SVN11X/doc_tesis/main.tex

\documentclass[letterpaper,12pt]{report}

\usepackage[english]{tracklang}

\usepackage[spanish,es-nodecimaldot,activeacute,es-lcroman]{babel}

\usepackage[no-math]{fontspec}
\setmainfont{Arial}

\usepackage{textcomp}
\usepackage{microtype}

\usepackage{amsmath}
\usepackage{amssymb}

\usepackage[defaultmathsizes]{mathastext}

% Letras griegas en la misma tipografía del texto (Arial).
% mathastext ya convierte las letras latinas; las griegas se redefinen aquí
% para que no queden con la tipografía por defecto de LaTeX.
\newfontfamily\utemgriega{Arial}

\newcommand{\utemgrk}[1]{\ensuremath{\mathord{\text{\utemgriega #1}}}}
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
\vspace{1ex}
\UTEMPaginaHeader\par\vspace{1ex}
\begingroup
\singlespacing
\setlength{\parskip}{0pt}
\setlength{\parindent}{0pt}
\@afterheading
\@starttoc{toc}
\endgroup
\clearpage
}

\renewcommand{\listoffigures}{
\clearpage
{\centering\normalfont\normalsize\bfseries \listfigurename\par}
\vspace{1ex}
\UTEMPaginaHeader\par\vspace{1ex}
\begingroup
\singlespacing
\setlength{\parskip}{0pt}
\setlength{\parindent}{0pt}
\@afterheading
\@starttoc{lof}
\endgroup
\clearpage
}

\renewcommand{\listoftables}{
\clearpage
{\centering\normalfont\normalsize\bfseries \listtablename\par}
\vspace{1ex}
\UTEMPaginaHeader\par\vspace{1ex}
\begingroup
\singlespacing
\setlength{\parskip}{0pt}
\setlength{\parindent}{0pt}
\@afterheading
\@starttoc{lot}
\endgroup
\clearpage
}

\providecommand{\l@algorithm}{}
\renewcommand{\l@algorithm}{\@dottedtocline{1}{1.5em}{2.3em}}
\renewcommand{\listofalgorithms}{
\clearpage
{\centering\normalfont\normalsize\bfseries ÍNDICE DE ALGORITMOS\par}
\vspace{1ex}
\UTEMPaginaHeader\par\vspace{1ex}
\begingroup
\singlespacing
\setlength{\parskip}{0pt}
\setlength{\parindent}{0pt}
\@afterheading
\@starttoc{loa}
\endgroup
\clearpage
}

\makeatother

\DeclareCaptionLabelFormat{utemfig}{Figura~#2}
\captionsetup[figure]{
labelformat=utemfig,
labelsep=colon,
labelfont=bf,
textfont=normalfont,
justification=centering,
singlelinecheck=false,
position=below
}

\DeclareCaptionLabelFormat{utemtab}{Tabla~#2}
\captionsetup[table]{
labelformat=utemtab,
labelsep=colon,
labelfont=bf,
textfont=normalfont
}

\usepackage{fancyhdr}

\pagestyle{fancy}
\fancyhf{}
\fancyfoot[R]{\thepage}
\renewcommand{\headrulewidth}{0pt}
\renewcommand{\footrulewidth}{0pt}

\fancypagestyle{plain}{
\fancyhf{}
\fancyfoot[R]{\thepage}
\renewcommand{\headrulewidth}{0pt}
\renewcommand{\footrulewidth}{0pt}
}

\usepackage{appendix}

\usepackage{xurl}
\urlstyle{same}

\usepackage[hidelinks]{hyperref}

\usepackage[toc]{glossaries}
\makeglossaries
\loadglsentries{3.Pag_final/3.glosario.tex}
\renewcommand{\glossaryname}{GLOSARIO}

\usepackage{csquotes}

\usepackage[
backend=biber,
style=apa,
natbib=true,
sortcites=true,
maxcitenames=2,
giveninits=true,
doi=true,
isbn=false,
eprint=false,
url=true
]{biblatex}

\addbibresource{referencias.bib}
\DeclareLanguageMapping{spanish}{spanish-apa}

\defbibenvironment{bibnum}
{\RaggedRight\begin{enumerate}[
label=\arabic*.,
leftmargin=*,
itemsep=0pt,
topsep=0pt,
align=left
]}
{\end{enumerate}}
{\item}

\newcommand{\utemFigure}[5]{
\begin{figure}[htbp]
\centering

\setlength{\fboxsep}{6pt}
\fbox{

}

\vspace{4pt}

\caption{#3}
\label{#5}

\vspace{2pt}

{\footnotesize\textit{Fuente: \citep{#4}.}}
\end{figure}
}

\newcommand{\utemFigurePropia}[4]{
\begin{figure}[htbp]
\centering

\setlength{\fboxsep}{6pt}
\fbox{

}

\vspace{4pt}

\caption{#3}
\label{#4}

\vspace{2pt}

{\footnotesize\textit{Fuente: Elaboración propia.}}
\end{figure}
}

\newenvironment{utemMultiFigure}[2]{
\def\utemMFcapt{#1}
\def\utemMFlab{#2}
\begin{figure}[H]
\centering
\setlength{\fboxsep}{6pt}
\providecommand{\addutem}{}
\renewcommand{\addutem}[4]{
\begin{subfigure}[b]{##1\textwidth}
\centering
\fbox{

}
\caption{##3}
\vspace{2pt}

{\footnotesize\textit{Fuente: \citep{##4}.}}
\end{subfigure}
}
}{
\vspace{4pt}
\caption{\utemMFcapt}
\label{\utemMFlab}
\end{figure}
}

\newenvironment{utemMultiFigurePropia}[2]{
\def\utemMFcapt{#1}
\def\utemMFlab{#2}
\begin{figure}[htbp]
\centering
\setlength{\fboxsep}{6pt}
\providecommand{\addutem}{}
\renewcommand{\addutem}[3]{
\begin{subfigure}[b]{##1\textwidth}
\centering
\fbox{

}
\caption{##3}
\end{subfigure}
}
}{
\vspace{4pt}
\caption{\utemMFcapt}
\label{\utemMFlab}

\vspace{2pt}

{\footnotesize\textit{Fuente: Elaboración propia.}}
\end{figure}
}

\newcounter{objEsp}
\newcommand{\ObEsp}{
\refstepcounter{objEsp}
OE\theobjEsp
}

\providecommand*{\objEspautorefname}{OE}

\sloppy

\begin{document}

\pagenumbering{roman}
\include{1-PagPreliminar/portada.tex}

\setcounter{page}{2}

\include{1-PagPreliminar/derecho_autor.tex}
\include{1-PagPreliminar/Nota.tex}
\include{1-PagPreliminar/dedicatoria.tex}
\include{1-PagPreliminar/agradecimiento.tex}

\clearpage
\tableofcontents
\clearpage
\listoftables
\clearpage
\listoffigures
\clearpage
\listofalgorithms
\clearpage

\include{1-PagPreliminar/resumen.tex}

\cleardoublepage
\pagenumbering{arabic}

\include{2.Texto/1.Intro.tex}
\include{2.Texto/2.estado_arte.tex}
\include{2.Texto/3.solucion_implementada.tex}
\include{2.Texto/4.marco_teorico.tex}
\include{2.Texto/5.implementacion.tex}
\include{2.Texto/6.resultados.tex}
\include{2.Texto/99.conclusion.tex}

\begingroup
\doublespacing
\printbibliography[
heading=bibintoc,
title={BIBLIOGRAFÍA},
env=bibnum
]
\endgroup

\printglossary[
title={GLOSARIO},
toctitle={GLOSARIO}
]

\begingroup
\singlespacing
\setlength{\parskip}{0pt}
\include{3.Pag_final/anexo.tex}
\endgroup

\end{document}
