SVN11X/doc_tesis/1-PagPreliminar/derecho_autor.tex

\begingroup
\newgeometry{top=2.0cm,bottom=2.2cm,left=2.0cm,right=2.0cm}

% Marcador del PDF (panel lateral). No se agrega a la tabla de contenido.
\pdfbookmark[0]{AUTORIZACIÓN DE REPRODUCCIÓN}{autorizacion}

\small
\setlength{\parindent}{0pt}
\setlength{\parskip}{0pt}
\setlength{\tabcolsep}{5pt}
\renewcommand{\arraystretch}{1.12}

\begin{center}
\textbf{Autorización para la Reproducción del Trabajo de Titulación}
\end{center}

\vspace{0.8cm}

1. Identificación del trabajo de titulación

\vspace{0.35cm}

Nombre del alumno\\[-0.05cm]
\mbox{}\dotfill\\[-0.05cm]
RUT \dotfill\\[-0.05cm]
Dirección \dotfill\\[-0.05cm]
E-mail \dotfill\\[-0.05cm]
Teléfono \dotfill

\vspace{0.45cm}

Título de la tesis\\[-0.05cm]
\mbox{}\dotfill\\[-0.05cm]
Escuela \dotfill\\[-0.05cm]
Carrera o programa \dotfill\\[-0.05cm]
Título al que opta \dotfill

\vspace{0.45cm}

2. Autorización de Reproducción (seleccione una opción)

\vspace{0.25cm}

\noindent a)
\hspace{1.0cm}
\begin{minipage}[t]{0.84\textwidth}
Este trabajo de titulación no puede reproducirse o transmitirse bajo ninguna forma o por ningún medio o procedimiento, sin permiso escrito del autor, exceptuando la cita bibliográfica, resumen y metadatos que acreditan al trabajo y a su autor.

\vspace{0.75cm}

Fecha: \rule{36mm}{0.1mm}
\hspace{2.2cm}
Firma: \rule{55mm}{0.1mm}
\end{minipage}

\vspace{0.9cm}

\noindent b)
\hspace{1.0cm}
\begin{minipage}[t]{0.84\textwidth}
Se autoriza la reproducción total o parcial de este trabajo de titulación, con fines académicos, por cualquier medio o procedimiento, incluyendo la cita bibliográfica que acredita al trabajo y a su autor.

\vspace{0.35cm}

En consideración a lo anterior, se autoriza su reproducción de forma (marque con una X):
\end{minipage}

\vspace{0.25cm}

\noindent
\begin{tabular}{|p{2.2cm}|p{\dimexpr\textwidth-2.2cm-4\tabcolsep-3\arrayrulewidth}|}
\hline
& Inmediata \\ \hline
& A partir de la siguiente fecha: \rule{28mm}{0.1mm} (mes/año) \\ \hline
\end{tabular}

\vspace{0.85cm}

\hspace{1.55cm}
Fecha: \rule{36mm}{0.1mm}
\hspace{2.2cm}
Firma: \rule{55mm}{0.1mm}

\vfill

Esta autorización se otorga en el marco de la ley N°17.336 sobre Propiedad Intelectual, con carácter gratuito y no exclusivo para la Institución.

\restoregeometry
\endgroup
