SVN11X/doc_tesis/1-PagPreliminar/Nota.tex

\thispagestyle{fancy}

% Marcador del PDF (panel lateral). No se agrega a la tabla de contenido.
\pdfbookmark[0]{NOTA OBTENIDA}{nota}

\vspace*{0.6 cm}

\begin{flushright}
\begin{minipage}{7.5cm}
    \centering

    {\Large\textbf{NOTA OBTENIDA:}}

    \vspace{3cm}

    \rule{7cm}{0.4pt}

    \vspace{0.4cm}

    {\large Firma y timbre de la}\\
    {\large autoridad responsable}
\end{minipage}
\end{flushright}
