SVN11X/doc_tesis/1-PagPreliminar/portada.tex

\begin{titlepage}
    \thispagestyle{empty}  % sin número de página
    % Marcador del PDF (panel lateral). No se agrega a la tabla de contenido.
    \pdfbookmark[0]{PORTADA}{portada}

    % Logo a la izquierda (sin entorno picture)
    \noindent
    \begin{minipage}{0.15\textwidth}
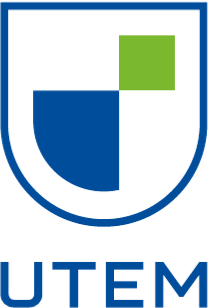
[picture p1: 1-PagPreliminar/logo_utem_oficial_2025_transparente_v2.png]
        
    \end{minipage}
    \begin{minipage}{0.8\textwidth}
        \small
        UNIVERSIDAD TECNOLÓGICA METROPOLITANA \\
        FACULTAD DE INGENIERÍA \\
        DEPARTAMENTO DE ELECTRICIDAD \\
        ESCUELA DE ELECTRÓNICA
    \end{minipage}

    \vfill  % empuja el contenido hacia abajo

    \begin{center}
        {\Large \textbf{NAVEGACIÓN Y EXPLORACIÓN AUTÓNOMA DE INTERIORES UTILIZANDO UN ROBOT MÓVIL DE TRACCIÓN DIFERENCIAL} \par}
        \vspace{1cm}
        {\Large TRABAJO DE TITULACIÓN PARA OPTAR AL TÍTULO DE INGENIERO CIVIL ELECTRÓNICO \par}
    \end{center}

    \vfill

    \begin{flushright}
        {\Large \textbf{AUTOR:} \par}
        {\Large VALDERAS NECULQUEO, SEBASTIÁN \par}
        \vspace{1cm}
        {\Large \textbf{PROFESOR GUÍA:} \par}
        {\Large GALARCE ACEVEDO, PATRICIO \par}
    \end{flushright}

    \vfill
    \vfill  % doble vfill para separar más antes de la ciudad/fecha

    \begin{center}
        {\Large SANTIAGO - CHILE \par}
        {\Large 2026 \par}
    \end{center}

\end{titlepage}
