SVN11X/doc_tesis/2.Texto/5.implementacion.tex

\chapter{IMPLEMENTACIÓN}
\label{ch:implementacion}

Este capítulo describe la materialización de la solución implementada y la
integración de sus principales componentes. Se presentan las decisiones de
diseño, los elementos físicos y de \textit{software} utilizados, y la configuración
necesaria para la operación del prototipo tanto en simulación como en \textit{hardware} real. Los detalles complementarios de implementación, configuración y verificación se incluyen en los anexos correspondientes.

\section{Componentes y parámetros del prototipo}
\label{ch:componentes}

El prototipo corresponde a una plataforma diferencial de bajo costo para interiores: controla el desplazamiento mediante la diferencia de velocidad entre las ruedas motrices izquierda y derecha. El costo de los materiales montados en el robot es de 444\,643~CLP y el del proyecto completo, de 582\,447~CLP, sin incluir la estación de trabajo necesaria para el mapeo, la navegación y la exploración (Tabla~\ref{tab:anx_costos}). Ese costo es menor que el de la plataforma comercial comparable más cercana (Tabla~\ref{tab:comparacion_costos}).

\subsection{Configuración general del prototipo}

La locomoción se implementa mediante dos motorreductores JGA25-370 de 12~V,
equipados con \textit{encoders} incrementales de cuadratura. El \gls{Arduino} Nano
realiza la lectura de estos sensores y ejecuta el control de velocidad PI incremental,
mientras que el \textit{driver} L298N aplica las señales \gls{PWM} a los motores. La
Raspberry Pi~4 ejecuta la interfaz de \textit{hardware}, adquiere los barridos del
RPLidar A1 y se comunica con la estación de trabajo, donde se ejecutan las
funciones de mapeo, navegación y exploración.
La arquitectura de alimentación y la distribución eléctrica se detallan en
la Sec.~\ref{chap:robot_real}. El chasis y las cubiertas se fabrican
mediante impresión 3D FDM en PLA+, tomando como referencia una plataforma
diferencial de código abierto
\citep{marcuslanzoni2020vacuum}.
En la Fig.~\ref{fig:prototipo} se muestra una vista lateral del prototipo
construido, donde se distinguen el chasis impreso y el LIDAR.

\utemFigurePropia{2.Texto/Imag/fig_prototipo_lateral_izquierda.jpg}{0.5\linewidth}
{Vista lateral del prototipo construido.}
{fig:prototipo}

\subsection{Parámetros físicos y temporales de implementación}
\label{sec:parametros_modelo}

La Tabla~\ref{tab:parametros_modelo} reúne los parámetros físicos y temporales
utilizados por el modelo y la interfaz de \textit{hardware}. Las frecuencias
$f_{\mathrm{ctrl}}$ y $f_{\mathrm{loop}}$ coinciden numéricamente, pero
corresponden a mecanismos independientes; la temporalidad interna del \textit{firmware}
y la correspondencia entre cada parámetro y su identificador en el código se
consolidan en el \ref{anx:implementacion_diffdrive} y en el
\ref{anx:identificadores}.

\begin{table}[htbp]
\centering
\caption{Parámetros físicos y temporales empleados en la implementación.}
\label{tab:parametros_modelo}
\small
\begin{tabular}{P{1.4cm} P{3.5cm} P{2.8cm} P{5.8cm}}
\toprule
\textbf{Símbolo} &
\textbf{Parámetro} &
\textbf{Valor} &
\textbf{Uso principal} \\
\midrule

$r$ &
Radio de rueda &
0.0335~m &
Modelo cinemático, odometría y conversión de velocidad. \\

$b$ &
Separación entre ruedas &
0.188~m &
Modelo cinemático diferencial. \\

$N_e$ &
Resolución unificada utilizada &
1980~\textit{ticks}/vuelta &
\textit{Firmware}, interfaz de \textit{hardware} y odometría. \\

$f_{\mathrm{ctrl}}$ &
Frecuencia del ciclo de \texttt{ros2\_control} &
30~Hz &
Ciclo de lectura, actualización y escritura de la interfaz de \textit{hardware}. \\

$f_{\mathrm{loop}}$ &
Frecuencia usada en la conversión de consignas &
30~Hz &
Conversión de consignas de rueda a \textit{ticks/frame}. \\

\bottomrule
\end{tabular}
\end{table}

El valor unificado $N_e=1980$~\textit{ticks}/vuelta corresponde al valor
efectivamente utilizado por el \textit{firmware} y la interfaz de \textit{hardware} durante
los ensayos. La calibración experimental por rueda produce promedios
ligeramente distintos; las muestras, los promedios y el error sistemático
asociado al uso de este valor unificado se conservan en el
\ref{anx:pid_data}.

\section{Gemelo digital del robot}
\label{ch:robot_digital}

Sobre la base del propósito de validación expuesto en la
Sec.~\ref{sec:gemelo_digital}, el gemelo digital se implementa en
\gls{ROS2} Foxy mediante URDF/\texttt{xacro} y Gazebo Classic 11.11.0. El radio de rueda y
la separación entre ruedas de la Tabla~\ref{tab:parametros_modelo} se
emplean como referencia geométrica común en el robot físico, el modelo
digital y \texttt{diff\_drive\_controller}. El \textit{backend}
\texttt{GazeboSystem} entrega directamente los estados de las
articulaciones, por lo que no utiliza la conversión por \textit{ticks} ni el
planificador del controlador de velocidad del \textit{firmware}. La Fig.~\ref{fig:robot_sim} muestra el modelo
cargado en Gazebo Classic.

\utemFigurePropia{2.Texto/Imag/fig_robot_sim.PNG}{0.55\textwidth}
{Modelo del robot (gemelo digital) cargado en Gazebo Classic.}
{fig:robot_sim}

\subsection{Arquitectura del modelo digital}
\label{sec:atribucion}

El modelo digital se organiza mediante una descripción \texttt{xacro} modular: la estructura mecánica se define una sola vez y el sensor láser se selecciona según el entorno de ejecución, de modo que \textit{hardware} real y simulación comparten la misma geometría. El inventario de archivos, su función y su localización se consolidan en el \ref{anx:rutas_software}. La geometría del modelo se presenta acotada en la Fig.~\ref{fig:anx_cotas} del \ref{anx:validacion_urdf}.
La contribución principal en esta etapa corresponde al diseño del modelo URDF/\texttt{xacro}, la parametrización geométrica del robot, la definición de marcos de referencia y la integración con los sistemas de control, SLAM y navegación. La atribución completa de paquetes propios, adaptados y externos se documenta en el \ref{anx:workspace}.

\subsection{Estructura URDF/xacro y marcos de referencia}
\label{sec:tf-convenciones}

El modelo se organiza como un árbol de eslabones y articulaciones cuyo marco
principal es \texttt{base\_link}, solidario al cuerpo del robot. De él se deriva
\texttt{base\_footprint}, el marco de contacto del robot con el suelo, que en
este modelo se declara como un eslabón hijo fijo y coincidente con
\texttt{base\_link}. La organización de estos marcos sigue las convenciones
REP-103 y REP-105 descritas en la Sec.~\ref{sec:robot_definicion}
\citep{rep103,rep105}, que fijan la orientación de los ejes y la jerarquía entre
el marco del mapa, el odométrico y el de la base.
La cadena de transformaciones principal es:

\begin{center}
\texttt{map} $\rightarrow$ \texttt{odom} $\rightarrow$ \texttt{base\_link} $\rightarrow$ \texttt{laser\_frame},
\end{center}

\noindent donde \texttt{map} es el marco global del mapa, \texttt{odom} el marco
odométrico (continuo, con deriva) y \texttt{laser\_frame} el marco del sensor
láser; de esta cadena cuelga, además, la rama fija
\texttt{base\_link}$\rightarrow$\texttt{base\_footprint}.
Sobre esta estructura, el marco que \texttt{slam\_toolbox} y AMCL declaran como
base para localizar al robot (\texttt{base\_link} o \texttt{base\_footprint})
no es el mismo en simulación que en \textit{hardware} real. Esa asignación por entorno,
la correspondencia entre componentes, marcos y tópicos, y la verificación
estructural del árbol se documentan en el \ref{anx:gemelo_digital}.

Dado que \texttt{base\_footprint} está unido a \texttt{base\_link}
mediante una transformación fija identidad, con traslación y rotación nulas,
esta diferencia de identificador no introduce un desfase geométrico entre
ambos marcos. Se conserva, no obstante, la asignación específica de cada
entorno porque corresponde a la configuración efectivamente utilizada.

\subsection{Selección del \texorpdfstring{\textit{backend}}{backend} de control}
\label{sec:backend}

El modelo utiliza en ambos entornos \texttt{ros2\_control}, el \textit{framework} de
\gls{ROS2} que estandariza el acceso al \textit{hardware} mediante interfaces de
comando y de estado, pero carga un \textit{plugin} de \textit{hardware} distinto en cada caso,
como resume la Tabla~\ref{tab:xacro_args_backend}. La interfaz empleada en el robot real se
describe en la Sec.~\ref{sec:diff_drive_params}; la trazabilidad completa de
la selección se conserva en el \ref{anx:gemelo_digital}.

\begin{table}[htbp]
\centering
\caption{\textit{Plugin} de \texttt{ros2\_control} según entorno de ejecución.}
\label{tab:xacro_args_backend}
\small
\begin{tabular}{p{2.5cm} p{4.0cm} p{7.0cm}}
\toprule
\textbf{Entorno} & \textbf{\textit{Plugin} de \textit{hardware}} & \textbf{Fuente de los estados} \\
\midrule
\textit{Hardware} real & \texttt{DiffDriveArduino} & Conteos de \textit{encoder} recibidos desde el \gls{Arduino} mediante el enlace serial. \\
Simulación & \texttt{GazeboSystem} & Estados de las articulaciones entregados directamente por Gazebo Classic. \\
\bottomrule
\end{tabular}
\end{table}

\subsection{Sensor láser simulado y criterios de aceptación}
\label{sec:laser_sim}

En simulación, el sensor se modela mediante el complemento de simulación correspondiente, publicando datos en \texttt{/scan} con el marco \texttt{laser\_frame}. El modelo reproduce el comportamiento general del RPLidar A1 físico, aunque con diferencias propias de la simulación; estas diferencias se consideran parte de la brecha simulación--realidad y se detallan en el \ref{anx:gemelo_digital}. La Fig.~\ref{fig:gazebo_laser} muestra el barrido del LIDAR simulado dentro del mundo de prueba con obstáculos.

\utemFigurePropia{2.Texto/Imag/gazebo_laser_robot.png}{0.72\textwidth}
{Barrido del LIDAR 2D simulado en el mundo de prueba con obstáculos.}
{fig:gazebo_laser}

El barrido cubre el plano horizontal del escenario y se interrumpe en las
superficies visibles de los obstáculos, generando zonas de oclusión detrás de
ellos. Esta respuesta permite verificar la coherencia entre la posición del
sensor, su marco de referencia y la geometría del mundo simulado antes de
utilizar los datos en los procesos de SLAM y navegación.
Antes de usar el gemelo digital para pruebas de SLAM y navegación, se aplican los criterios de aceptación resumidos en la Tabla~\ref{tab:criterios_aceptacion_resumen} del \ref{anx:gemelo_digital}, donde también se conserva la evidencia estructural.

\section{Construcción de \texorpdfstring{\textit{hardware}}{hardware} y comunicación con ROS 2}
\label{chap:robot_real}

Esta sección describe la arquitectura físico-electrónica del robot y su integración con \gls{ROS2} Foxy sobre la Raspberry Pi 4. Los detalles operativos y de configuración extendida se trasladan al \ref{anx:hardware_ros2}.

\subsection{Arquitectura física y de datos}

La Fig.~\ref{fig:prototipo_planta} presenta la vista en planta del prototipo,
donde se aprecian el montaje del RPLidar A1 y el panel de control con el
interruptor de encendido y el visualizador de tensión y corriente.

\utemFigurePropia{2.Texto/Imag/fig_prototipo_planta.jpg}{0.4\linewidth}
{Vista en planta del prototipo construido.}
{fig:prototipo_planta}

La plataforma se organiza en dos dominios principales. El dominio de potencia
utiliza un bus de 12~V proveniente de la batería para alimentar los motores DC
mediante el \textit{driver} L298N. A partir del mismo bus, un módulo reductor
\textit{DC-DC Power Module} de 25 W genera un riel regulado de 5~V para
alimentar la Raspberry Pi, el \gls{Arduino}, el \gls{LIDAR} y los
periféricos. Esta separación reduce la interferencia eléctrica producida por los motores sobre la electrónica de control.
El dominio de comunicaciones conecta la Raspberry Pi con el
\gls{Arduino} mediante un enlace serial USB para intercambiar referencias de
velocidad y datos de \textit{encoders}. El RPLidar A1 se conecta a un puerto serie UART
de la Raspberry Pi, y un nodo de adquisición desarrollado para este trabajo
convierte su trama en los barridos utilizados por el sistema de percepción
(\ref{anx:nodo_lidar}). La asignación de dispositivos y su
identificación persistente se documentan en el \ref{anx:hardware_ros2}. La
Fig.~\ref{fig:esquema_conexiones} resume las conexiones eléctricas y de
datos del prototipo.

\utemFigurePropia{2.Texto/Imag/circuit_diagram.png}{0.99\textwidth}
{Esquema de conexiones eléctricas y de datos del robot diferencial.}
{fig:esquema_conexiones}

\subsection{Integración con ROS 2}

En \textit{hardware} real, un único archivo de lanzamiento inicia los nodos necesarios
para publicar la descripción del robot, activar \texttt{ros2\_control} y
cargar el controlador diferencial junto con el difusor de estados de
articulación. El inventario de nodos y la responsabilidad de cada uno se
documentan en el \ref{anx:nodos_lanzamiento}.
La cadena de transformaciones mantiene la misma convención usada en simulación (Sec.~\ref{sec:tf-convenciones}): \texttt{slam\_toolbox} publica \texttt{map}$\rightarrow$\texttt{odom}, mientras que \texttt{diff\_drive\_controller} publica \texttt{odom}$\rightarrow$\texttt{base\_link} a partir de la odometría de \textit{encoders}.

\subsection{Control diferencial e interfaz de \texorpdfstring{\textit{hardware}}{hardware}}
\label{sec:diff_drive_params}

El controlador diferencial recibe comandos de velocidad lineal y angular, y los convierte en velocidades de rueda mediante el modelo cinemático descrito en el Capítulo~\ref{marco_teorico}. Su geometría corresponde al radio de rueda $r$ y a la separación entre ruedas $b$ (Tabla~\ref{tab:parametros_modelo}). Los parámetros principales configurados en el controlador diferencial se
resumen en la Tabla~\ref{tab:diff_drive_params}.

\begin{table}[htbp]
\centering
\caption{Parámetros principales del controlador diferencial.}
\label{tab:diff_drive_params}
\small
\begin{tabular}{llp{6.7cm}}
\toprule
\textbf{Parámetro} & \textbf{Valor} & \textbf{Descripción} \\
\midrule
Velocidad lineal & $-0.13/0.13$~m/s & Límites aplicados a la consigna lineal. \\
Velocidad angular & $-0.35/0.35$~rad/s & Límites aplicados a la consigna angular. \\
Publicación de odometría & Habilitada & Publica \texttt{odom}$\rightarrow$\texttt{base\_link}. \\
\bottomrule
\end{tabular}
\end{table}

La comunicación entre \texttt{diff\_drive\_controller} y el \textit{firmware} se
realiza mediante \texttt{DiffDriveArduino}, una interfaz de \textit{hardware} adaptada
del proyecto \texttt{diffdrive\_arduino}~\citep{newans_diffdrive} e integrada
al \textit{framework} \texttt{ros2\_control}~\citep{openrobotics2024ros2control}. La
interfaz intercambia con el \gls{Arduino}, mediante el enlace serial, las
referencias de velocidad de rueda y las lecturas de \textit{encoder}. Su ciclo de lectura--actualización--escritura se ejecuta con la
frecuencia $f_{\mathrm{ctrl}}$ indicada en la
Tabla~\ref{tab:parametros_modelo}.
En la fase de escritura, las consignas de rueda se convierten a
\textit{ticks/frame}; en la fase de
lectura, los conteos acumulados $c_j[k]$ se convierten en posición y
velocidad angular mediante las Ecs.~\eqref{eq:posicion_rueda_encoder}
y~\eqref{eq:w_ruedas}, para $j\in\{R,L\}$, con el intervalo $\Delta t_k$. Las interfaces expuestas y el
desarrollo de ambas conversiones se conservan en el
\ref{anx:implementacion_diffdrive}.
Las ganancias del controlador no se transmiten en tiempo de ejecución: residen en el
\textit{firmware} con los valores obtenidos mediante el procedimiento descrito en la
Sec.~\ref{sec:sintonizacion_pso}.

\subsection{Flujo de datos del sistema}
\label{sec:flujo_datos}

El Alg.~\ref{alg:ros2control_cycle} formaliza el flujo completo entre
\gls{ROS2}, la interfaz de \textit{hardware} y el \textit{firmware}. Corresponde al ciclo de
lectura--actualización--escritura que \texttt{ros2\_control} repite con la
frecuencia $f_{\mathrm{ctrl}}$ (Sec.~\ref{sec:diff_drive_params}): en cada
iteración, la interfaz lee los \textit{encoders} desde el \gls{Arduino}, reconstruye el
estado de cada rueda, actualiza el controlador diferencial y devuelve al
\textit{firmware} las nuevas referencias de velocidad. Las conversiones y el intervalo
$\Delta t_k$ empleados se describen en la Sec.~\ref{sec:diff_drive_params} y en
el \ref{anx:implementacion_diffdrive}.

\begin{algorithm}[htbp]
\caption{Ciclo ejecutado por la interfaz \texttt{DiffDriveArduino}.}
\label{alg:ros2control_cycle}
\begin{algorithmic}[1]
\Require Comandos $\omega_L^{\mathrm{cmd}},\omega_R^{\mathrm{cmd}}$; enlace serial; resolución $N_e$; frecuencia $f_{\mathrm{loop}}$.
\Ensure Estados de rueda exportados y referencias enviadas al {\itshape firmware\/}.
\State $t_{\mathrm{prev}}\gets\Call{TiempoActual}{}$
\State Leer parámetros de ruedas y comunicación.
\State $\delta\phi\gets 2\pi/N_e$
\State Abrir el puerto serial.
\State Esperar $3000$~ms y vaciar el búfer de entrada.
\State Enviar un retorno de carro vacío.
\While{la interfaz esté iniciada}
\If{el puerto serial está cerrado}
\State \Return \texttt{ERROR}
\EndIf
\Statex
\State $t_k\gets\Call{TiempoActual}{}$
\State $\Delta t_k\gets t_k-t_{\mathrm{prev}}$
\State $t_{\mathrm{prev}}\gets t_k$
\State $\texttt{resp}\gets\Call{SolicitarSerial}{\texttt{e}}$
\State $(c_L[k],c_R[k])\gets\Call{ConvertirEnteros}{\texttt{resp}}$
\For{$j\in\{L,R\}$}
\State $(\phi_j[k],\widehat{\omega}_j[k])
\gets\Call{ActualizarEstadoRueda}{c_j[k],\Delta t_k}$
\EndFor
\State Exportar $(\widehat{\omega}_L,\phi_L,\widehat{\omega}_R,\phi_R)$.
\State \Call{ActualizarControladorDiferencial}{}.
\Statex
\If{el puerto serial está cerrado}
\State \Return \texttt{ERROR}
\EndIf
\For{$j\in\{L,R\}$}
\State $m_j^{\mathrm{cmd}}
\gets\Call{ConvertirATicksFrame}
{\omega_j^{\mathrm{cmd}},N_e,f_{\mathrm{loop}}}$
\EndFor
\State \Call{EnviarComando}{\texttt{m},$m_L^{\mathrm{cmd}},m_R^{\mathrm{cmd}}$}
\EndWhile
\end{algorithmic}
\end{algorithm}

El Alg.~\ref{alg:ros2control_cycle} distingue una inicialización que se ejecuta una sola vez, donde se
abre el puerto serial y se calcula el paso angular por \textit{tick}
$\delta\phi=2\pi/N_e$, de un ciclo permanente. Las dos comprobaciones del puerto
señalan un error y terminan el ciclo ante pérdida del enlace, y se complementan
con la autodetención de seguridad de la Sec.~\ref{sec:bucle_principal}. El
intervalo $\Delta t_k$ y las conversiones se detallan en el
\ref{anx:implementacion_diffdrive}.

\subsection{Teleoperación y multiplexación de comandos}

La teleoperación permite conducir el robot de forma manual, tanto para pruebas
de desplazamiento como para posicionarlo antes de iniciar cada ensayo. Se
realiza con un mando inalámbrico cuyas palancas se convierten en comandos de velocidad lineal y angular. Como
mecanismo de seguridad, el mando solo publica comandos mientras se mantiene
presionado un botón de habilitación, de modo que al soltarlo el robot se
detiene.

Los comandos manuales y los de Nav2 se integran mediante el multiplexor
\texttt{twist\_mux}, que selecciona una única fuente según prioridades y
descarta las que dejan de emitir. La teleoperación tiene prioridad, así el
operador puede retomar el control en cualquier momento. La salida del
multiplexor se remapea a la entrada del controlador diferencial
(Sec.~\ref{sec:diff_drive_params}) y aparece en la arquitectura de navegación
de la Fig.~\ref{fig:interaccion_nav}. Los nodos, las prioridades y el remapeo
se documentan en el \ref{anx:hardware_ros2}.

\section{\texorpdfstring{\textit{Firmware}}{Firmware} de bajo nivel en Arduino Nano}
\label{ch:setup_arduino}

El \textit{firmware} \texttt{ROSArduinoBridge} parte de un proyecto de código abierto homónimo~\citep{newans_rosarduinobridge} y se adapta para este trabajo, incorporando ganancias independientes por rueda, una banda muerta sobre el error y la resolución efectiva de \textit{encoders} del prototipo, sin modificar la estructura de su ley de control. Cumple cuatro funciones principales: comunicación serial con \gls{ROS2} mediante \texttt{ros2\_control}, lectura de \textit{encoders}, control de velocidad PI incremental por rueda y autodetención de seguridad ante pérdida de comandos.

\subsection{Arquitectura modular y constantes físicas}

El \textit{firmware} se organiza en módulos independientes, cuya descomposición, junto
con el inventario de archivos y rutas, se conserva en el \ref{anx:firmware}.
Utiliza la geometría y la resolución efectiva de \textit{encoders} de la
Tabla~\ref{tab:parametros_modelo} para expresar las referencias y mediciones en
\textit{ticks/frame}. La temporalidad interna del controlador es independiente
del ciclo de \texttt{ros2\_control}, y su programación se documenta en el
\ref{anx:implementacion_diffdrive}.

\subsection{Comunicación serial y lectura de \texorpdfstring{\textit{encoders}}{encoders}}
\label{sec:serial_firmware}

La comunicación entre la Raspberry Pi y el \gls{Arduino} se realiza mediante el protocolo serial textual del enlace descrito en la Sec.~\ref{chap:robot_real}. El conjunto de comandos implementado incluye lectura de \textit{encoders}, referencias de velocidad, carga de ganancias y accionamiento directo en lazo abierto, y se presenta en la Tabla~\ref{tab:protocolo_serial} del \ref{anx:protocolo_serial}.

La lectura de los \textit{encoders} no ocurre dentro del bucle principal. Cada cambio
de nivel en los canales de un \textit{encoder} dispara una interrupción de cambio de
pin, cuya rutina actualiza el contador de esa rueda. De este modo el conteo
avanza mediante interrupciones, en paralelo a la ejecución del programa principal
y sin depender directamente de su tiempo de ciclo. Este mecanismo permite
registrar transiciones mientras el bucle atiende el protocolo serial o el control
de velocidad, sin asumir que todas las transiciones puedan registrarse bajo cualquier
condición temporal. El programa principal solo
lee el valor acumulado cuando lo necesita: en cada ciclo del controlador para calcular
la velocidad de cada rueda, y al responder el comando de lectura de \textit{encoders},
a partir del cual la Raspberry Pi estima la odometría.
Los conteos recibidos por el enlace serial se interpretan mediante la
resolución efectiva $N_e$ (Tabla~\ref{tab:parametros_modelo}). El
tratamiento de la lectura no atómica de los contadores se conserva en el
\ref{anx:pid_data}.

\subsection{Control de velocidad en el \texorpdfstring{\textit{firmware}}{firmware}}
\label{sec:motorcontrol_pid}

El controlador de velocidad se ejecuta de forma independiente para cada rueda en el Arduino Nano, con la referencia y la medición expresadas en \textit{ticks/frame} y un período de ejecución $T_{\mathrm{PID,sched}}=33$~ms. La ley se implementa en tiempo discreto con una forma incremental acumulativa, en la que el término asociado a $K_{d,j}$ se calcula sobre la diferencia de la medición. Las Ecs.~\eqref{eq:pid_fw_incremento}, \eqref{eq:pid_fw_integrador} y~\eqref{eq:pid_fw_salida} resumen el incremento de control, la actualización del integrador y la salida saturada:

\begin{align}
\Delta u_j^{\mathrm{long}}[k]
&=
\operatorname{trunc}_0\!\left(
\frac{
K_{p,j}e_j^{\mathrm{db}}[k]
-
K_{d,j}\bigl(m_j^{\mathrm{int}}[k]-m_j^{\mathrm{int}}[k-1]\bigr)
+
I_j^{\mathrm{int}}[k]
}{
K_o
}\right),
\label{eq:pid_fw_incremento}\\
I_j^{\mathrm{int}}[k+1]
&=
\begin{cases}
\operatorname{trunc}_0\!\bigl(I_j^{\mathrm{int}}[k]+K_{i,j}e_j^{\mathrm{db}}[k]\bigr),
& |u_j^{\mathrm{raw}}[k]|<255,\\
I_j^{\mathrm{int}}[k], & \text{en otro caso},
\end{cases}
\label{eq:pid_fw_integrador}\\
u_j[k]
&=
\operatorname{sat}_{[-255,255]}
\bigl(u_j[k-1]+\Delta u_j^{\mathrm{long}}[k]\bigr).
\label{eq:pid_fw_salida}
\end{align}

\noindent donde $K_{p,j}$, $K_{i,j}$ y $K_{d,j}$ son las ganancias de la rueda $j$
que el \textit{firmware} original denomina proporcional, integral y derivativa, cuya
acción efectiva se aclara más adelante; $e_j^{\mathrm{db}}[k]$ es el
error discreto de velocidad tras la banda muerta; $m_j^{\mathrm{int}}[k]$ la
medición de velocidad en la escala interna del \textit{firmware}; $I_j^{\mathrm{int}}[k]$
el estado integral, actualizado según la condición de saturación;
$\Delta u_j^{\mathrm{long}}[k]$ el incremento de control; $u_j[k]$ la salida
acumulada saturada; $K_o$ el divisor de escalamiento de la salida, común a ambas
ruedas; y $\operatorname{sat}_{[-255,255]}(\cdot)$ la saturación al intervalo PWM
permitido. Se define $u_j^{\mathrm{raw}}[k]=u_j[k-1]+\Delta
u_j^{\mathrm{long}}[k]$, y $\operatorname{trunc}_0$ representa la conversión
entera con truncamiento hacia cero, dentro del rango representable del tipo
de destino.

La estructura anterior resume el controlador ejecutado en el
\textit{firmware} y no coincide exactamente con la forma incremental estándar de un PID. En
particular, el término $K_{p,j}e_j^{\mathrm{db}}[k]$ forma parte del incremento
que posteriormente se suma a la salida anterior $u_j[k-1]$, por lo que su
efecto también se acumula entre ciclos. Además, el estado
$I_j^{\mathrm{int}}[k]$ acumula separadamente el término
$K_{i,j}e_j^{\mathrm{db}}[k]$ cuando su actualización está habilitada. En consecuencia, las ganancias reportadas en
este trabajo caracterizan esta realización discreta específica y no deben
interpretarse según el nombre que reciben en el \textit{firmware}. Esta estructura
es la misma del \textit{firmware} original~\citep{newans_rosarduinobridge,hbrobotics_rosarduinobridge}
y no se modifica en este trabajo ni durante los ensayos, por lo que los
resultados experimentales del Capítulo~\ref{ch:resultados} corresponden al
controlador efectivamente implementado. Su origen y los cambios introducidos
respecto del original se detallan en el \ref{anx:pid_origen}.

Si se desprecian la saturación y los truncamientos enteros, y se parte de un
reinicio con la salida acumulada, la medición previa y el estado integral en
cero, la salida acumulada puede escribirse sin incrementos, como indica la
Ec.~\eqref{eq:pid_equivalente}:
\begin{equation}
u_j[k]=\frac{K_{p,j}\,S_j^{e}[k]-K_{d,j}\,m_j^{\mathrm{int}}[k]+S_j^{I}[k]}{K_o},
\label{eq:pid_equivalente}
\end{equation}
\noindent donde $S_j^{e}[k]=S_j^{e}[k-1]+e_j^{\mathrm{db}}[k]$ es el error
acumulado desde el reinicio y $S_j^{I}[k]=S_j^{I}[k-1]+I_j^{\mathrm{int}}[k]$
la acumulación del estado integral, ambos con valor inicial cero. Esta forma
muestra el efecto real de cada ganancia. $K_{p,j}$ multiplica el error
acumulado, por lo que actúa como ganancia integral. $K_{d,j}$ multiplica la
medición actual, por lo que actúa como ganancia proporcional sobre la medición
y no como acción derivativa. $K_{i,j}$ actúa sobre una acumulación del estado
integral, es decir, como una segunda integración. La ley ejecutada no contiene
una acción derivativa efectiva.

Al omitir el estado adicional y prescindir de la banda muerta, la saturación
y el truncado, la ley idealizada coincide con la forma
incremental del PID descrita por \citet[Sec.~13.4]{astrom2009controlpid} y
presentada en la Ec.~\eqref{eq:pi_incremental} del \ref{anx:estabilidad_pid},
con la integral aproximada por
diferencia hacia atrás, sin acción derivativa y con ponderación nula del punto
de consigna en la acción proporcional. En esa correspondencia, $K_{d,j}/K_o$
cumple el papel de la ganancia proporcional y $K_{p,j}/K_o$ el del coeficiente
integral por muestra, de modo que la ley idealizada es un controlador PI
incremental, es decir, un PID sin acción derivativa, y así se denomina en este
trabajo. El nombre PID se conserva para la familia de controladores, para el
\hyperref[oe2]{OE2} y para los nombres del \textit{firmware} y de sus
\textit{scripts}, como $K_p$, $K_i$, $K_d$ o \texttt{doPID()}. Con ponderación nula, la referencia solo
entra en el término integral, lo que evita saltos de la señal de control y
reduce la sobreelongación ante cambios del punto de consigna
\citep[Sec.~3.4]{astrom2009controlpid}. La rueda derecha opera en esa
condición, porque su estado integral permanece en cero, y en la izquierda ese
estado solo crece con errores grandes (Sec.~\ref{sec:resultados_pid}).

Esta ley se conserva en lugar de reemplazarla por otra formulación del PID o
por una ley escrita desde cero, por tres razones. La primera es que el PI
incremental utilizado es uno de los controladores más usados en robótica móvil.
El PI es el controlador más común
\citep[Sec.~3.6]{astrom2009controlpid} y el PID, el algoritmo de control más
usado en sistemas robóticos \citep{raj2024discussion}, también en robots móviles
\citep{bitria2022optimal}. Su forma incremental, de la que este PI es el caso
sin acción derivativa, se usa en el lazo de velocidad de robots diferenciales de
laboratorio \citep{casini2010remote}, de vehículos autoequilibrados de dos
ruedas \citep{ma2024selfbalancing}, de andadores robóticos controlados con
Arduino \citep{mori2024walker} y de plataformas con ROS~2 que, como la de este
trabajo, envían las consignas de velocidad a la placa de control por puerto serie
\citep{wu2026ros2}. También regula el deslizamiento de las ruedas motrices de
vehículos agrícolas \citep{sun2022travel} y está presente desde los primeros
controladores de motores \citep[Sec.~13.4]{astrom2009controlpid}. La segunda es
que conservarla permite reutilizar una implementación ya integrada con la
interfaz \texttt{diffdrive\_arduino}~\citep{newans_diffdrive}, que usa el
protocolo serial de este \textit{firmware}, y concentrar el desarrollo en la
navegación y la exploración. Mantener un algoritmo por compatibilidad con el
equipo existente es, además, una de las razones por las que los fabricantes
conservan la forma incremental \citep[Sec.~13.4]{astrom2009controlpid}. La
tercera es que la forma incremental es útil aun cuando la integración se realiza
dentro del controlador, porque simplifica la protección contra el
\textit{windup} del integrador y permite realizar la mayoría de los cálculos
solo con incrementos \citep[Secs.~13.1 y 13.4]{astrom2009controlpid}, propiedad
por la que también se adopta en implementaciones de referencia del PID
\citep{sundstrom2024reference}. La elección no responde a una
comparación de desempeño con otras leyes, que no forma parte de los objetivos
del trabajo y queda como trabajo futuro.

La ejecución concreta incorpora variables enteras, truncamiento hacia cero,
bandas muertas distintas por rueda y actualización condicional del integrador.
Las ecuaciones exactas y sus tipos de datos se conservan en el
\ref{anx:pid_ecuaciones}. Las
ganancias definitivas se presentan en la Tabla~\ref{tab:ganancias_pid}; el orden
de ejecución, los reinicios y la saturación se detallan en el
Alg.~\ref{alg:pid_firmware}.

\begin{table}[htbp]
\centering
\caption{Ganancias definitivas del controlador codificadas en el \textit{firmware}.}
\label{tab:ganancias_pid}
\small
\begin{tabular}{lcc}
\toprule
\textbf{Parámetro} & \textbf{Rueda izquierda} & \textbf{Rueda derecha} \\
\midrule
$K_p$ & 16.00 & 16.42 \\
$K_d$ & 20.30 & 20.05 \\
$K_i$ & 0.075 & 0.001 \\
$K_o$ & 50 & 50 \\
\bottomrule
\end{tabular}
\vspace{3pt}
\parbox{0.85\linewidth}{\footnotesize Las ganancias se aplican en la escala interna del \textit{firmware}. Sin el término asociado a $K_i$, equivalen a un PI incremental con ganancia proporcional $K_d/K_o$ de 0.41 y 0.40~PWM por \textit{tick/frame} y tiempo integral de 42 y 40~ms (\ref{anx:estabilidad_pid}).}
\end{table}

\begin{algorithm}[htbp]
\caption{Rutinas de reinicio y actualización del controlador discreto ejecutadas por el \textit{firmware}.}
\label{alg:pid_firmware}
\begin{algorithmic}[1]
\Require Conteos $c_L,c_R$; referencias \texttt{TargetTicksPerFrame}; ganancias y límites de saturación definidos previamente.
\Ensure Salidas PWM y estados internos actualizados.
\Procedure{resetPID}{}
\State Cargar las ganancias predeterminadas de ambas ruedas.
\State Leer los conteos actuales de los {\itshape encoders\/}.
\State Inicializar \texttt{output}, \texttt{PrevInput} e \texttt{ITerm} en cero.
\EndProcedure
\Statex
\Procedure{updatePID}{}
\State Leer $c_L[k]$ y luego $c_R[k]$.
\If{\texttt{moving}$=0$}
\If{algún \texttt{PrevInput} es distinto de cero}
\State \Call{resetPID}{}
\EndIf
\State \Return
\EndIf
\State \Call{doPID}{controlador derecho,$1$}
\State \Call{doPID}{controlador izquierdo,$2$}
\State \Call{setMotorSpeeds}{\texttt{leftPID.output},\texttt{rightPID.output}}
\EndProcedure
\end{algorithmic}
\end{algorithm}

El Alg.~\ref{alg:pid_firmware} presenta la secuencia de llamadas de la rutina de actualización. Las operaciones internas del cálculo por rueda, es decir, la banda muerta asimétrica, la saturación de la salida acumulada y la actualización condicional del integrador, se detallan en el \ref{anx:pid_ecuaciones}.

El PI incremental no es una ley nueva, sino una realización clásica del PI, que
entrega el cambio de la señal de control en lugar de su valor y que, sin
saturación, equivale a la forma absoluta del mismo PI
\parencites[Sec.~13.4]{astrom2009controlpid}[Sec.~8]{wittenmark_ifac_computer}.
Por eso, su estabilidad es la de un PI clásico con iguales ganancias. El PI es adecuado
para procesos de dinámica esencialmente de primer orden
\citep[Sec.~3.6]{astrom2009controlpid}, como el modelo identificado
(Sec.~\ref{sec:identificacion_pso}). El producto del período de 33~ms por la
frecuencia de cruce, cercano a 0.07, queda dentro del intervalo recomendado de
0.05 a 0.14 para la aproximación al diseño continuo
\citep[Secs.~6 y 8]{wittenmark_ifac_computer}. Aun así, la verificación se
realiza sobre el lazo discreto, con las ganancias y el modelo de cada rueda.

Se analiza la idealización lineal de las
Ecs.~\eqref{eq:pid_fw_incremento} a~\eqref{eq:pid_fw_salida} con el modelo FOPDT
de cada rueda, sin saturación, banda muerta ni truncamientos enteros
(\ref{anx:estabilidad_pid}). Se consideran dos escenarios de retardo,
$L_{d,j}=0$ y $L_{d,j}=0.1$~s. El segundo es un escenario de sensibilidad,
porque el período de captura no establece una cota física del retardo. Los
modelos analizados son estables en ambos escenarios, con márgenes de fase de
53$^\circ$ a 57$^\circ$ y de 41$^\circ$ a 44$^\circ$, respectivamente, y
sensibilidad máxima de 1.35 a 1.85, dentro del intervalo típico de 1.2 a 2.0
\citep[Sec.~5]{wittenmark_ifac_computer}. El menor margen de retardo del modelo
sin retardo es de unos 0.42~s (Tabla~\ref{tab:estabilidad_pid}). Estos márgenes
caracterizan los modelos lineales y no constituyen una garantía global para
el programa no lineal ni una medición del retardo del robot.

\subsection{Bucle principal y autodetención}
\label{sec:bucle_principal}

El bucle principal atiende el \textit{parser} serial, programa la ejecución del controlador de velocidad y evalúa la autodetención. Si transcurre el intervalo de autodetención sin recibir comandos de movimiento, el \textit{firmware} detiene los motores, evitando que el robot continúe desplazándose ante pérdida de conexión o falla de algún nodo de navegación. Ambos intervalos programados se documentan en el \ref{anx:implementacion_diffdrive} y en el \ref{anx:protocolo_serial}.

\subsection{Sintonización del controlador asistida por PSO}
\label{sec:sintonizacion_pso}

Las ganancias del controlador se determinan mediante el procedimiento híbrido descrito en
la Sec.~\ref{sec:sintonizacion}, que encadena identificación FOPDT,
optimización por PSO y refinamiento experimental, formalizado en el
Alg.~\ref{alg:sintonizacion}. La configuración del enjambre, las escalas, las
cotas y las funciones de costo se conservan en el
\ref{anx:protocolos_sintonizacion}.

\begin{algorithm}[htbp]
\caption{Sintonización híbrida del controlador mediante identificación FOPDT y PSO.}
\label{alg:sintonizacion}
\begin{algorithmic}[1]
\Require Datos de lazo abierto por rueda; período $T_{\mathrm{cap}}$; configuración del PSO.
\Ensure Ganancias definitivas por rueda.
\State Cargar las señales de entrada, velocidad y tiempo.
\For{$j\in\{L,R\}$}
\State $v_j^{\mathrm{filt}}\gets\Call{FiltrarVelocidad}{v_j^{\mathrm{med}}}$
\State Definir $J_{\mathrm{ID}}$ como el MSE de identificación (\ref{anx:fodt_scripts}).
\State $(K_{m,j},\tau_j,L_{d,j})\gets\Call{PSO}{J_{\mathrm{ID}}}$
\State Definir $J_{\mathrm{PID}}$ como el costo MSE + sobreimpulso (\ref{anx:pso_detalle}).
\State $(K_{p,j},K_{d,j},K_{i,j})\gets\Call{PSO}{J_{\mathrm{PID}}}$
\EndFor
\State Refinar las ganancias sobre el robot real.
\State Registrar las ganancias definitivas en el {\itshape firmware\/}.
\State \Return $(K_{p,j},K_{d,j},K_{i,j})$, para $j\in\{L,R\}$.
\end{algorithmic}
\end{algorithm}

\subsubsection{Captura de respuesta en lazo abierto}
\label{sec:captura_lazo_abierto}

La identificación parte de una prueba en lazo abierto. Se aplica un escalón de
PWM y se registran los conteos de \textit{encoder} cada $T_{\mathrm{cap}}=0.1$~s durante
10~s, calculando la velocidad de cada rueda a partir del incremento de conteo.
El procedimiento reproducible, el valor del escalón y el tratamiento del período
de muestreo se conservan en el \ref{anx:protocolos_sintonizacion}.

\subsubsection{Identificación FOPDT y optimización por PSO}
\label{sec:identificacion_pso}

La identificación FOPDT ajusta los parámetros $(K_m,\tau,L_d)$ de la
Ec.~\eqref{eq:fodt} por PSO sobre la respuesta en lazo abierto y utiliza el
modelo obtenido para simular el controlador. Sobre ese modelo, una segunda
búsqueda por PSO obtiene las ganancias iniciales. El optimizador aplica la
formulación de la Sec.~\ref{sec:pso_marco}, con la actualización de velocidad
e inercia de las Ecs.~\eqref{eq:pso_vel_marco_teorico}
y~\eqref{eq:pso_inercia}. Las cotas, el escalado, la transformación de salida y
las aproximaciones numéricas de la planta y del controlador se documentan en el
\ref{anx:fodt_scripts} y en el \ref{anx:pso_detalle}.

Los retardos identificados, $L_{d,L}=0.0001$~s y $L_{d,R}=0.0692$~s
(Tabla~\ref{tab:pso_resultados}), son menores que el período de captura de
0.1~s y se cuantizan a cero muestras, por lo que el modelo ajustado equivale a
uno de primer orden sin retardo (Sec.~\ref{sec:fodt}). La estructura FOPDT se
conserva porque contiene ese caso y permite estudiar escenarios de retardo en
el análisis de estabilidad, como se detalla en el \ref{anx:fodt_scripts}.

\subsubsection{Refinamiento experimental}
\label{subsec:refinamiento_iterativo}

Las ganancias sugeridas por PSO se usan como punto de partida y luego se
ajustan sobre el robot real (Etapa~3 del
Alg.~\ref{alg:sintonizacion}), hasta obtener los valores definitivos de la
Tabla~\ref{tab:ganancias_pid}. La ejecución de partida sugiere un $K_i$ casi
nulo y valores de $K_p$ y $K_d$ cercanos a 11 y 35 en ambas ruedas. Al cargar esas ganancias y aplicar un escalón de
0.13~m/s aparecen dos comportamientos que el modelo FOPDT no anticipa
(Fig.~\ref{fig:respuesta_escalon_pso}).

El primero es un error estacionario persistente. Con $K_i$ casi nulo, la rueda
izquierda se estabiliza un escalón de cuantización por debajo de la
referencia, por lo que su $K_i$ se aumenta a 0.075, mientras que la derecha
converge por sí sola y mantiene un valor mínimo de 0.001. El segundo es un arranque lento asociado a la
zona muerta del \textit{driver}, descrita en la Sec.~\ref{sec:motores_marco}, que el
modelo de primer orden no representa. Para atravesar ese tramo se aumenta
$K_p$ a 16.00 y 16.42, lo que en la ley ejecutada acelera el crecimiento de la
salida mientras persiste el error. Ese aumento, sobre una velocidad cuantizada por los \textit{encoders},
vuelve excesiva la acción asociada a $K_d$, que en esta ley actúa en
proporción a la medición, por lo que $K_d$ se reduce desde valores cercanos a
35 hasta 20.30 y 20.05. La salida completa de la
ejecución de partida se conserva en la Tabla~\ref{tab:pso_resultados} del
\ref{anx:resultados_pso_ejecucion}, y el aporte efectivo del PSO a las
ganancias finales se analiza en la Sec.~\ref{sec:resultados_pid}.

\section{Arquitectura de control y navegación: SLAM, Nav2 y exploración}
\label{chap:app_control_nav}

Las capas de \textit{hardware}, \textit{firmware}, gemelo digital y control de bajo nivel se desarrollan en las secciones anteriores; esta sección enfatiza la orquestación de los subsistemas mediante \texttt{ros2\_control}, \texttt{slam\_toolbox}, Nav2 y \texttt{explore\_lite}. La correspondencia entre archivos de configuración, entorno y función se reúne en el \ref{anx:rutas_software}, y los parámetros completos se trasladan al \ref{anx:nav2_slam_config}.

\subsection{Mapeo con \texttt{slam\_toolbox}}
\label{sec:slam_ch9}

La técnica de SLAM por grafos de poses descrita en la Sec.~\ref{sec:slam} se
materializa en este trabajo mediante SLAM Toolbox
\citep{macenski2021slamtoolbox}, un sistema de SLAM 2D por grafos de poses
diseñado para \gls{ROS2}. Procesa los barridos de forma asíncrona, lo que
evita bloquear el sistema cuando la carga computacional crece, e incorpora
detección de cierre de lazo.
El robot construye el mapa del entorno mediante \texttt{slam\_toolbox}, en su modo asíncrono en línea. En la arquitectura distribuida ejecutada, este nodo no se ejecuta en la Raspberry Pi 4 sino en la estación de trabajo, que tiene un procesador de clase portátil (Tabla~\ref{tab:anx_versiones_sw}). La Raspberry Pi 4 publica \texttt{/scan}, \texttt{/odom} y las transformaciones asociadas al robot. El uso de CPU del nodo no se mide (\ref{anx:resultados_metodologia}).
Las configuraciones de \textit{hardware} y simulación comparten la estructura del
algoritmo, pero emplean parámetros específicos para cada entorno; los valores
cargados se consolidan en la Tabla~\ref{tab:slam_params_ch9}.

\subsection{Localización sobre un mapa conocido con AMCL}
\label{sec:amcl_ch9}

La localización de Monte Carlo adaptativa presentada en la
Sec.~\ref{sec:localizacion_marco} se implementa mediante AMCL
(\textit{Adaptive Monte Carlo Localization}), el nodo que Nav2 incorpora para
este propósito. AMCL estima la transformación entre los marcos \texttt{map} y
\texttt{odom}, mientras que la odometría mantiene la transformación entre
\texttt{odom} y el marco base del robot.
En este trabajo la localización se resuelve mediante \texttt{slam\_toolbox}
durante el mapeo en línea, que estima la transformación
\texttt{map}$\rightarrow$\texttt{odom} a medida que construye el mapa. Ese es
el modo empleado en la totalidad de los ensayos descritos en el
Capítulo~\ref{ch:resultados}. La localización sobre un mapa previamente
almacenado mediante AMCL corresponde a un modo distinto, que la pila de
navegación ofrece con sus parámetros por defecto y que queda fuera del alcance
declarado en la \hyperref[sec:alcances]{sección de alcances y limitaciones}.
Ese nodo no se ajusta para este robot ni se ejecuta durante los ensayos.

\subsection{Navegación autónoma con Nav2}
\label{sec:nav2_ch9}

Nav2 recibe una meta de navegación, calcula una ruta global y genera comandos
de velocidad para ejecutarla evitando obstáculos. La
Fig.~\ref{fig:interaccion_nav} sintetiza esta interacción y la sitúa dentro
del flujo completo del sistema: la percepción del RPLidar~A1 alimenta a
\texttt{slam\_toolbox} y a los mapas de costos; \texttt{bt\_navigator}
coordina la planificación global y el control local; y los comandos
resultantes se arbitran en \texttt{twist\_mux} antes de llegar al control
diferencial de bajo nivel descrito en la Sec.~\ref{sec:diff_drive_params}.

\utemFigurePropia{2.Texto/Imag/diagrama_navegacion_autonoma.png}{1.0\textwidth}
{Interacción entre los componentes de la navegación autónoma.}
{fig:interaccion_nav}

La realimentación de los \textit{encoders} cierra el control de velocidad de las ruedas
y actualiza la odometría utilizada por los módulos superiores.
El diagrama organiza los nodos según su rol dentro de la arquitectura
\gls{ROS2} y no según el equipo que los ejecuta. En la configuración
distribuida empleada, \texttt{slam\_toolbox}, Nav2 y \texttt{explore\_lite}
se ejecutan en la estación de trabajo, mientras que la interfaz
\texttt{ros2\_control} y la publicación de \texttt{/scan}, \texttt{/odom} y
las transformaciones asociadas residen en la Raspberry Pi~4
(Sec.~\ref{chap:robot_real}).

La configuración de los planificadores global y local se resume en la
Tabla~\ref{tab:nav2_componentes_ch9}. El controlador local evalúa las
trayectorias candidatas mediante la Ec.~\eqref{eq:costo_ctrl_local}.

\begin{table}[htbp]
\centering
\caption{Configuración de los planificadores global y local utilizados.}
\label{tab:nav2_componentes_ch9}
\small
\begin{tabular}{p{3.2cm} p{1.8cm} p{8.6cm}}
\toprule
\textbf{Componente} & \textbf{\textit{Plugin}} & \textbf{Configuración principal} \\
\midrule
Planificador global & NavFn & A$^*$ habilitado, espacio desconocido permitido y tolerancia de 0.5~m. \\
Controlador local & DWB & Críticos de obstáculos, oscilación, alineación y distancia respecto de la ruta y de la meta. \\
\bottomrule
\end{tabular}
\end{table}

La relación entre los límites del controlador local y del controlador
diferencial, junto con los identificadores completos de ambos
\textit{plugins}, se documenta en el \ref{anx:nav2_slam_config}.

\subsection{Mapas de costos}
\label{sec:costmaps_ch9}

Nav2 utiliza dos mapas de costos. El \texttt{global\_costmap} entrega la representación usada por el planificador global, mientras que el \texttt{local\_costmap} se actualiza alrededor del robot y permite al controlador DWB reaccionar ante obstáculos cercanos. Ambos mapas incorporan una capa de inflación, necesaria para mantener una distancia de seguridad respecto de los obstáculos.
En \textit{hardware} real ambos mapas de costos emplean un radio de inflación de 0.15~m, valor inferior al configurado en simulación; sus implicancias sobre la navegación en un recinto reducido se discuten en la Sec.~\ref{sec:resultados_nav2}. La geometría completa de los \textit{costmaps} se presenta en el \ref{anx:nav2_slam_config}.
La Fig.~\ref{fig:mapa_costos_ejecucion} ilustra el uso del mapa de costos
global durante una ejecución de navegación y exploración autónomas, desde la
detección de fronteras hasta la cobertura alcanzada del recinto.

\begin{utemMultiFigurePropia}{Evolución del mapa de costos global durante una ejecución de navegación y exploración autónomas.}{fig:mapa_costos_ejecucion}
\addutem{0.42}{2.Texto/Imag/fig_mapa_en_formacion_part1.PNG}{Fronteras detectadas en la fase inicial.}
\hfill
\addutem{0.42}{2.Texto/Imag/fig_mapa_en_formacion_part2.PNG}{Ruta planificada por Nav2 hacia una meta.}
\hfill
\addutem{0.42}{2.Texto/Imag/fig_mapa_en_formacion_part3.PNG}{Cobertura avanzada del recinto.}
\end{utemMultiFigurePropia}

\subsection{Árbol de comportamiento y recuperación}
\label{sec:bt_ch9}

La navegación de alto nivel se organiza mediante el árbol de comportamiento descrito en la Sec.~\ref{sec:nav_marco}.
El árbol ejecutado replanifica la ruta de forma periódica y aplica
recuperaciones en dos niveles: ante fallos de planificación o seguimiento
actúa sobre el \textit{costmap} correspondiente; si falla la navegación completa,
ejecuta una secuencia de recuperación configurada, detallada en la
Tabla~\ref{tab:recovery_ch9}.

\subsection{Exploración autónoma de fronteras}
\label{sec:explore_ch9}

Para mapear entornos desconocidos sin intervención manual continua, se integra el módulo de exploración por fronteras seleccionado en la Sec.~\ref{sec:seleccion_tecnologias} (\texttt{explore\_lite}), que identifica, sobre el \textit{costmap} global, las fronteras entre espacio libre conocido y zonas no observadas, y envía metas de navegación a Nav2. De esta forma, se cierra el ciclo percepción--mapeo--navegación--exploración sobre la misma arquitectura.
Los parámetros completos se conservan en la
Tabla~\ref{tab:explore_params_ch9} del \ref{anx:nav2_slam_config}, y el flujo
de detección, selección, envío de metas y gestión de la lista negra se resume
en el Alg.~\ref{alg:exploracion_fronteras}.

\begin{algorithm}[htbp]
\caption{Integración operativa de \texttt{explore\_lite} con Nav2.}
\label{alg:exploracion_fronteras}
\begin{algorithmic}[1]
\Require {\itshape Costmap\/} global $C$; lista negra $B$; tamaño mínimo de frontera; tiempo máximo sin progreso.
\Ensure Metas \texttt{NavigateToPose} seleccionadas desde fronteras alcanzables.
\State Ejecutar una planificación inicial.
\State Programar las planificaciones periódicas.
\While{la exploración esté activa}
\State $q\gets\Call{ObtenerPoseRobot}{}$
\State $\mathcal{F}\gets\Call{DetectarFronteras}{C,q}$
\For{cada frontera $F\in\mathcal{F}$}
\State Calcular $p_F^{\mathrm{impl}}$ y $U(F)$ según el \ref{anx:explore_impl}.
\EndFor
\State Eliminar las fronteras menores que \texttt{min\_frontier\_size}.
\State Ordenar $\mathcal{F}$ por costo ascendente.
\If{$\mathcal{F}=\varnothing$}
\State Cancelar la meta activa.
\State Detener la exploración.
\State \Return
\EndIf
\State $F^*\gets$ primera frontera de $\mathcal{F}$ cuyo punto no pertenezca a $B$.
\If{no existe $F^*$}
\State $B\gets\varnothing$
\Else
\State $p^*\gets p_{F^*}^{\mathrm{impl}}$
\If{la meta no presenta progreso durante \texttt{progress\_timeout}}
\State $B\gets B\cup\{p^*\}$
\State Repetir la selección con la lista negra actualizada.
\ElsIf{$p^*$ está a 0.01~m o más de la meta anterior}
\State Enviar $p^*$ a \texttt{NavigateToPose} sin cancelar la meta en curso.
\EndIf
\EndIf
\State Esperar el siguiente período de $1/f_{\mathrm{exp}}$.
\EndWhile
\Statex \textbf{Al recibir el resultado de una meta enviada al punto $p$:}
\If{$\texttt{estado}=\texttt{SUCCEEDED}$}
\State Ejecutar una nueva planificación de inmediato.
\ElsIf{$\texttt{estado}=\texttt{ABORTED}$}
\State $B\gets B\cup\{p\}$
\ElsIf{$\texttt{estado}=\texttt{CANCELED}$}
\State Conservar $B$ sin cambios.
\EndIf
\end{algorithmic}
\end{algorithm}

Dentro del Alg.~\ref{alg:exploracion_fronteras}, el puntaje de cada frontera combina distancia y tamaño, de modo que se
prefieren las cercanas y las que prometen descubrir más entorno. La meta se
envía con orientación identidad, porque solo importa la posición de la
frontera, y la lista negra $B$ evita reintentar metas improductivas. Como Nav2 informa como abortada también la meta que el explorador reemplaza (Sec.~\ref{sec:resultados_nav2}), esa lista recibe además puntos de metas que
no fallan. Si no queda ninguna frontera, el entorno alcanzable se considera mapeado. El cálculo del punto representativo, el escalamiento de la distancia y la programación del
temporizador se documentan en el \ref{anx:explore_impl}.

\subsection{Transferencia simulación--\texorpdfstring{\textit{hardware}}{hardware}}
\label{sec:integracion_ciclo}

La transferencia al \textit{hardware} conserva la arquitectura de navegación
descrita en la Sec.~\ref{sec:nav2_ch9}, manteniendo la estructura de tópicos
y marcos, pero seleccionando archivos de configuración específicos para el
entorno real. La correspondencia entre los archivos equivalentes de
simulación y \textit{hardware} se detalla en el \ref{anx:nav2_slam_config}. Además, se ajustan límites cinemáticos,
frecuencias, tolerancias e inflación de los mapas de costos según las
capacidades del prototipo físico.

\section*{Conclusión del capítulo}
\label{sec:conclusion_ch9}

La implementación integra componentes accesibles: plataforma diferencial, \textit{encoders}, \gls{Arduino} Nano, Raspberry Pi 4 y RPLidar A1, con una arquitectura de \textit{software} basada en \gls{ROS2}. El gemelo digital, construido sobre los mismos parámetros geométricos del prototipo, permite validar de forma previa la cinemática, los marcos de referencia y la configuración de control, facilitando la transferencia hacia el \textit{hardware} real. La comunicación mediante \texttt{ros2\_control}, \texttt{diff\_drive\_controller} y el \textit{plugin} \texttt{DiffDriveArduino} cierra el ciclo entre comandos de navegación, control PI incremental de ruedas (con ganancias iniciales obtenidas por PSO y refinadas en el robot, y con estabilidad verificada sobre el modelo FOPDT identificado) y publicación de odometría, con autodetención de seguridad ante pérdida de comandos. Sobre esta base, la orquestación de \texttt{slam\_toolbox}, Nav2 y \texttt{explore\_lite} articula percepción, mapeo, navegación y exploración autónoma sobre una misma estructura de tópicos y marcos, tanto en simulación como en \textit{hardware} real. Su desempeño se evalúa en el Capítulo~\ref{ch:resultados}.
