SVN11X/doc_tesis/1-PagPreliminar/resumen.tex

\chapter*{RESUMEN}
\thispagestyle{fancy}
\phantomsection
\addcontentsline{toc}{chapter}{RESUMEN}

Este trabajo presenta el diseño e implementación de un prototipo de robot móvil diferencial de bajo costo para mapeo 2D, navegación autónoma y exploración de interiores mediante \gls{ROS2} Foxy. El sistema integra una Raspberry Pi 4, un \gls{Arduino} Nano, \textit{encoders} de cuadratura, un sensor RPLidar A1 y un gemelo digital desarrollado en Gazebo Classic. El control de velocidad de cada rueda es un controlador PI incremental, forma del PID heredada del \textit{firmware} original, con ganancias iniciales obtenidas por optimización por enjambre de partículas (PSO) y refinadas en el robot. Su estabilidad se verifica con un modelo FOPDT de cada rueda. El mapeo se implementa con SLAM Toolbox, la navegación con Nav2 y la exploración mediante una estrategia basada en fronteras.

La odometría presenta un error medio de 3.63\% en trayectorias rectas sobre \textit{hardware} real. El control de velocidad, evaluado a 0.13~m/s, alcanza un error estacionario cercano a cero y no muestra sobreimpulso apreciable dentro de la resolución de medida. La exploración autónoma produce mapas válidos en cinco de las seis ejecuciones experimentales, con un índice medio de cobertura libre de 62.2\% y un área libre mapeada media de 3.50~m$^2$. Las cinco ejecuciones válidas terminan automáticamente cuando el explorador ya no encuentra fronteras, sin intervención manual. De las 60 metas de navegación generadas durante ellas, 54 quedan abortadas, una se completa y cinco no alcanzan a registrar su estado final porque la exploración se detiene mientras están en curso. El análisis del registro asocia temporalmente 53 de esos abortos al reemplazo de la meta en curso, que el explorador renueva cada 3.3~s y que Nav2 informa como abortada. Frente a un plano medido del recinto, los mapas tienen una distancia media de 3.4~cm. Los resultados verifican funcionalmente el mapeo y la exploración autónoma con un número muy bajo de repeticiones. La tasa de éxito de la navegación hacia metas fijas no se evalúa y queda como trabajo futuro.

\noindent\textbf{Palabras clave:} robot móvil diferencial, SLAM, \gls{ROS2}, Nav2, navegación autónoma, exploración de fronteras, PSO, gemelo digital.

\chapter*{ABSTRACT}
\thispagestyle{fancy}
\phantomsection
\addcontentsline{toc}{chapter}{ABSTRACT}

This thesis presents the design and implementation of a low-cost differential mobile robot prototype for 2D mapping, autonomous navigation, and indoor exploration using \gls{ROS2} Foxy. The system integrates a Raspberry Pi 4, an \gls{Arduino} Nano, quadrature encoders, an RPLidar A1 sensor, and a digital twin developed in Gazebo Classic. Each wheel's speed is regulated by an incremental PI controller, the form of PID inherited from the original firmware, with initial gains obtained through Particle Swarm Optimization (PSO) and refined on the robot. Its stability is verified on an FOPDT model of each wheel. Mapping is implemented with SLAM Toolbox, navigation with Nav2, and exploration through a frontier-based strategy.

Odometry shows a mean error of 3.63\% in straight-line trajectories on real hardware. Speed control, evaluated at 0.13~m/s, reaches a near-zero steady-state error and shows no appreciable overshoot within the measurement resolution. Autonomous exploration produces valid maps in five of the six experimental runs, with a mean free-space coverage index of 62.2\% and a mean mapped free area of 3.50~m$^2$. The five valid runs end automatically when the explorer finds no remaining frontiers, without manual intervention. Of the 60 navigation goals generated during these runs, 54 are aborted, one is completed, and five have no recorded final state because exploration stops while they are in progress. Log analysis temporally associates 53 of these aborts with the replacement of the active goal by a new one, since the explorer renews its target every 3.3~s and Nav2 reports the replaced goal as aborted. Compared with a measured floor plan of the test area, the maps show a mean distance of 3.4~cm. The results functionally verify mapping and autonomous exploration with a very small number of repetitions. The success rate of navigation toward fixed goals is not evaluated and is left as future work.

\noindent\textbf{Keywords:} differential mobile robot, SLAM, \gls{ROS2}, Nav2, autonomous navigation, frontier exploration, PSO, digital twin.
