SVN11X/doc_tesis/3.Pag_final/3.glosario.tex

\newglossaryentry{ROS2}
{
name=ROS~2,
description={\textit{Robot Operating System 2} es un conjunto de bibliotecas y herramientas de código abierto para desarrollar \textit{software} de robótica de forma modular y distribuida}
}

\newglossaryentry{Arduino}
{
name=Arduino,
description={Arduino es una plataforma de \textit{hardware} y \textit{software} de código abierto para crear proyectos electrónicos interactivos, pensada para ser fácil de usar y muy extendida en robótica}
}

\newglossaryentry{LIDAR}
{
name=LIDAR,
description={\textit{Light Detection and Ranging}. Sensor que utiliza pulsos de luz láser para medir distancias y generar representaciones 2D/3D del entorno con alta precisión}
}

\newglossaryentry{PWM}
{
name=PWM,
description={\textit{Pulse Width Modulation}. Técnica de control que regula la potencia promedio entregada a una carga variando el ciclo útil de un pulso periódico}
}

\newglossaryentry{IMU}
{
name=IMU,
description={\textit{Inertial Measurement Unit}. Unidad inercial que integra acelerómetros, giroscopios (y a veces magnetómetros) para estimar orientación y movimiento}
}
