SVN11X/doc_tesis/2.Texto/Imag/diagrama_navegacion_autonoma.pptx

Joystick / Gamepad
Teleoperación manual

OPERADOR

RViz2
Supervisión y
visualización

TF, /map, estado

ROBOT FÍSICO - Percepción

RPLidar A1
LIDAR 2D

COMPUTACIÓN ROS 2 (ESTACIÓN/PC)

Interacción del operador

Componentes ROS 2

LEYENDA

Módulo lógico

Tópico / TF

Componentes físicos

/scan

/cmd_vel_joy

slam_toolbox
SLAM 2D basado en grafo de poses

TF( map→odom ) y /map

Costmaps
Global y local
(Inflación, obstáculos)

/global_costmap

Actualiza costmaps

controller_server
Control local (DWB)

local_costmap

/goal_pose

/map

local_costmap

planner_server
Planificación global (NavFn / A*)

bt_navigator
Árbol de comportamiento
(Behavior Tree)

Metas de exploración

Plan global

Meta

explore_server
Exploración autónoma

FollowPath

recoveries_server
Comportamientos de recuperación

/odom

TF (odom→base_link)

Recuperaciones

twist_mux
Arbitraje de comandos
(prioridades)

/cmd_vel

ros2_control
Control de la plataforma
(diff_drive_controller)

ROBOT FÍSICO - Actuación

serial USB

/diff_cont/cmd_vel_unstamped

Motores DC

Arduino Nano
PI incremental por rueda
(velocidad)

L298N (Driver)
PWM + DIR

Conteos de encoder

Encoders
Retroalimentación de velocidad
