SVN11X/doc_tesis/2.Texto/Imag/arquitectura_alto_nivel.pptx

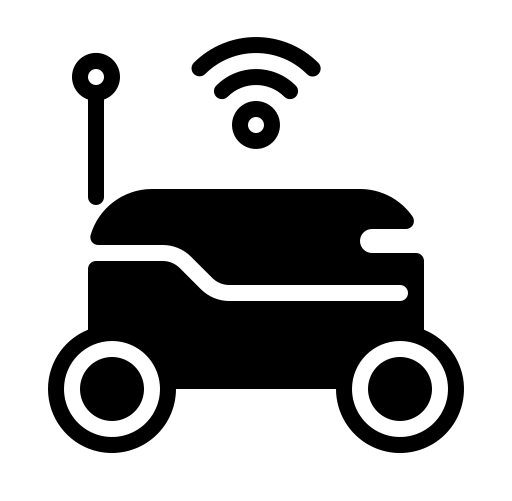
[picture p2: figure]

ROBOT MÓVIL

SENSADO

ESTACIÓN DE TRABAJO

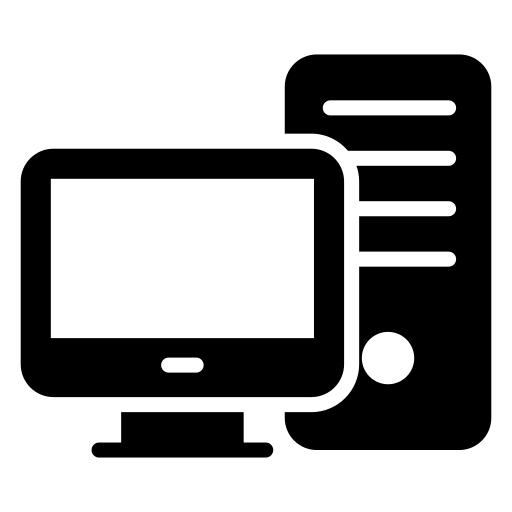
[picture p3: figure]

Encoders
Medición del giro
de las ruedas

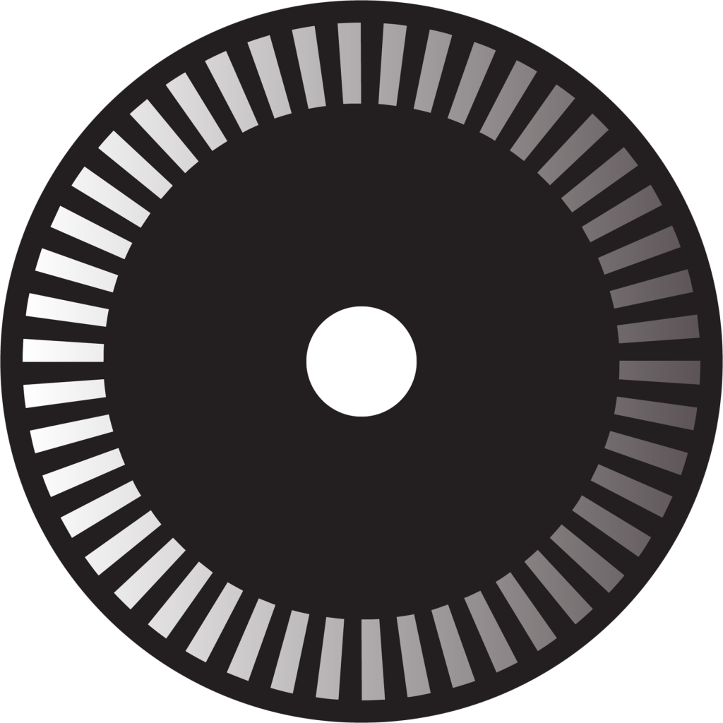
[picture p4: figure]
What is an Encoder?

LiDAR 2D
Percepción del entorno

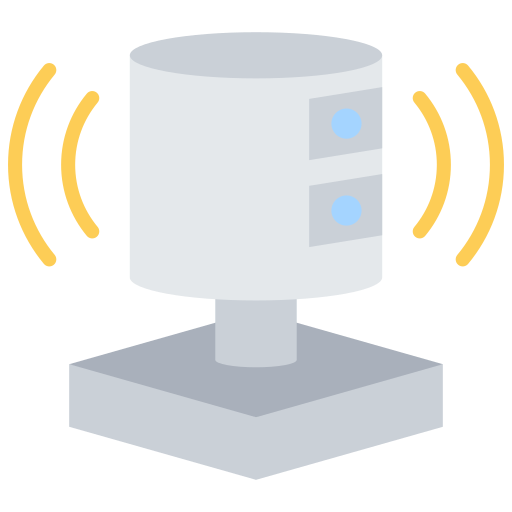
[picture p5: figure]

SLAM Toolbox
Mapeo y
estimación de pose

RViz2
Visualización y supervisión

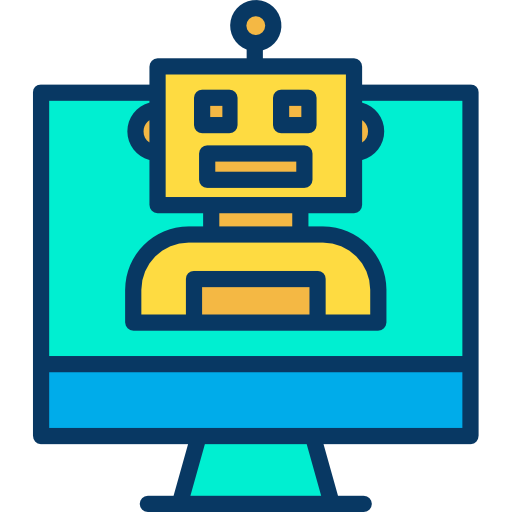
[picture p6: figure]
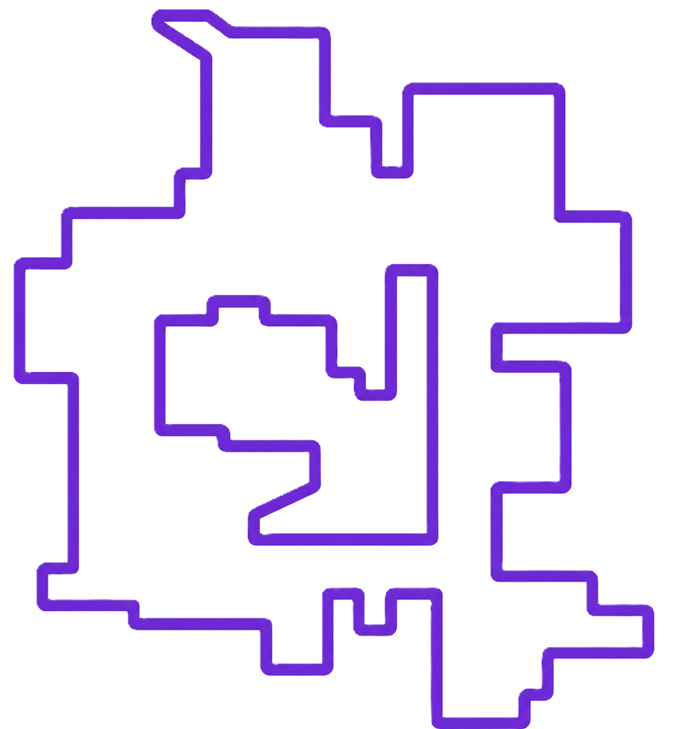
[picture p7: figure]

Arduino
Control PI incremental y lectura de encoders

Motores DC
Tracción diferencial

CONTROL DE BAJO NIVEL

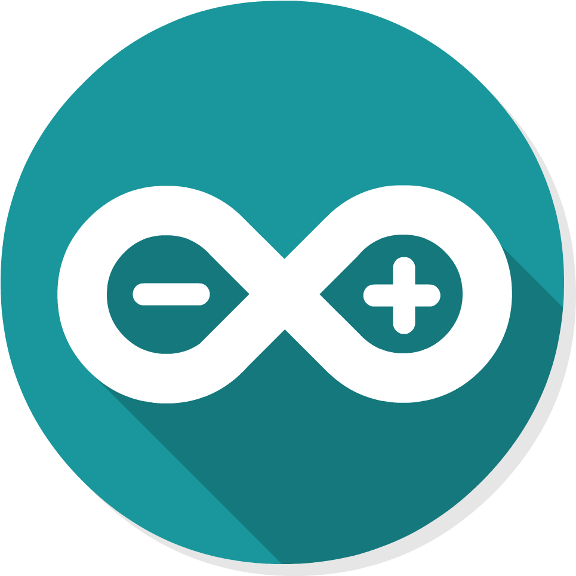
[picture p8: figure]

Raspberry Pi 4
Integración ROS 2 y estimación de odometría

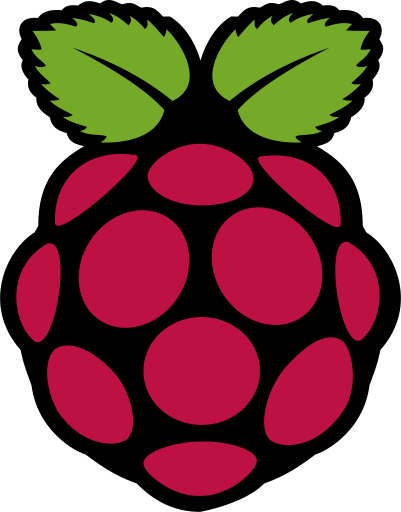
[picture p9: figure]

Nav2
Planificación y control
de navegación

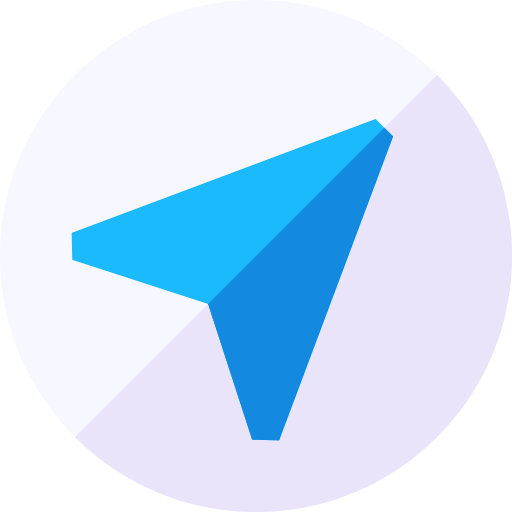
[picture p10: figure]

Exploración por fronteras
Generación autónoma
de metas

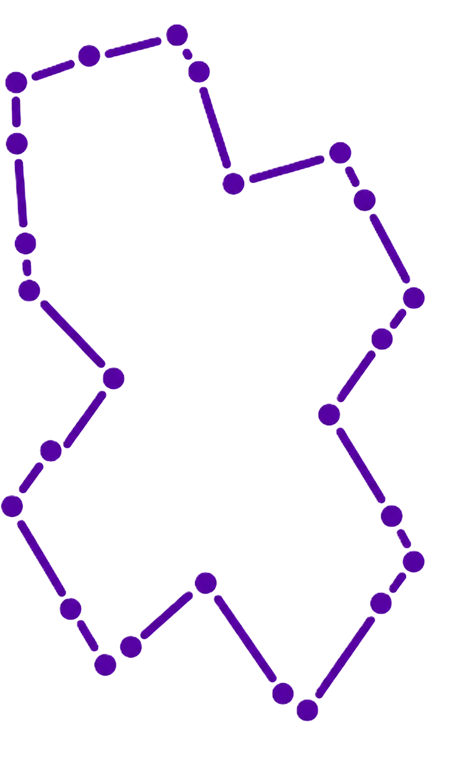
[picture p11: figure]

Intercambio de datos y comandos

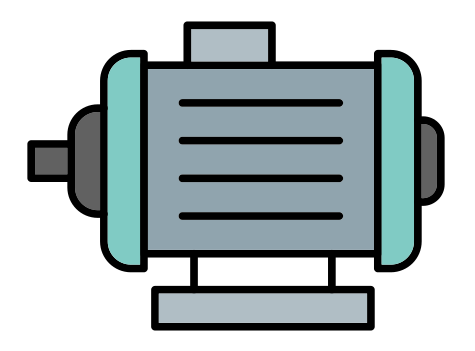
[picture p12: figure]
Motor - Iconos gratis de electrónica

Sensado

Control de bajo nivel

Sistema computacional del robot

Mapeo y navegación
