SVN11X/doc_tesis/2.Texto/Imag/fig_cotas_gemelo_digital.pptx

LIDAR pos. X
12 cm (0.120 m)

2.0 cm (0.02 m)

chassis_height
10.5 cm (0.105 m)

Altura total
17.4 cm (0.174 m)

wheel_diameter
6.7 cm (0.067 m)

wheel_offset_x
5.0 cm (0.05 m)

wheel_radius
3.35 cm (0.0335 m)

caster_wheel_offset_x
21.0 cm (0.21 m)

caster_radius
1.5 cm (0.015 m)

3.0 cm (0.03 m)

wheel_separation
18.8 cm (0.188 m)

Proyección de la rueda loca (caster)

chassis_width
23.0 cm (0.23 m)

Proyección de las ruedas

chassis_length
24.5 cm (0.245 m)
