SVN11X/doc_tesis/_sin_uso/2.Texto/Imag/fig_conversion_unidades.pptx

- ESCRITURA (write): ros2_control -> Arduino

write(): cmd / rads_per_count / loop_rate

diff_drive_controller
cmd = vel. angular de rueda (joint)

÷ rads_per_count
÷ 0.003173

ticks/s

÷ loop_rate
÷ 30

ticks/frame

Arduino PID
TargetTicksPerFrame

ticks/frame

rad/s

Constante compartida conceptualmente
Rads_per_count = 2π / 1980 = 0.003173 rad/ticks

- LECTURA (read): Arduino -> ros2_control

read(): pos = enc × rads_per_count
vel = Δpos / Δt (backward diff.)

Arduino encoders
readEncoder()

ticks

× rads_per_count
calcEncAngle()

rad (pos)

diff_drive_controller
State_interfaces

rad, rad/s

Δpos / Δt
Diferencia temporal

rad/s (vel)
