SVN11X/doc_tesis/_sin_uso/2.Texto/Imag/fig_secuencia_start.pptx

FASE PREVIA
Arduino al encender

DiffDriveArduino

ArduinoComms

Arduino Nano

A

setup()
Serial.begin(57600)

B

initMotorController()
Enable pins -> HIGH

C

resetPID()
carga ganancias PSO

Ganancias PSO (hardcoded)
Izq:
Kp1, Kd1, Ki1, Ko=50
Der:
Kp2, Kd2, Ki2, Ko=50

METODO start()
DiffDriveArduino

1

Log de inicio
RCLCPP_INFO(“Starting …”)

configure(): apertura del puerto + espera 3 s para reset del CH340

RCLCPP_INFO(“Starting …”)

2

sendEmptyMsg()
Verificar conexión serial

sendEmptyMsg()

Verificar conexión serial

3

Heartbeat serial
Envia retorno de robot

“\r”

Heartbeat (CR)

4

Arduino confirma
Enlace serial activo

Respuesta serial

Confirma enlace activo

5

Log PID info
“using firmware defaults”

6

Status = STARTED
Plugin operativo

RCLCPP_INFO(“PID values …”)

✓ status_ = STARTED
