SVN11X/doc_tesis/_sin_uso/2.Texto/Imag/fig_flowchart_validacion.pptx

1

2

Reloj y tiempo simulado
/clock ≥ 400 Hz, use_sim_time: true

Geometría y transformaciones
0 marcos desconectados, 5/5 TFs activas (1 dinámica odom→base_link + 4 estáticas)

¿OK?

Si

No

Revisar gazebo_params.yaml y argumento use_sim_time

3

Controladores
update_rate: 30 Hz, publish_rate (/odom): 50 Hz

¿OK?

Si

No

Revisar URDF/xacro: links, joints, origins

4

Teleoperación
Robot responde a /cmd_vel_joy → twist_mux → /diff_cont/cmd_vel_unstamped

¿OK?

Si

No

Verificar my_controllers.yaml y spawners

5

Respuesta cinemática (contacto/fricción)
Giro 360°: error < 0.05 rad; Avance 1 m: desv. < 0.02 m

¿OK?

Si

No

No

Revisar twist_mux.yaml y remapping de tópicos

6

Sensor láser
/scan a ~10 Hz, frame laser_frame, 360 muestras

¿OK?

¿OK?

Si

No

Ajustar fricción (μ₁, μ₂) y colisión (esfera vs cilindro)

Revisar lidar.xacro: update_rate, frame_name

7

Paridad final
wheel_sep, wheel_radius idénticos robot_core.xacro, gazebo_control.xacro, my_controllers.yaml, ROSArduinoBridge.ino

¿OK?

Si

Si

No

Corregir valor discrepante en archivo fuente

Leyenda:

Condicional

Paso de verificación

Acción correctiva

Listo para SLAM / Nav2
