SVN11X/doc_tesis/_sin_uso/2.Texto/Imag/gazebo_plugin.pptx

libgazebo_ros_diff_drive.so
Plugin diferencial de Gazebo

Motor de física Gazebo
left_wheel_joint, right _wheel_joint

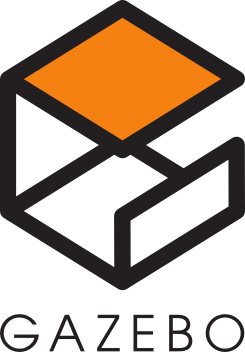
[picture p13: figure]

/odom
nav_msgs/Odometry

/cmd_vel
geometry_msgs/Twist

Difusion TF en /tf

odom

base_link

Estado simulado de joints

Comandos de Velocidades de rueda
