SVN11X/doc_tesis/_sin_uso/2.Texto/Imag/arbol_archivos_firmware.pptx

ROSArduinoBridge

- ROSArduinoBridge.ino

Programa principal

- commands.h

Define 15 comandos serial de acción

- diff_controller.h

Estructura del PID y funciones de control

- encoder_driver.h

Definición de pines para los encoders

- encoder_driver.ino

Decodificación de cuadratura mediante ISR y tabla de estados

- motor_driver.h

Definición de pines para L298N

- motor_driver.ino

Extensiones:
- .ino: Programa Arduino
- .h: Cabecera C/C++

Control de dirección y PWM

- Principal

- Comandos

- Control PID

Roles:

- Encoders

- Motores
