SVN11X/doc_tesis/_sin_uso/2.Texto/Imag/diagrama_arquitectura_firmware.pptx

Raspberry PI 4

diff_drive_controller

diffdrive_arduino

Flujo de datos en ejecución
Dependencia de compilación
Señales eléctricas

Arduino Nano – ATmega328P

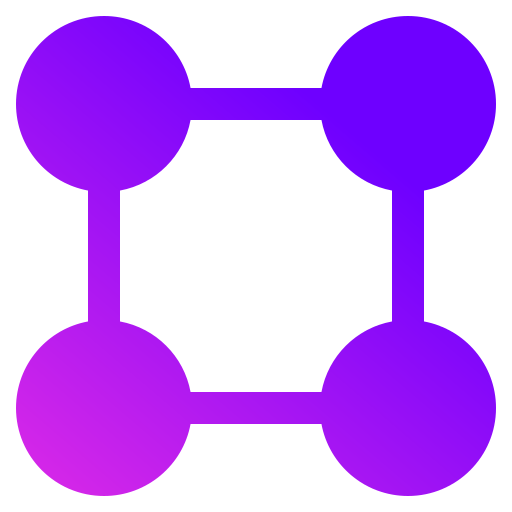
[picture p14: figure]
Icono de Nodo Generic gradient fill | Freepik

commands

ROSArduinoBridge

Envio de movimiento - updatePID()
Detención del movimiento - resetPID()

diff_controller

Definición de comandos disponibles

Envio de comando velocidades.
cmd (rad/s por rueda)

Envio de datos de odometria (odom).
pos (rad) + vel (rad/s)

- PID_RATE = 30 Hz
- ENC_TICKS_PER_REV = 1980
- WHEEL_DIAMETER = 0.067 m
- AUTO_STOP = 2000 ms

Lectura de encoder
readEncoder()

Contadores de encoder
"e\r" → "<encL> <encR>"

Comunicación Serial USB (57600 baud)

Envio de comandos
"m <ticks_L> <ticks_R>\r"

Establecer velocidades
setMotorSpeeds() para test

Establecer velocidades
setMotorSpeeds()

encoder_driver

Captura de interrupciones de pulsos de encoder

Encoders
cuadratura

motor_driver

Envio de PWM + dirección

Motor DC + L298N

What is an Encoder?
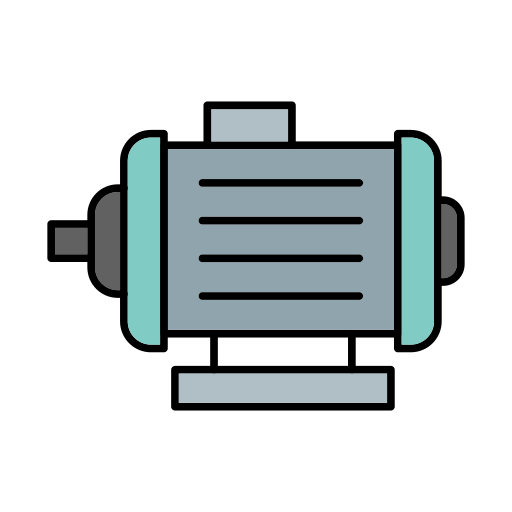
[picture p15: figure]
Motor - Iconos gratis de electrónica
