SVN11X/doc_tesis/_sin_uso/2.Texto/Imag/diagrama_flujo_sincronizacion.pptx

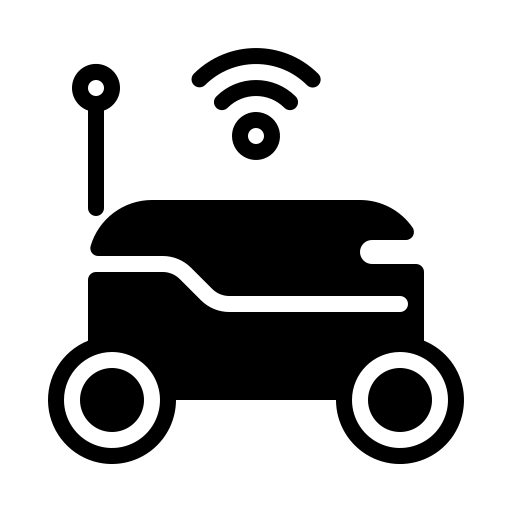
[picture p16: figure]
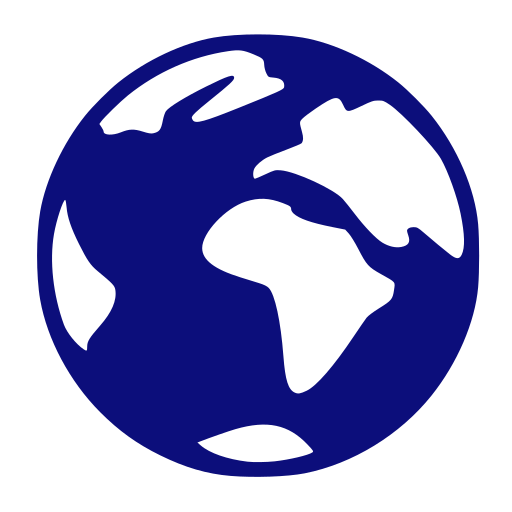
[picture p17: figure]
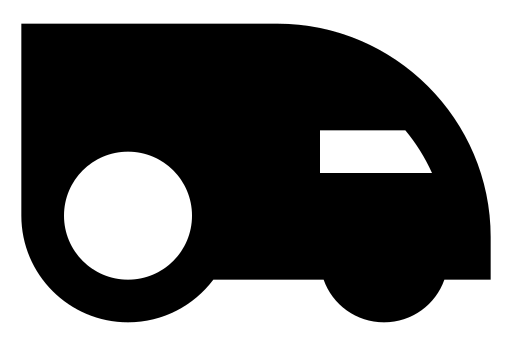
[picture p18: figure]
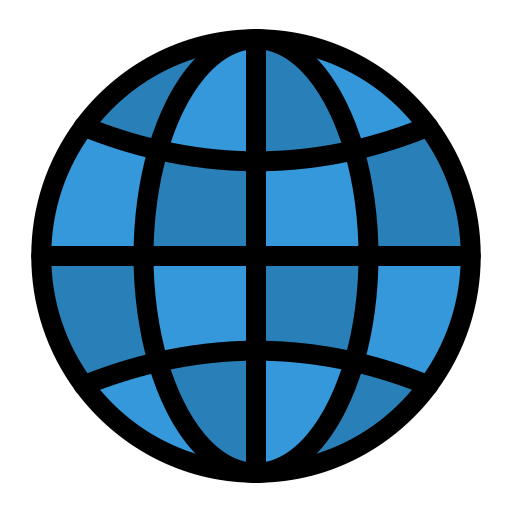
[picture p19: figure]

Prototipo físico
(Hardware real)

Medidas verificadas
Separación de ruedas – diámetro rueda - altura laser

Modelo digital
(URDF / xacro)

Parámetros iniciales
Fricción – Amortiguamiento - Inercias

Se propaga automáticamente a:

ros2_control
(Control diferencial)

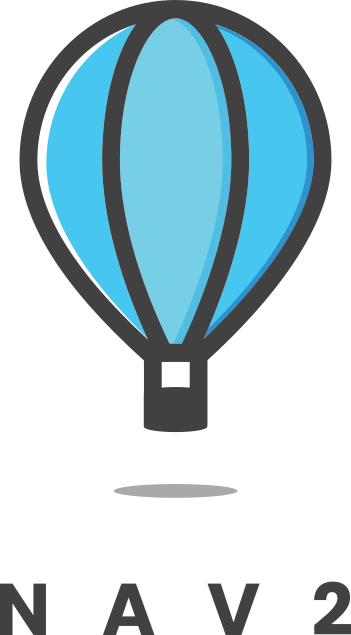
[picture p20: figure]
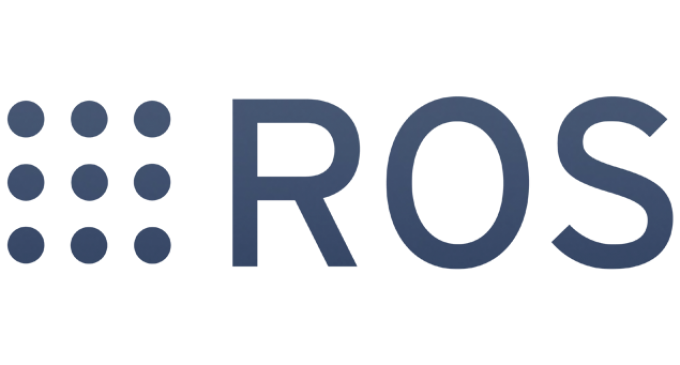
[picture p21: figure]

Gazebo
(Simulación)

Nav2 / SLAM
(Navegación)
