SVN11X/doc_tesis/_sin_uso/2.Texto/Imag/fig_secuencia_arranque.pptx

Hardware real
launch_robot.launch.py

joystick

Simulación (Gazebo)
launch_sim.launch.py

t0

rsp

twist_mux

t0

rsp

twist_mux

gazebo

TimerAction (3.0 s)

t1

spawn_entity.py

OnProcessExit (spawn_entity)

t1

ros2_control_node

t2

joint_broad

diff_cont

t2

joint_broad

diff_cont

t3

/joint_states

/odom

/tf

t3

/joint_states

/odom

/tf

Leyenda:

Condicional

Siempre incluido

Hardware real

Simulación

Campos de espera
