SVN11X/doc_tesis/_sin_uso/2.Texto/Imag/fig_secuencia_control.pptx

Arduino Nano

DiffDriveArduino

diff_drive_controller

Tópicos ROS 2

1

Arduino: PID + lee encorders

PID loop (33.3 ms)

~ 33.3 ms

2

Plugin: read()

sendMsg (‘e\r’)

Solicita contadores encoder

~ 5-10 ms

3

Arduino responde

“1234 5678\n”

Contadores L y R

4

Plugin: calcula pos. y vel.

calcEncAngle()
Δpos / Δt → vel

state_interfaces (pos, vel)

Hardware_interface -> controller

<1 ms

5

Controller: lee estados

6

Publica /odom y /tf

/odom + /tf

publish_rate: 50 Hz

~ 20 ms

7

Recibe nuevo cmd_vel

/diff_cont/cmd_vel_unstamped

Desde twist_mux

8

Controller: calcula vel. ruedas

Command_interfaces (vel)

rad/s por rueda

9

Plugin: write()

sendMsg (‘m L R\r’)

ticks/frame por ruedas

SetMotorSpeed()
analogWrite()

~ 5 - 10 ms

10

Arduino: aplica PWM a motores
