SVN11X/doc_tesis/_sin_uso/2.Texto/Imag/fig_xacro_decision_tree.pptx

robot.urdf.xacro

¿use_ros2_control = true?

¿sim_mode = true?

robot_core.xacro

gazebo_control.xacro

No

Si

Si

No


ros2_control.xacro

¿sim_mode = true?

GazeboSystem

lidar_sim.xacro

lidar.xacro

No

DiffDriveArduino

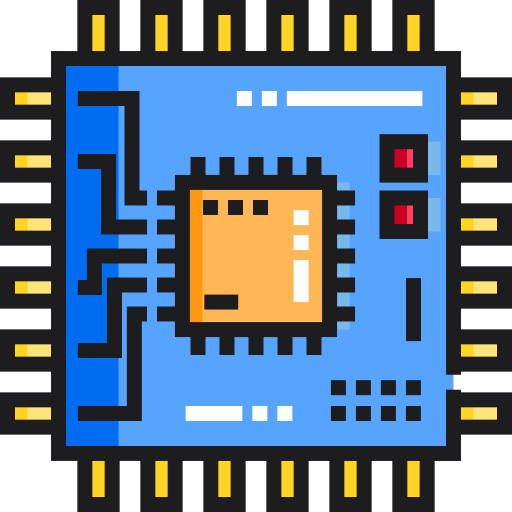
[picture p22: figure]

Si

Condicional

Siempre incluido

Hardware real

Leyenda:


Simulación

Plugin alternativo

Nota: En todos los casos, el resto del sistema (SLAM, Nav2, teleoperacion) recibe /cmd_vel, /odom y /scan, y opera de forma idéntica independiente del backend seleccionado
