SVN11X/doc_tesis/_sin_uso/2.Texto/Imag/flow_xacro.pptx

robot.urdf

xacro

lidar

lidar_sim

gazebo_control

robot_core

ros2_control

inertial_macros
