SVN11X/doc_tesis/_sin_uso/2.Texto/Imag/carta_gantt.pdf

## Periodo Actividades: 01/03/2026 - 31/08/2026 Duracion Total: 6 MESES

## Etapa de actividades a desarrollar

Actividades | Marzo | | Mayo Abril | Junio | | Agosto Julio
1° | 2° | 3° | 4° | 1° | 2° | 3° | 4° | 1° | 2° | 3° | 4° | 1° | 2° | 3° | 4° | 1° | 2° | 3° | 4° | 1° | 2° | 3° | 4°

Etapa 1: Diseño gemelo digital y simulación

Modelado URDF/xacro del robot diferencial

Configuración de Gazebo y plugins de simulación

Validación de cinemática y odometría en simulación

Etapa 2: Construcción del hardware

Ensamblaje mecánico y cableado (RPi4, Arduino, L298N)

Integración de RPLidar A1 y encoders

Configuración de ros2_control y comunicación serial

Etapa 3: Control de bajo nivel

Firmware PID en Arduino Nano

Sintonización automática de PID mediante PSO

Validación de control: pruebas en línea recta y giro

Etapa 4: SLAM y navegación autónoma

Configuración de SLAM (slam_toolbox) y mapeo

Configuración de Nav2 (planificador global y local)

Pruebas de navegación con evasión de obstáculos

Etapa 5: Exploración y validación final

Exploración autónoma de fronteras

Validación del sistema completo en entorno real

Etapa 6: Documentación

Redacción del documento de tesis

Revisión final y entrega del manuscrito
