SVN11X/doc_tesis/_sin_uso/2.Texto/Imag/tipo_sintonia.pdf

# Pv (V) 5

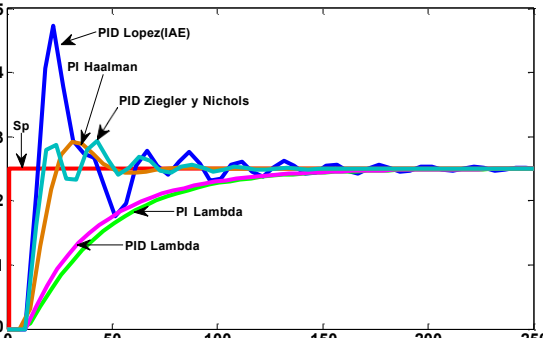
[picture p23: figure]
PID Lopez(IAE); PI Haalman; PID Ziegler y Nichols; PI Lambda; PID Lambda

4

3

2

1

0
0 | 50 | 100 | 150 | 200 | 250

## Tiempo (s)
