SVN11X/doc_tesis/_sin_uso/2.Texto/Imag/fig_bt_tree.pptx

4

PipelineSequence
Navegacion principal

EXITO

RecoveryNode
6 intentos

SUCCESS

GoalUpdated

FAILURE

SequenceStar
7 acciones

FALLO

RateController
2 Hz

FollowPath
DWB controller

ReactiveFallback
Recuperación

ComputePath
GridBased (A*)

ClearCostmap
Local 0.3 m

ClearCostmap
Global 0.5 m

BackUp
0.2 m, 0.03 m/s

Spin
1.57 rad (90°)

ComputePath
Recovery

FollowPath
Recovery

Wait
2 s

1

2

3

5

6

7

Leyenda:

Secuencia Navegación

Fallback (recuperación)

Accion (Nav2 plugin)

Condición

Acción de recuperación

Raiz (RecoveryNode)
