SVN11X/doc_tesis/_sin_uso/2.Texto/Imag/fig_flujo_control_diferencial.pptx

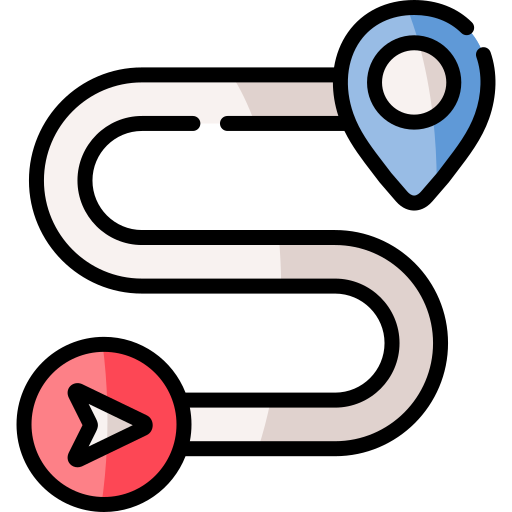
[picture p24: figure]

Navegación autónoma

/cmd_vel

Prioridad 10

Twist_mux

/cmd_vel_out

Prioridad 100

/cmd_vel_joy

Teleoperación

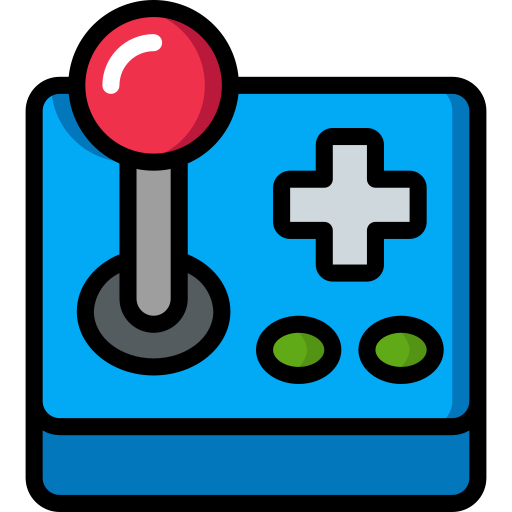
[picture p25: figure]

GazeboSystem


DiffDriveArduino

Leyenda:

Condicional

Siempre incluido

Hardware real

Simulación

diff_drive_controller

/tf

diff_drive_controller

Rueda izquierda virtual


Rueda derecha virtual

Rueda izquierda


Rueda derecha

/odom

Nav2

slam_toolbox

¿sim_mode = true?

rplidar_ros


/scan

libgazebo_ros_ray_sensor

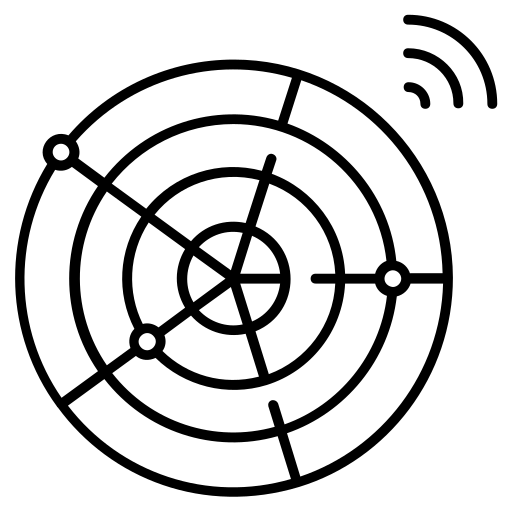
[picture p26: figure]
