SVN11X/doc_tesis/_sin_uso/2.Texto/Imag/flow_urdf_files.pptx

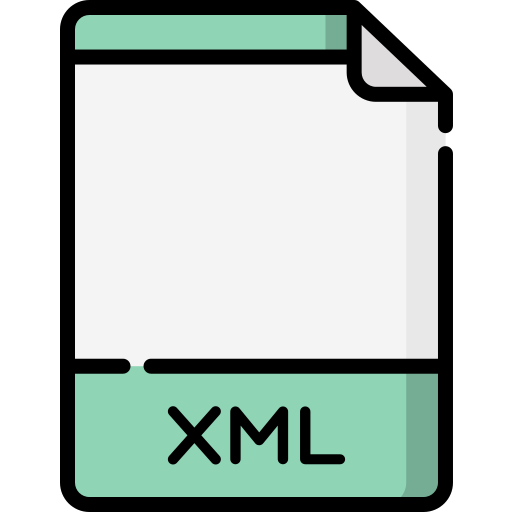
[picture p27: figure]

xacro

/tf

robot_state_publisher

/robot_description

/join_states

join_state_publisher_gui
