SVN11X/doc_tesis/_sin_uso/2.Texto/Imag/template_folder.pptx

Robot Package Template
by joshnewans

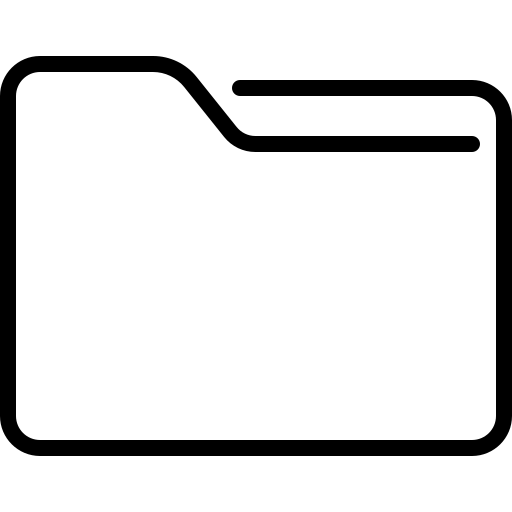
[picture p28: figure]
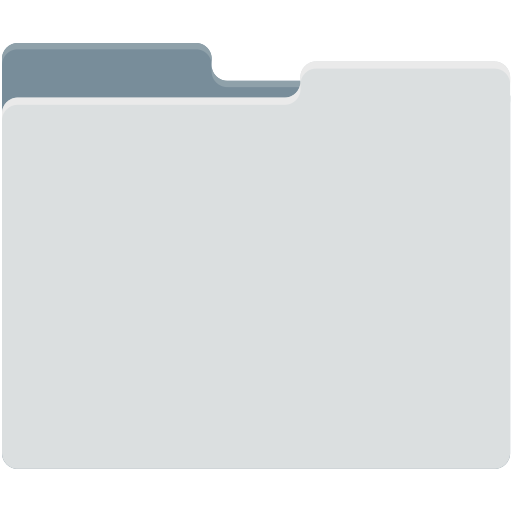
[picture p30: figure]

Estación de trabajo

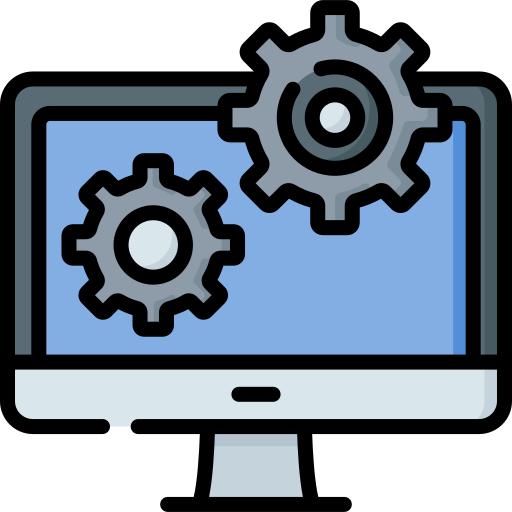
[picture p31: figure]

Repositorio clonado

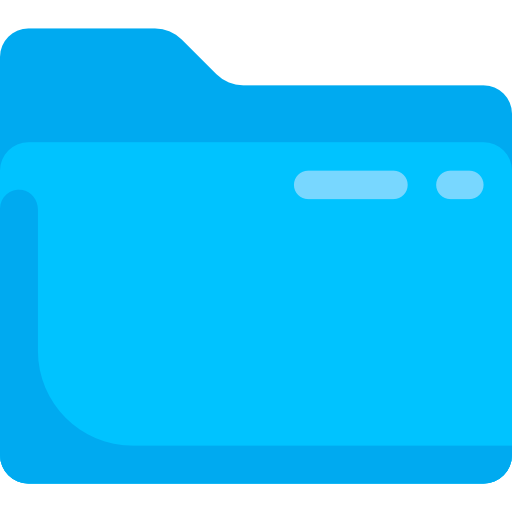
[picture p32: figure]

Robot móvil
