SVN11X/doc_tesis/2.Texto/Imag/plano_recinto.pdf

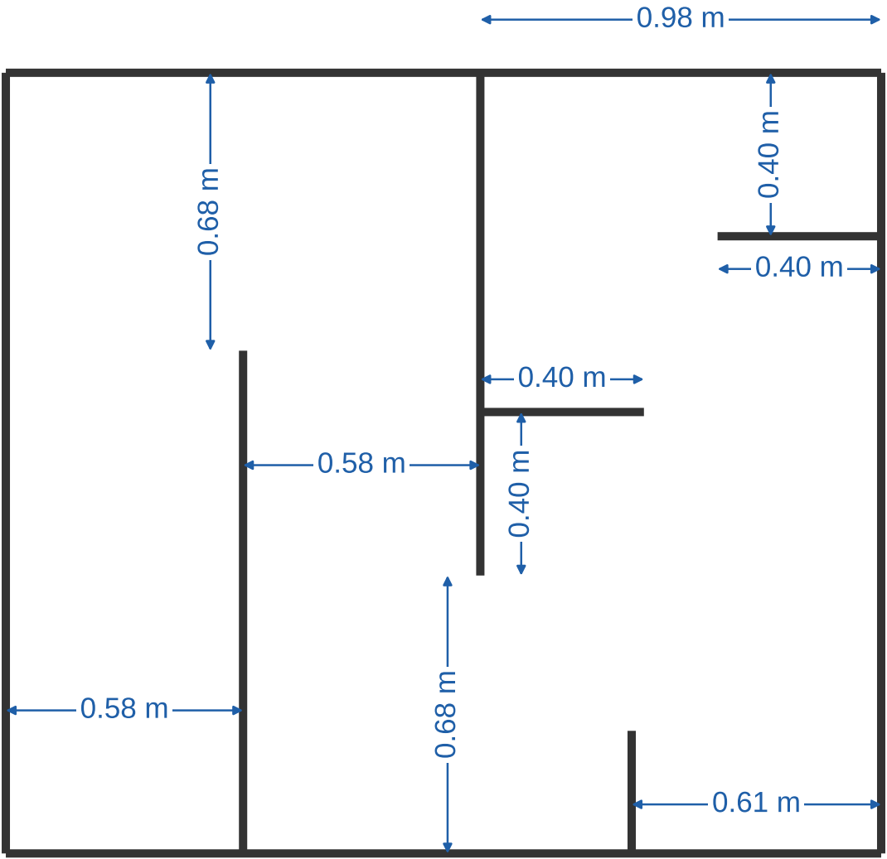
[picture p63: figure]

1.91 m
