SVN11X/doc_tesis/_sin_uso/2.Texto/Imag/tf_tree.pdf

view_frames Result

Recorded at time: 1774548811.2179341

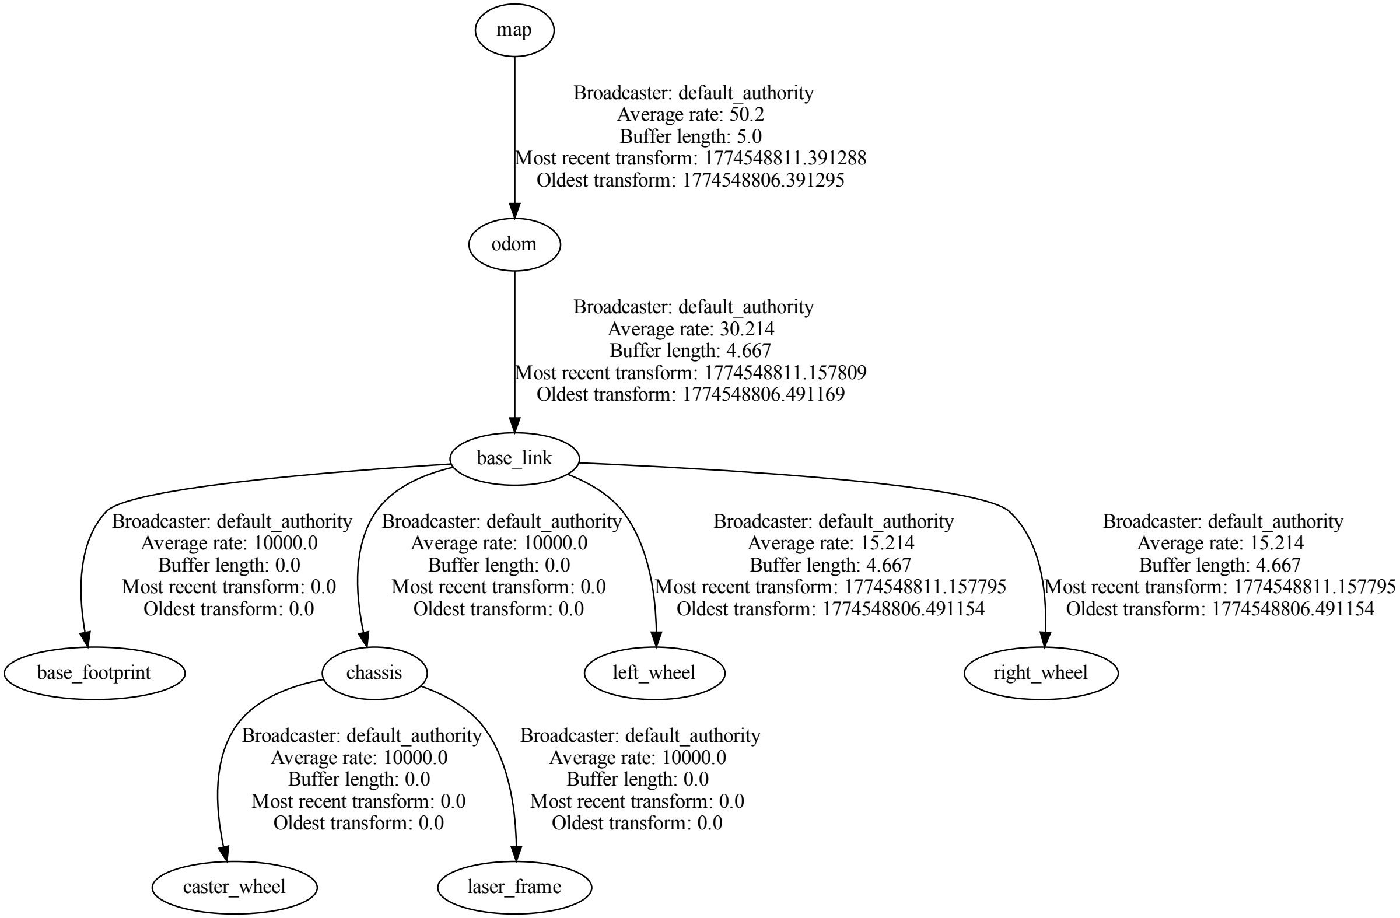
[picture p64: figure]
map; odom; Broadcaster: default_authority Average rate: 50.2 Buffer length: 5.0 Most recent transform: 1774548811.391288 Oldest transform: 1774548806.391295; base_link; Broadcaster: default_authority Average rate: 30.214 Buffer length: 4.667 Most recent transform: 1774548811.157809 Oldest transform: 1774548806.491169; base_footprint; Broadcaster: default_authority Average rate: 10000.0 Buffer length: 0.0 Most recent transform: 0.0 Oldest transform: 0.0; chassis; left_wheel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
