SVN11X/doc_tesis/_sin_uso/2.Texto/Imag/tf_tree_real.pdf

view_frames Result

Recorded at time: 1774550128.2767072

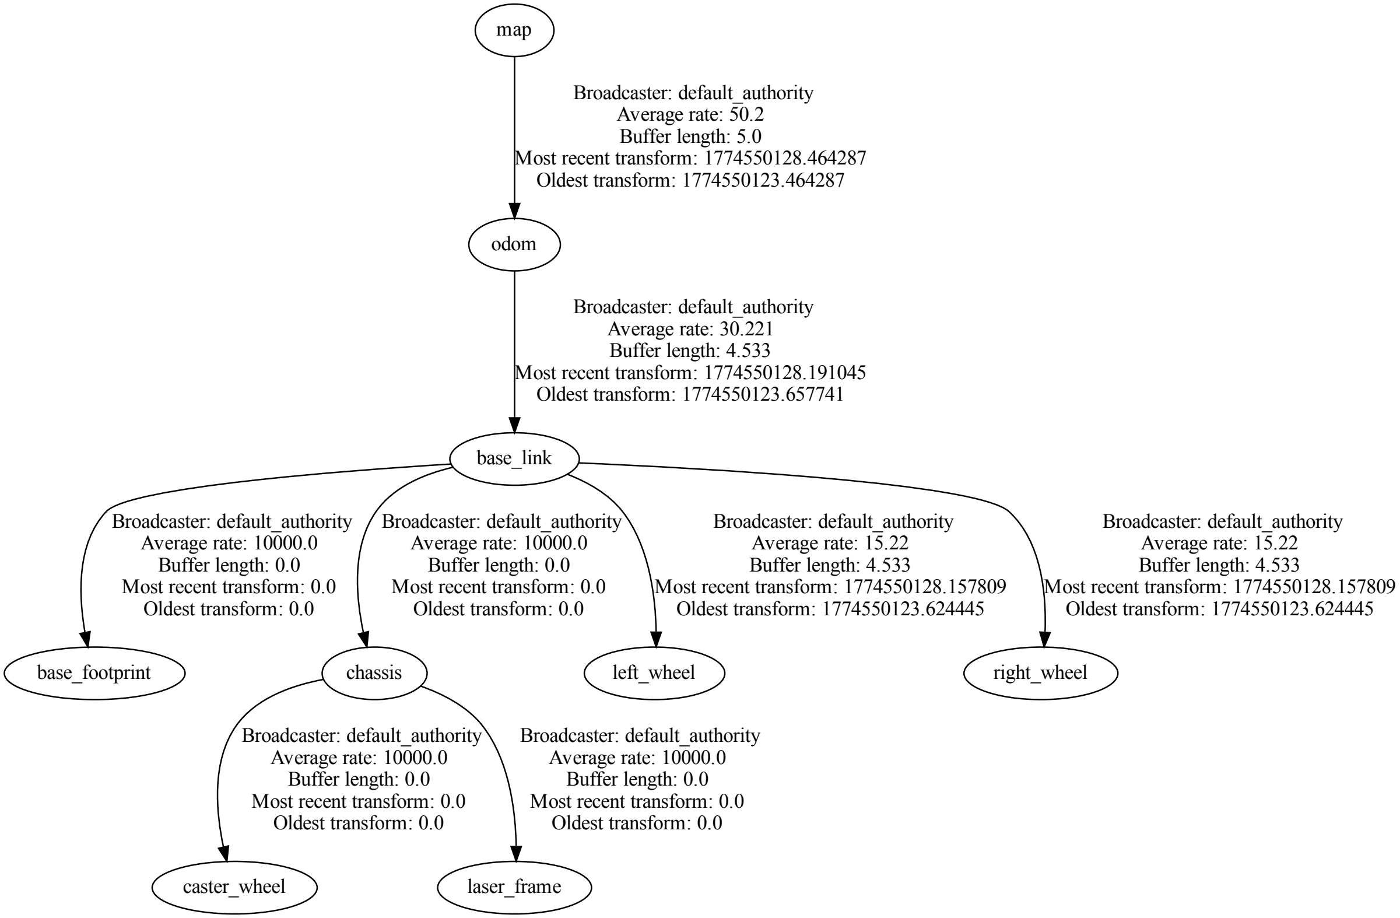
[picture p65: figure]
map; odom; Broadcaster: default_authority Average rate: 50.2 Buffer length: 5.0 Most recent transform: 1774550128.464287 Oldest transform: 1774550123.464287; base_link; Broadcaster: default_authority Average rate: 30.221 Buffer length: 4.533 Most recent transform: 1774550128.191045 Oldest transform: 1774550123.657741; base_footprint; Broadcaster: default_authority Average rate: 10000.0 Buffer length: 0.0 Most recent transform: 0.0 Oldest transform: 0.0; chassis; left_wheel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
