SVN11X/doc_tesis/2.Texto/Imag/circuit_diagram.png

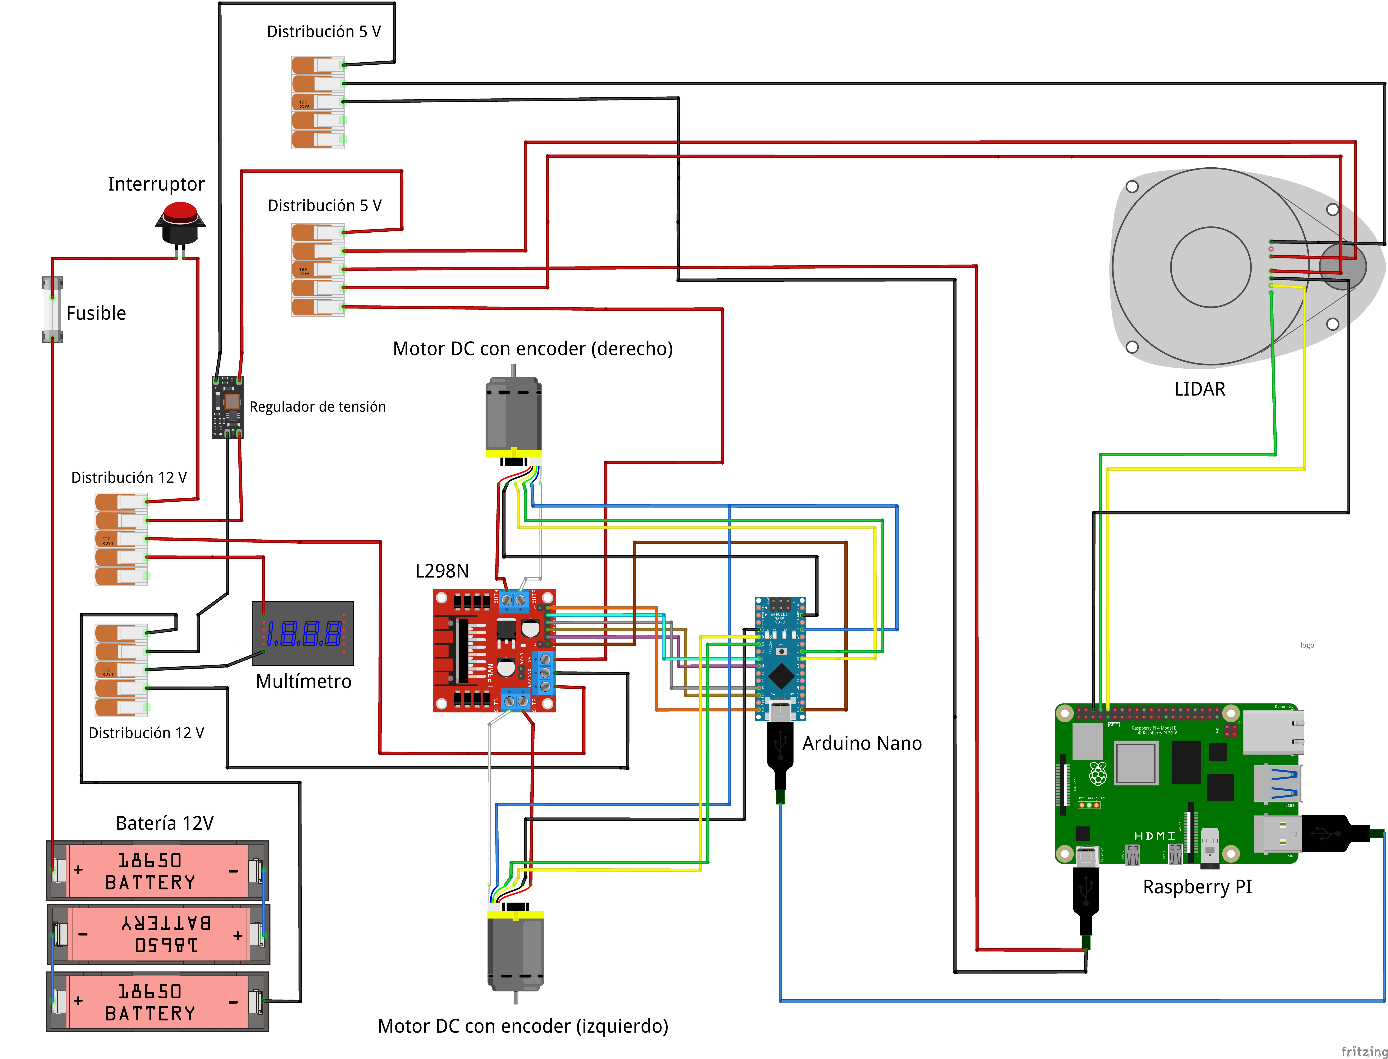
2.Texto/Imag/circuit_diagram.png
