SVN11X/doc_tesis/2.Texto/Imag/diagrama_navegacion_autonoma.png

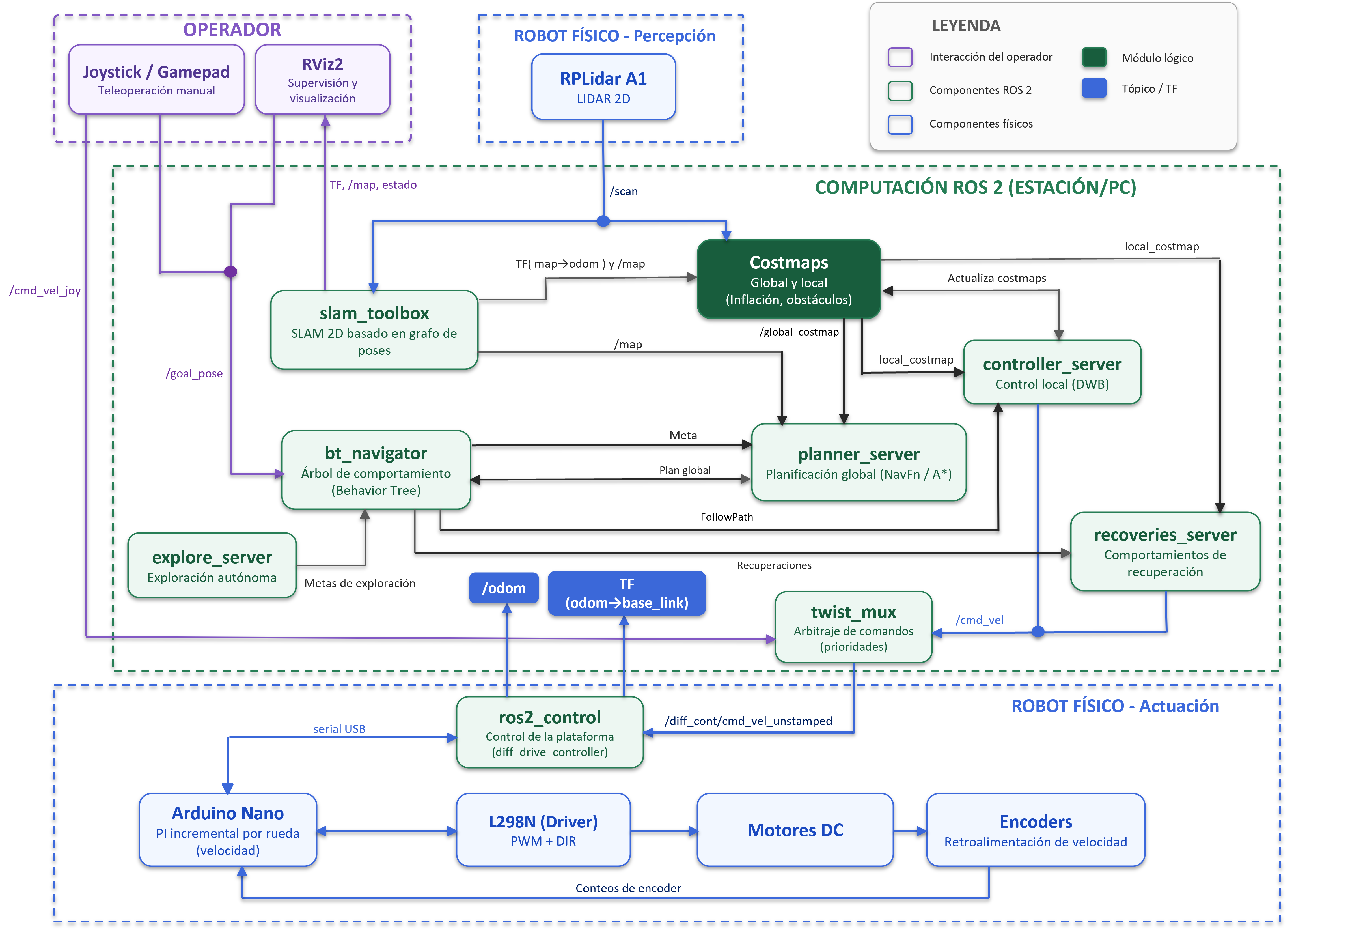
2.Texto/Imag/diagrama_navegacion_autonoma.png
