SVN11X/doc_tesis/2.Texto/Imag/fig_grafo_poses.png

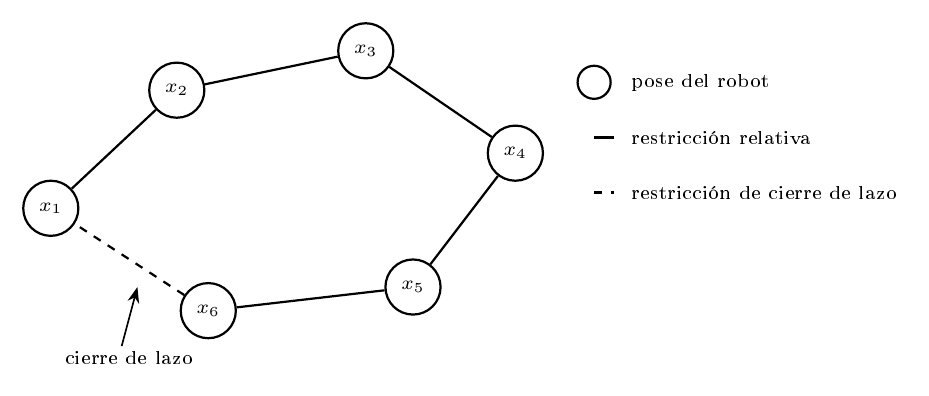
2.Texto/Imag/fig_grafo_poses.png
