SVN11X/doc_tesis/2.Texto/Imag/fig_lazo_pid.png

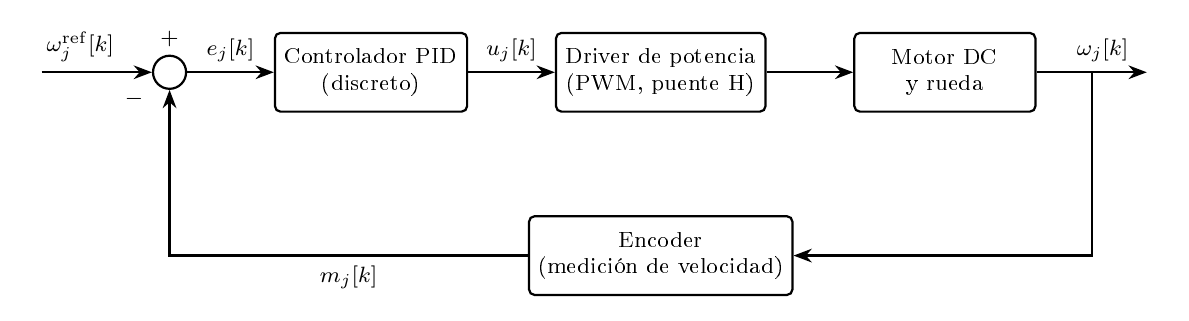
2.Texto/Imag/fig_lazo_pid.png
