SVN11X/doc_tesis/2.Texto/Imag/odom_error_barras.png

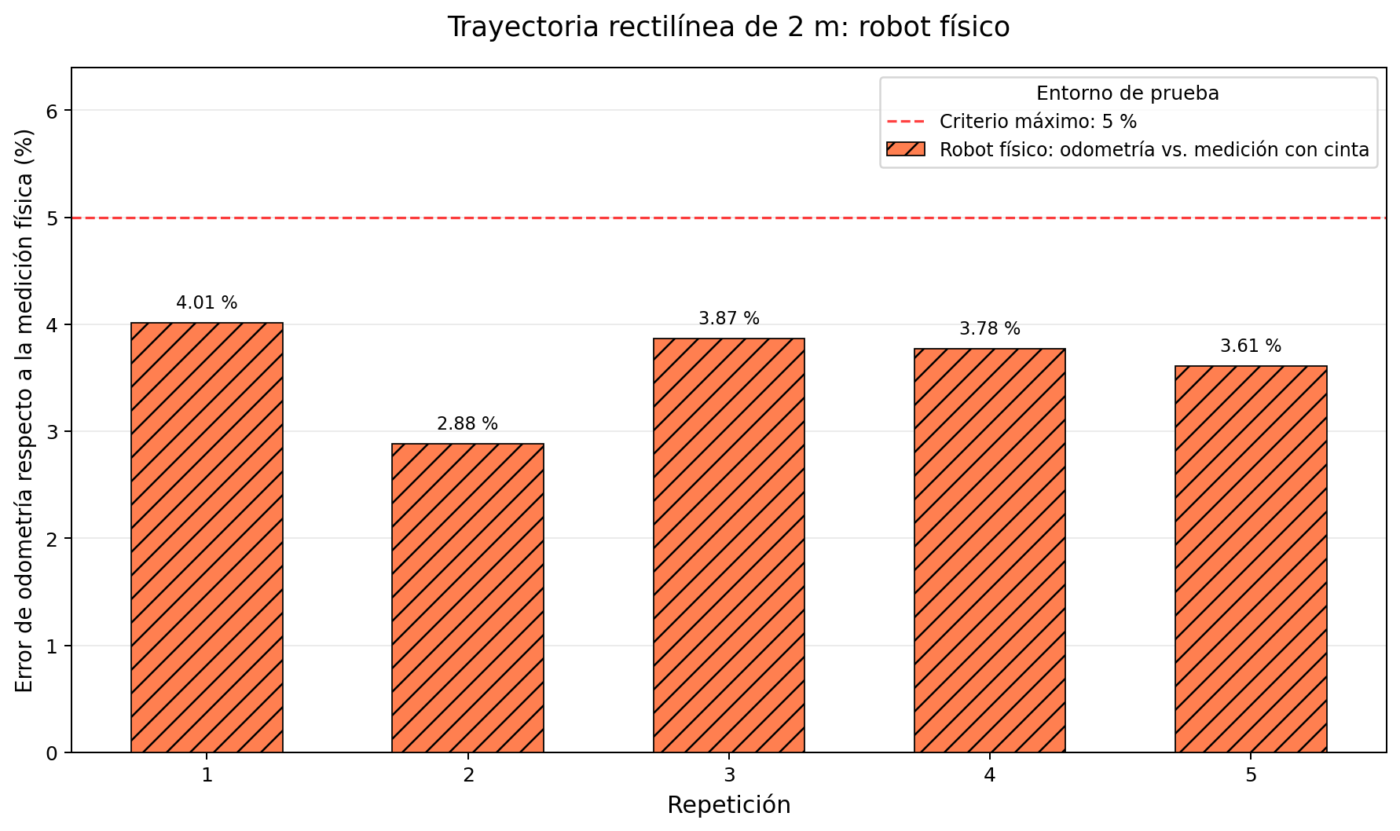
2.Texto/Imag/odom_error_barras.png
