SVN11X/doc_tesis/_sin_uso/2.Texto/Imag/0!1_control_sinOrientacion.png

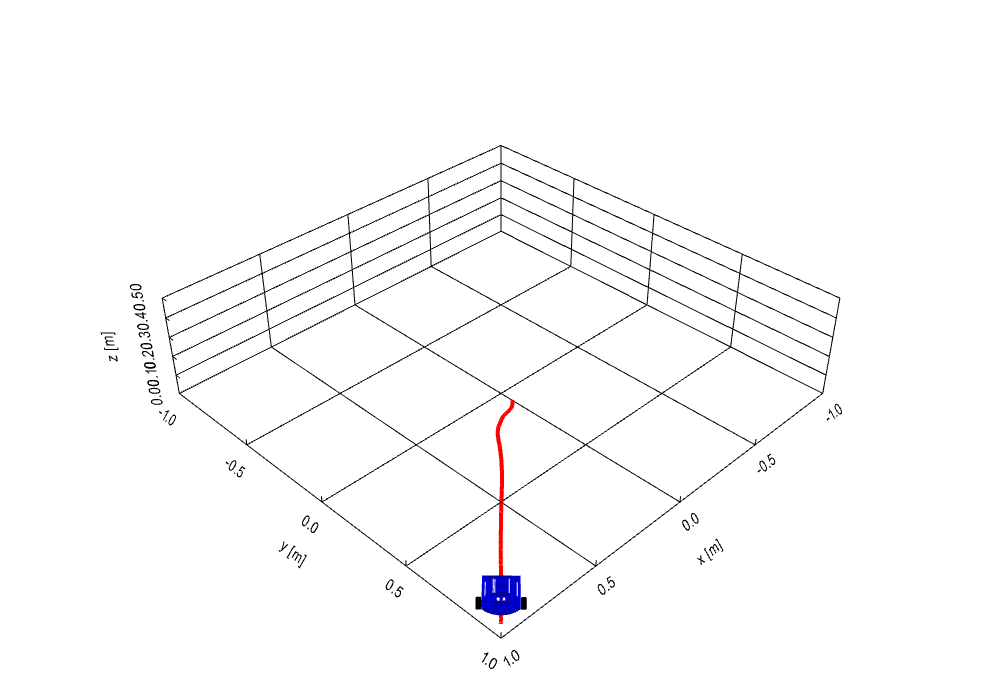
_sin_uso/2.Texto/Imag/0!1_control_sinOrientacion.png
