SVN11X/doc_tesis/_sin_uso/2.Texto/Imag/0!1_control_sinOrientacion_vel.png

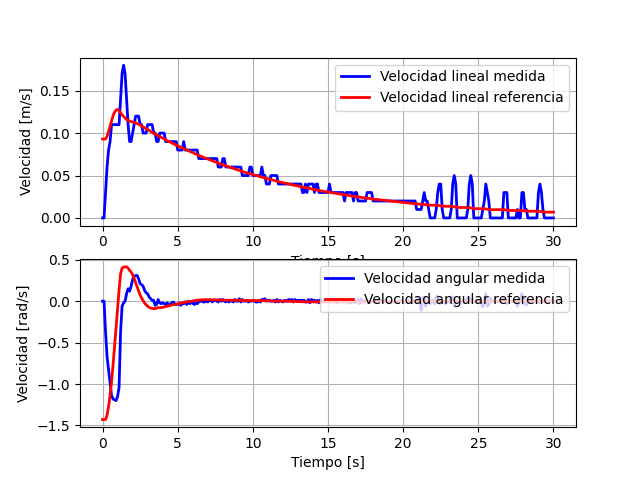
_sin_uso/2.Texto/Imag/0!1_control_sinOrientacion_vel.png
