SVN11X/doc_tesis/_sin_uso/2.Texto/Imag/0!14_control_sinOrientacion_error.png

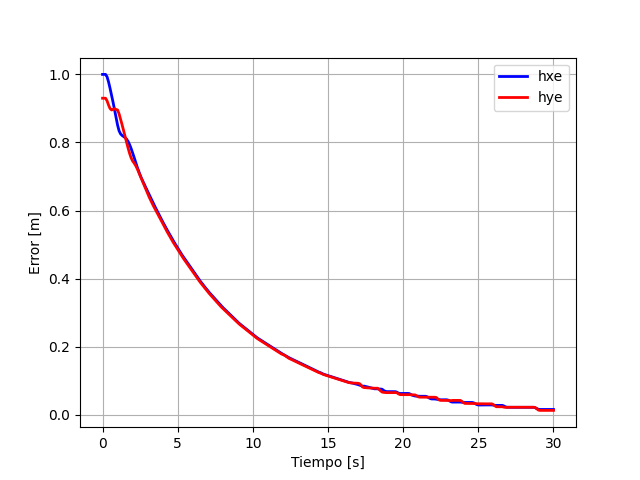
_sin_uso/2.Texto/Imag/0!14_control_sinOrientacion_error.png
