SVN11X/doc_tesis/_sin_uso/2.Texto/Imag/a1m8.jpg

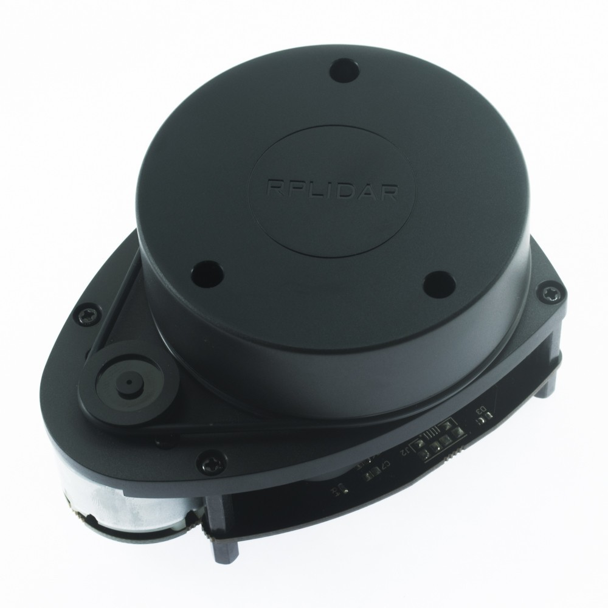
_sin_uso/2.Texto/Imag/a1m8.jpg
