SVN11X/doc_tesis/_sin_uso/2.Texto/Imag/AB90.jpg

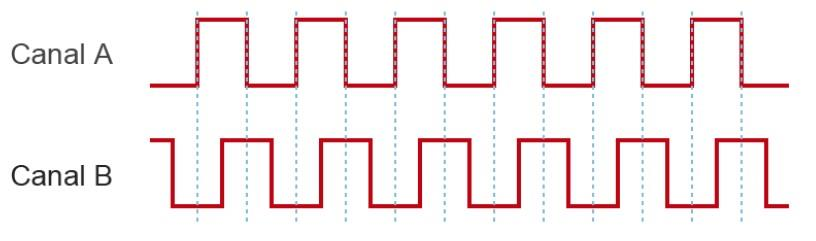
_sin_uso/2.Texto/Imag/AB90.jpg
