SVN11X/doc_tesis/_sin_uso/2.Texto/Imag/ackermann_simple_design.png

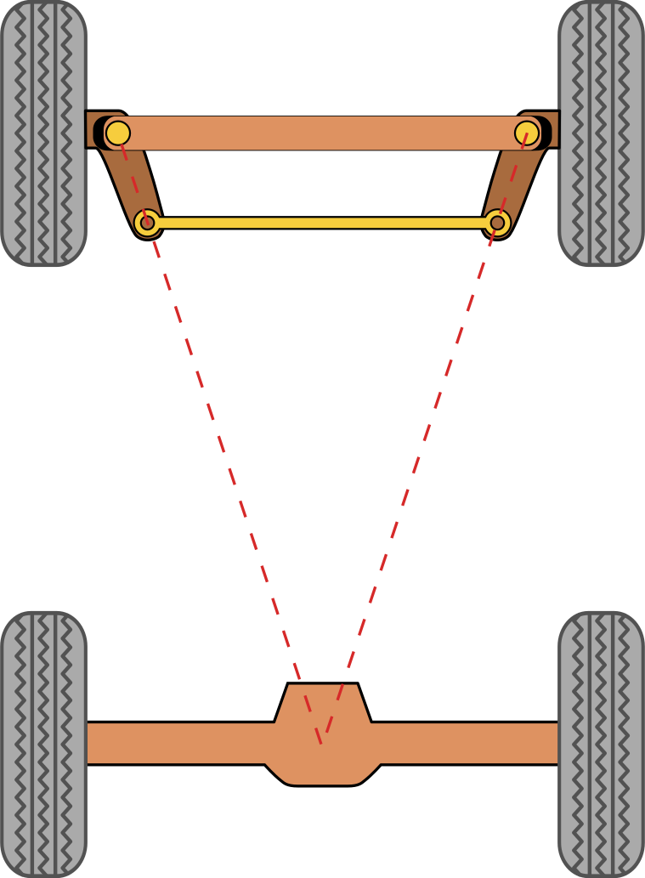
_sin_uso/2.Texto/Imag/ackermann_simple_design.png
