SVN11X/doc_tesis/_sin_uso/2.Texto/Imag/arbol_archivos_firmware.png

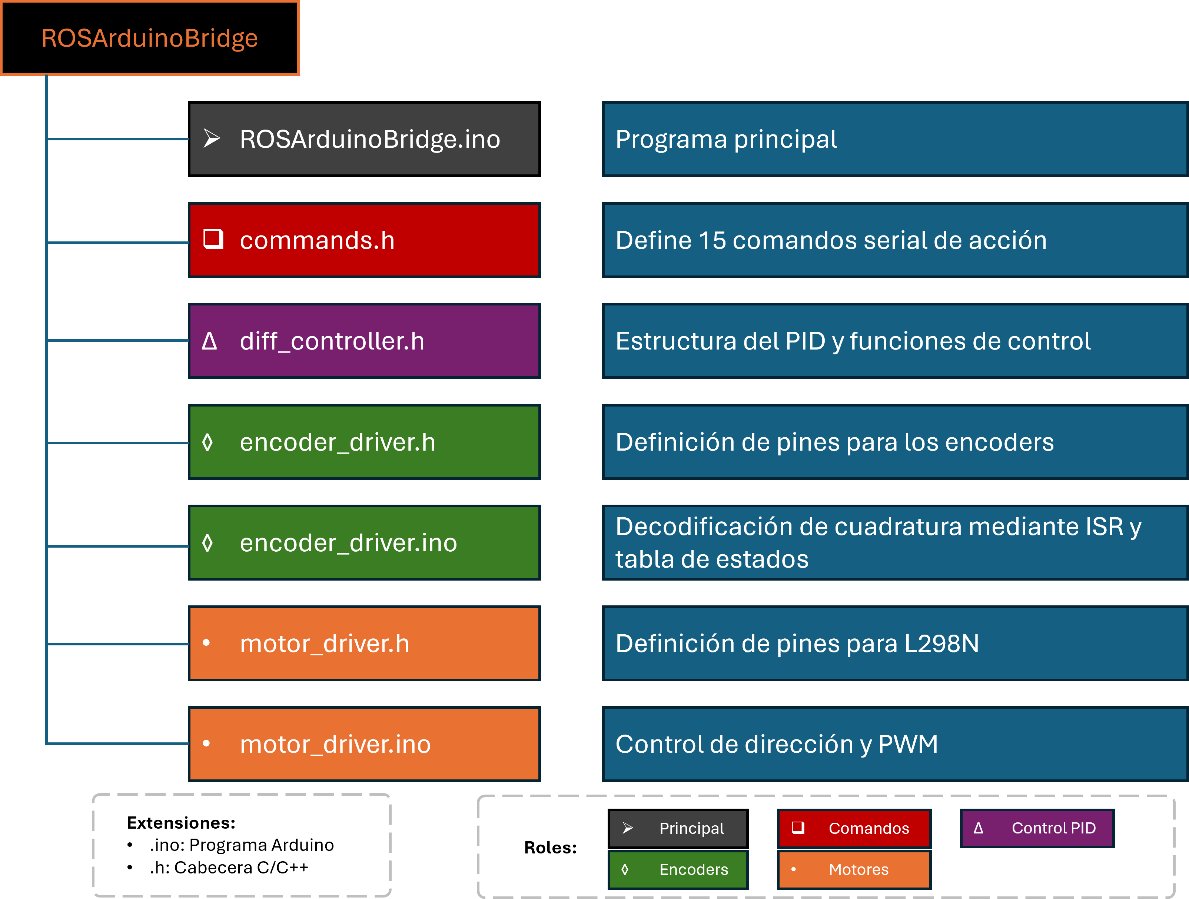
_sin_uso/2.Texto/Imag/arbol_archivos_firmware.png
