SVN11X/doc_tesis/_sin_uso/2.Texto/Imag/arduino_nano.jpg

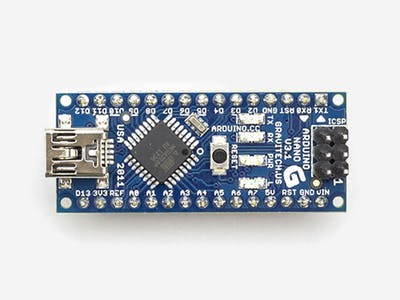
_sin_uso/2.Texto/Imag/arduino_nano.jpg
