SVN11X/doc_tesis/_sin_uso/2.Texto/Imag/ball_caster.png

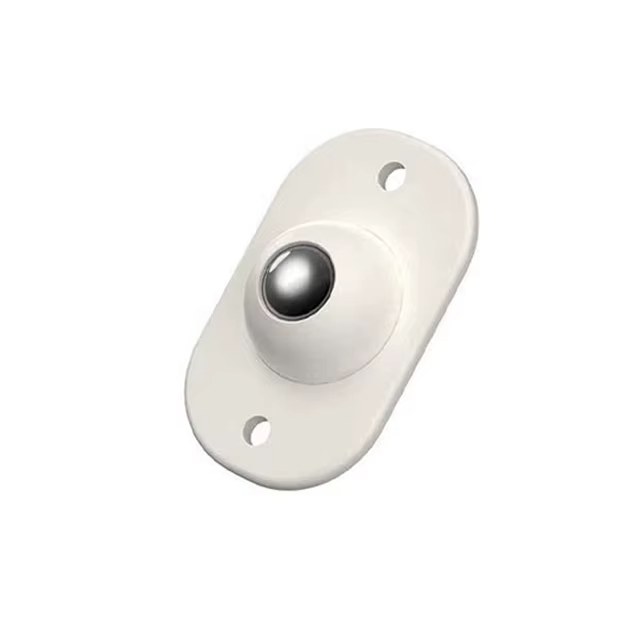
_sin_uso/2.Texto/Imag/ball_caster.png
