SVN11X/doc_tesis/_sin_uso/2.Texto/Imag/battery.png

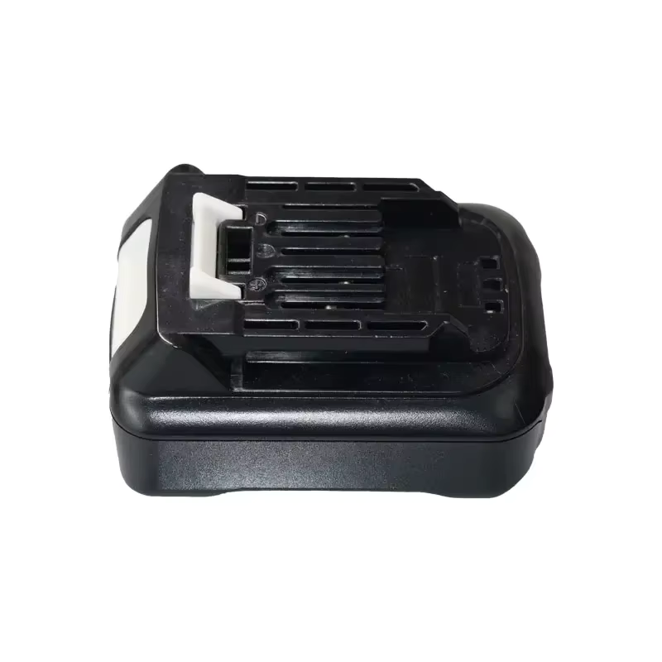
_sin_uso/2.Texto/Imag/battery.png
