SVN11X/doc_tesis/_sin_uso/2.Texto/Imag/camara_fov.jpg

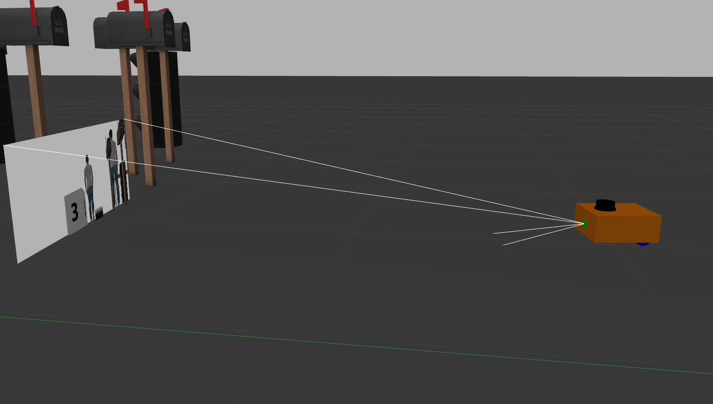
_sin_uso/2.Texto/Imag/camara_fov.jpg
