SVN11X/doc_tesis/_sin_uso/2.Texto/Imag/camara_pi.jpg

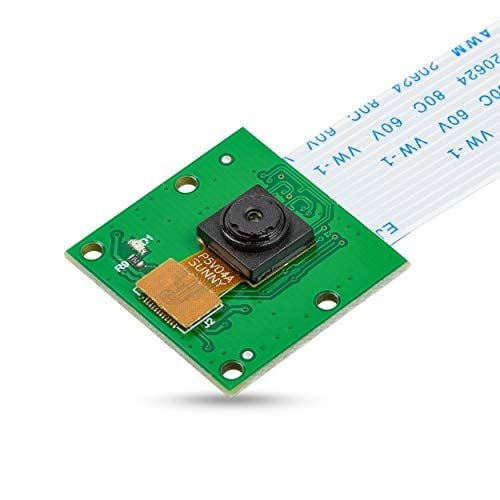
_sin_uso/2.Texto/Imag/camara_pi.jpg
