SVN11X/doc_tesis/_sin_uso/2.Texto/Imag/cir.png

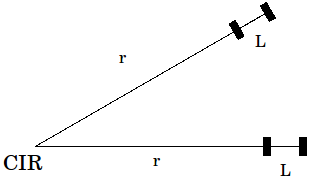
_sin_uso/2.Texto/Imag/cir.png
