SVN11X/doc_tesis/_sin_uso/2.Texto/Imag/combinacionAB.jpg

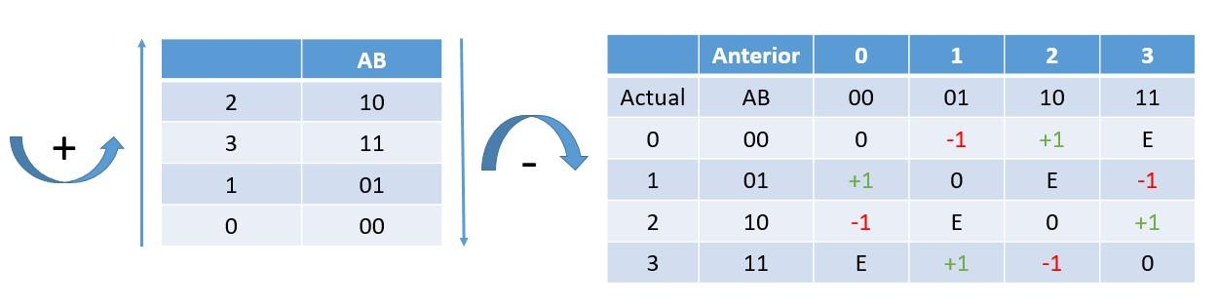
_sin_uso/2.Texto/Imag/combinacionAB.jpg
