SVN11X/doc_tesis/_sin_uso/2.Texto/Imag/control_lambda.png

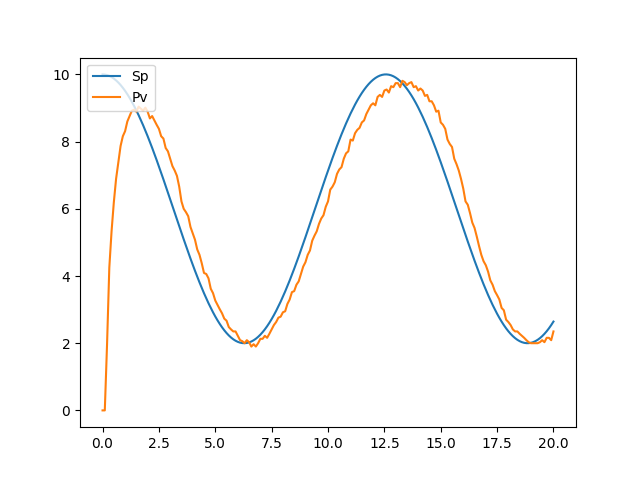
_sin_uso/2.Texto/Imag/control_lambda.png
