SVN11X/doc_tesis/_sin_uso/2.Texto/Imag/curva_exponencial.png

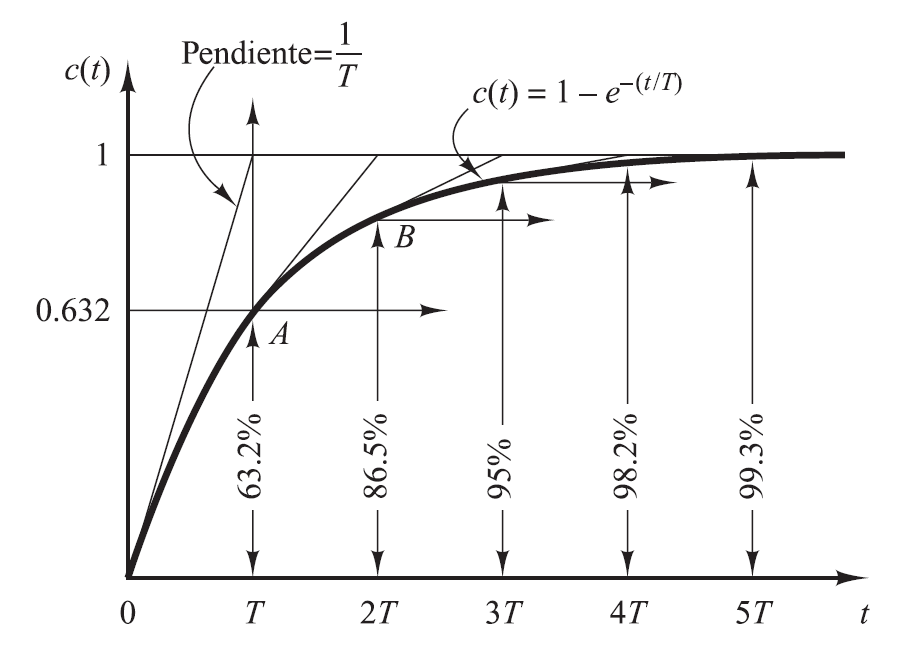
_sin_uso/2.Texto/Imag/curva_exponencial.png
