SVN11X/doc_tesis/_sin_uso/2.Texto/Imag/cv_control_lambda_corregido.png

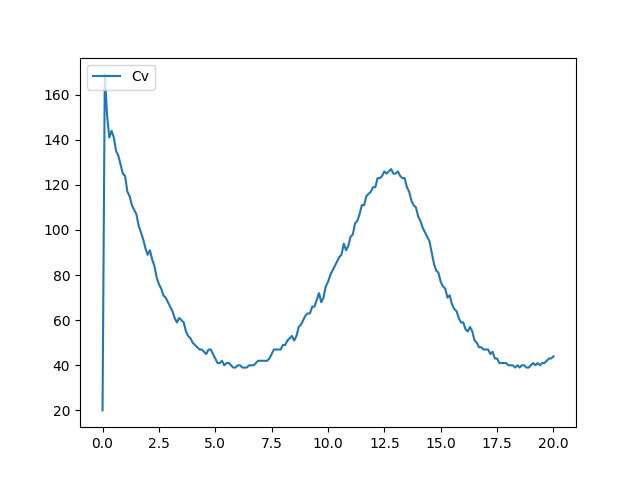
_sin_uso/2.Texto/Imag/cv_control_lambda_corregido.png
