SVN11X/doc_tesis/_sin_uso/2.Texto/Imag/cv_lazo_abierto.png

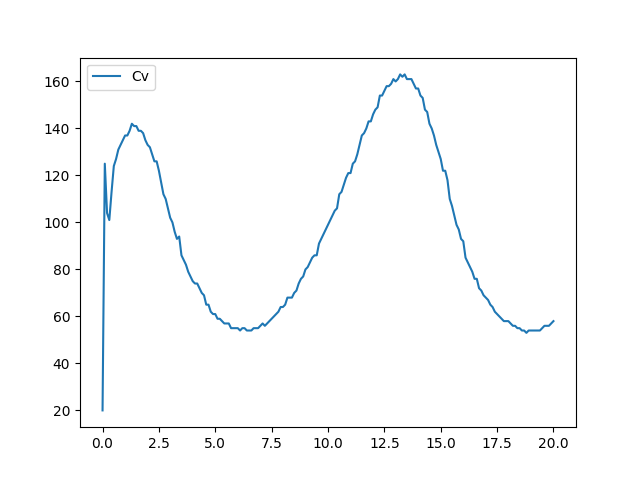
_sin_uso/2.Texto/Imag/cv_lazo_abierto.png
