SVN11X/doc_tesis/_sin_uso/2.Texto/Imag/diagrama_arquitectura_firmware.png

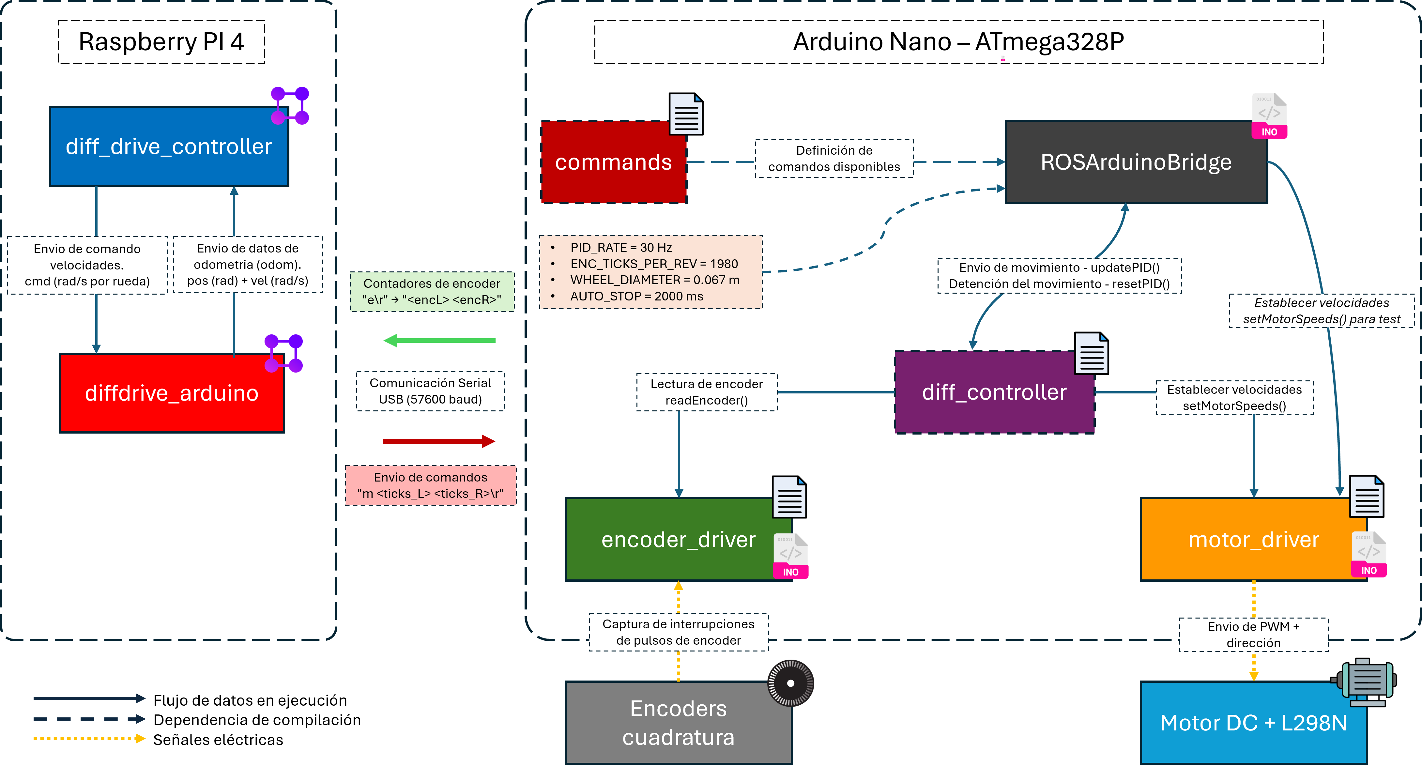
_sin_uso/2.Texto/Imag/diagrama_arquitectura_firmware.png
