SVN11X/doc_tesis/_sin_uso/2.Texto/Imag/diagrama_flujo_sincronizacion.png

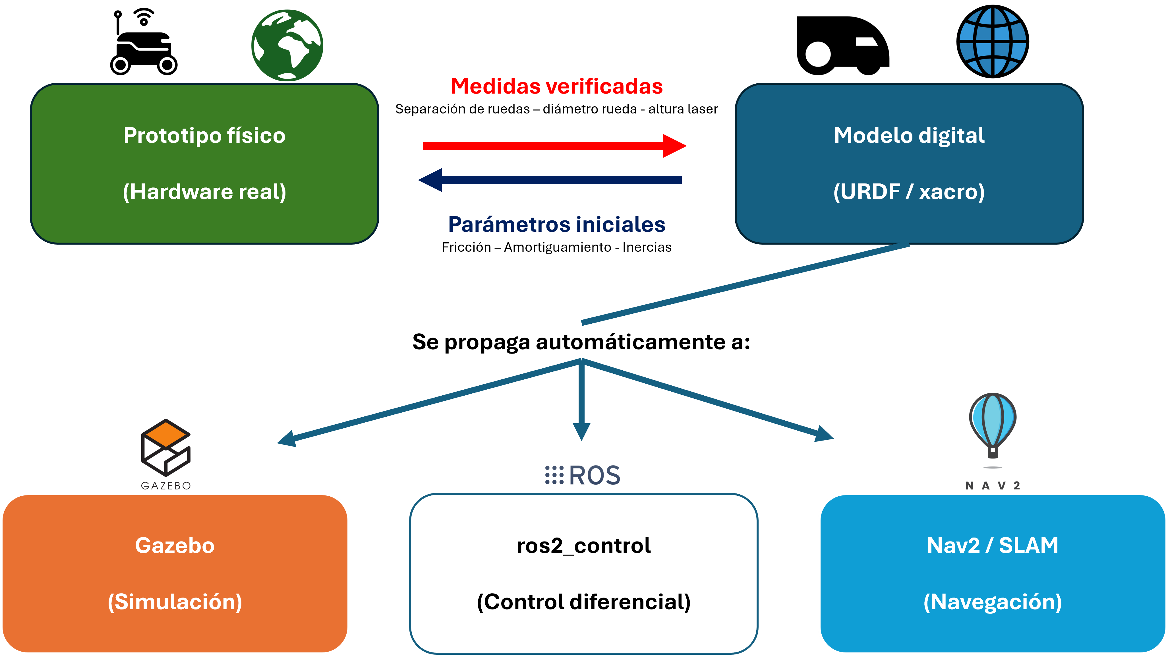
_sin_uso/2.Texto/Imag/diagrama_flujo_sincronizacion.png
