SVN11X/doc_tesis/_sin_uso/2.Texto/Imag/diff_bec.png

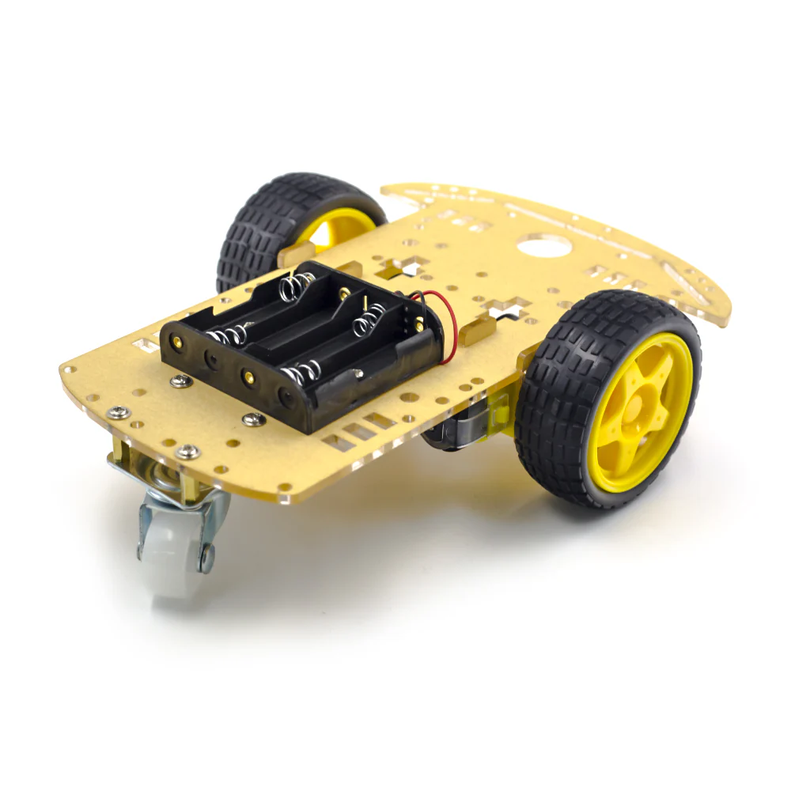
_sin_uso/2.Texto/Imag/diff_bec.png
