SVN11X/doc_tesis/_sin_uso/2.Texto/Imag/e_seno.jpg

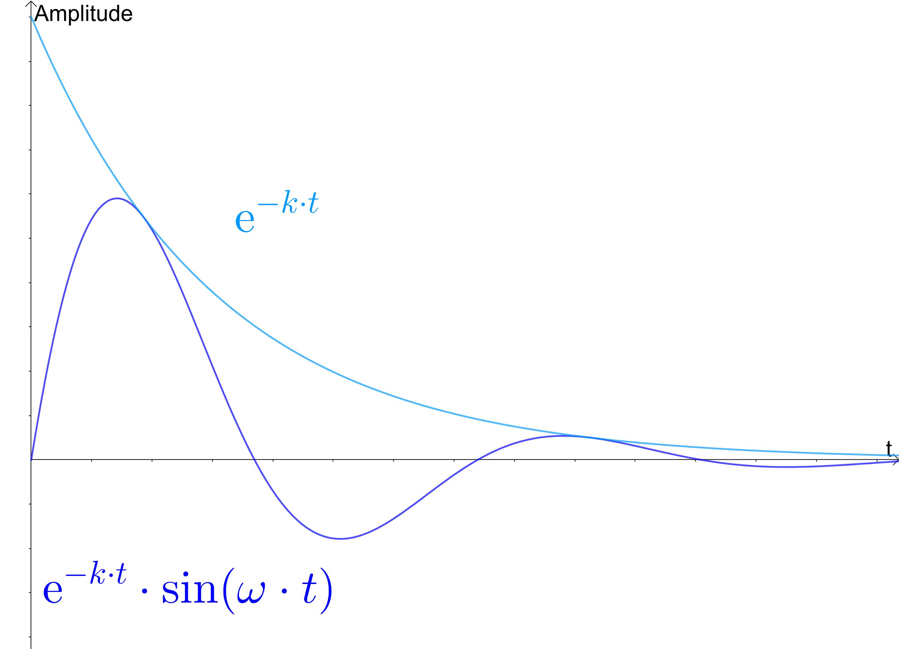
_sin_uso/2.Texto/Imag/e_seno.jpg
