SVN11X/doc_tesis/_sin_uso/2.Texto/Imag/e_seno_f.jpg

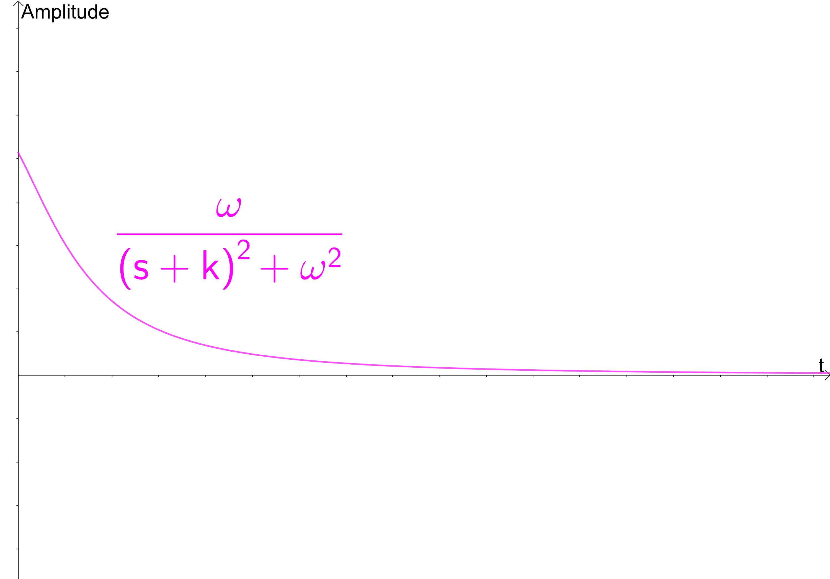
_sin_uso/2.Texto/Imag/e_seno_f.jpg
