SVN11X/doc_tesis/_sin_uso/2.Texto/Imag/e_sobreamort.jpg

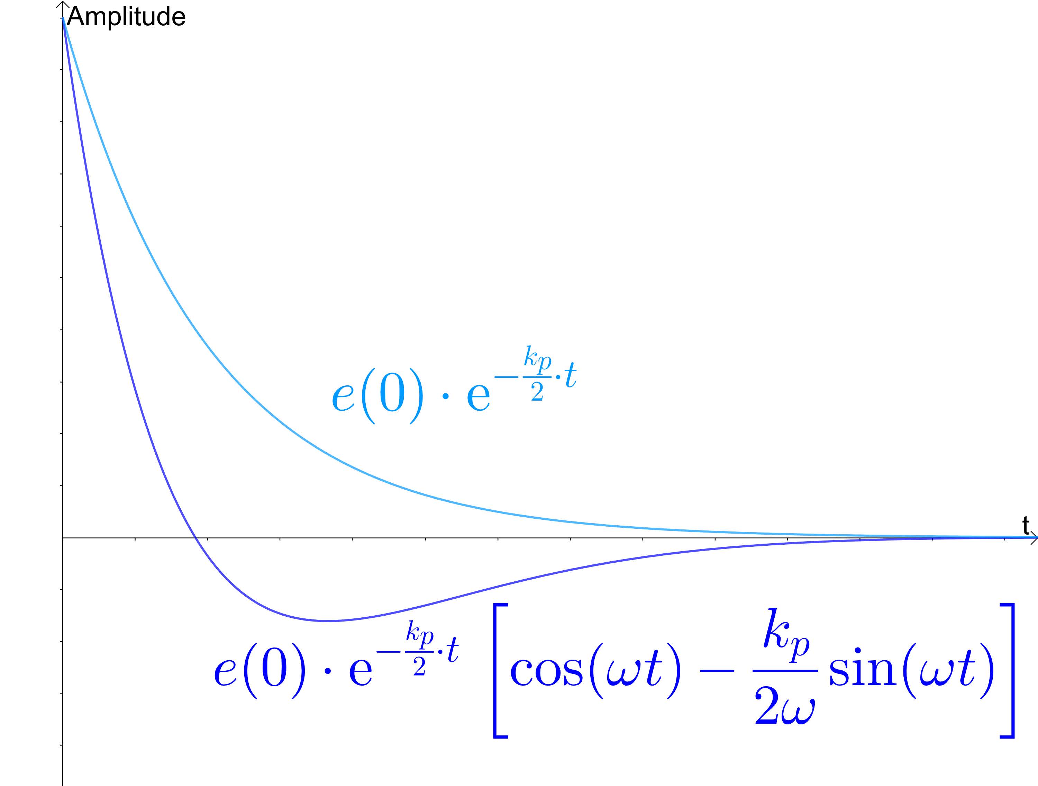
_sin_uso/2.Texto/Imag/e_sobreamort.jpg
