SVN11X/doc_tesis/_sin_uso/2.Texto/Imag/e_sobreamort_PID.jpg

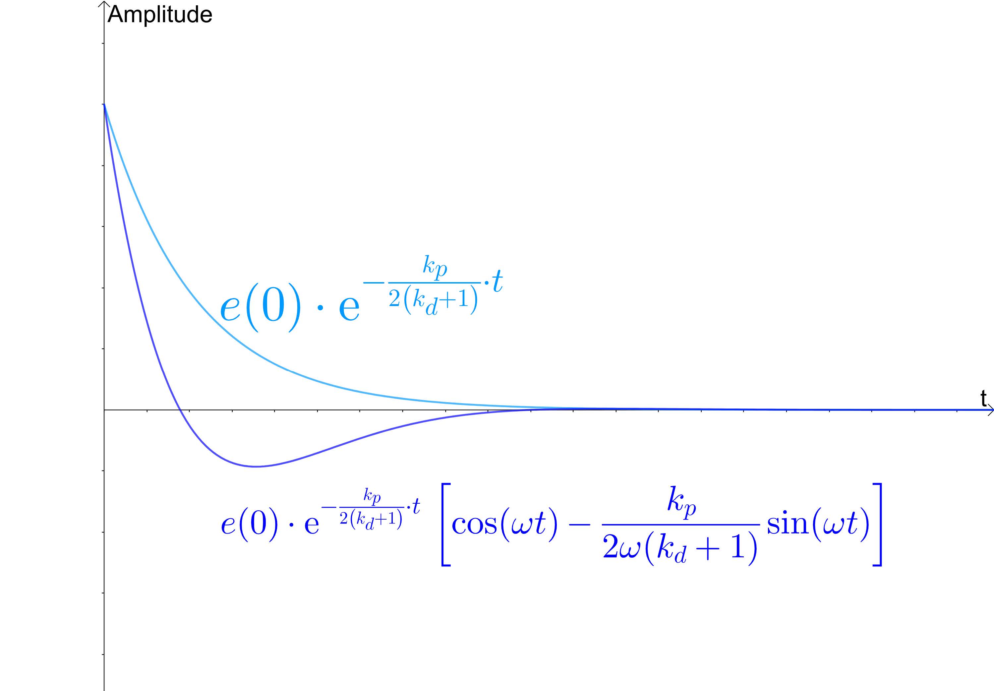
_sin_uso/2.Texto/Imag/e_sobreamort_PID.jpg
