SVN11X/doc_tesis/_sin_uso/2.Texto/Imag/ender_3.jpg

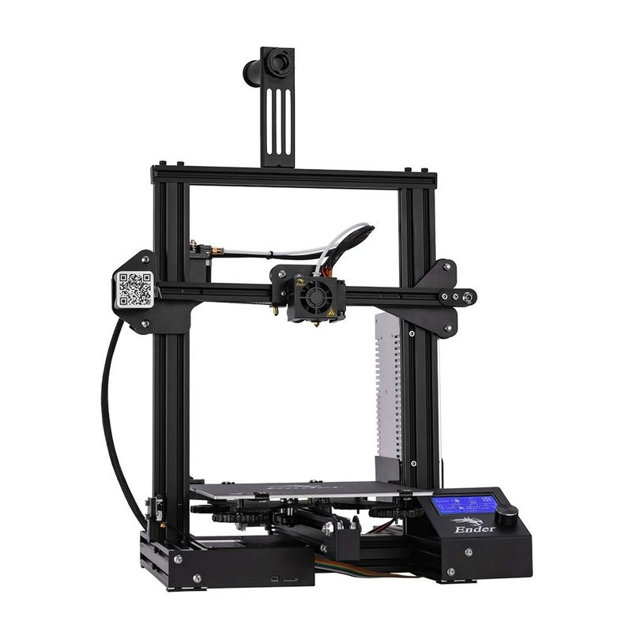
_sin_uso/2.Texto/Imag/ender_3.jpg
