SVN11X/doc_tesis/_sin_uso/2.Texto/Imag/escenario_visual.jpg

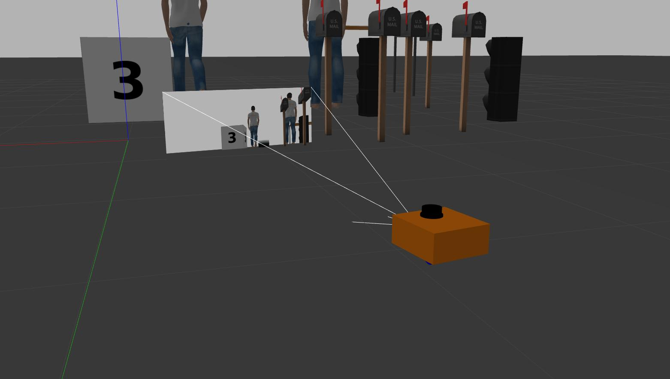
_sin_uso/2.Texto/Imag/escenario_visual.jpg
