SVN11X/doc_tesis/_sin_uso/2.Texto/Imag/estado_arte_dji_phantom.png

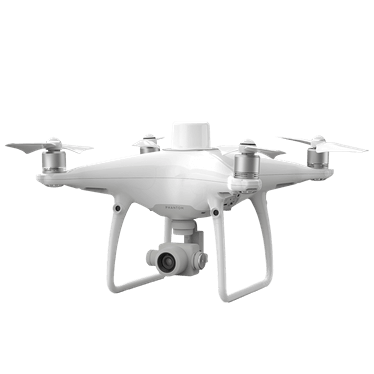
_sin_uso/2.Texto/Imag/estado_arte_dji_phantom.png
