SVN11X/doc_tesis/_sin_uso/2.Texto/Imag/estado_arte_remus.png

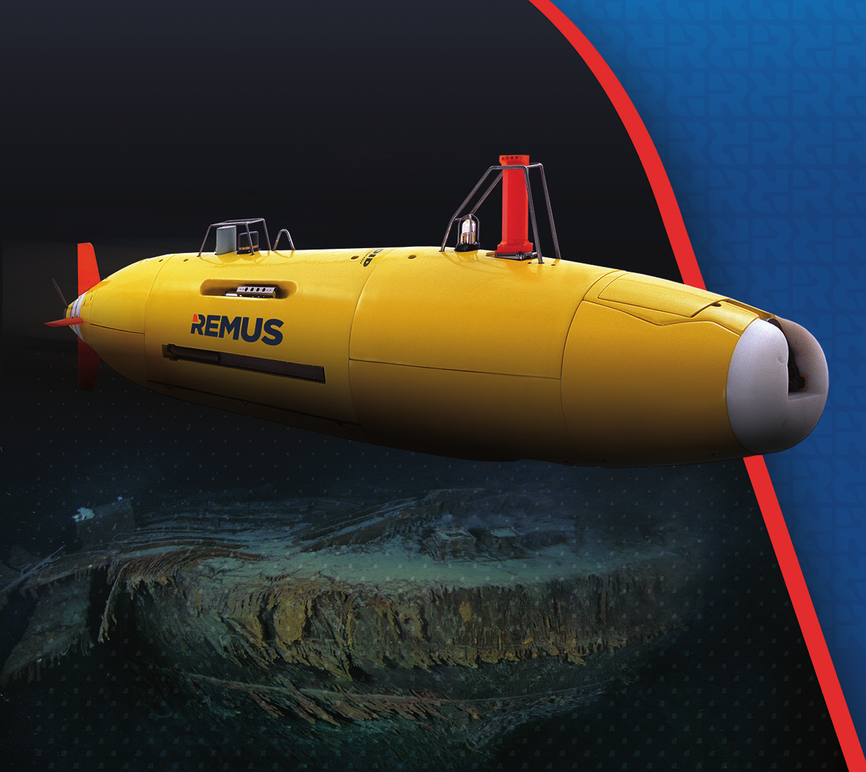
_sin_uso/2.Texto/Imag/estado_arte_remus.png
