SVN11X/doc_tesis/_sin_uso/2.Texto/Imag/evolucion_e.jpg

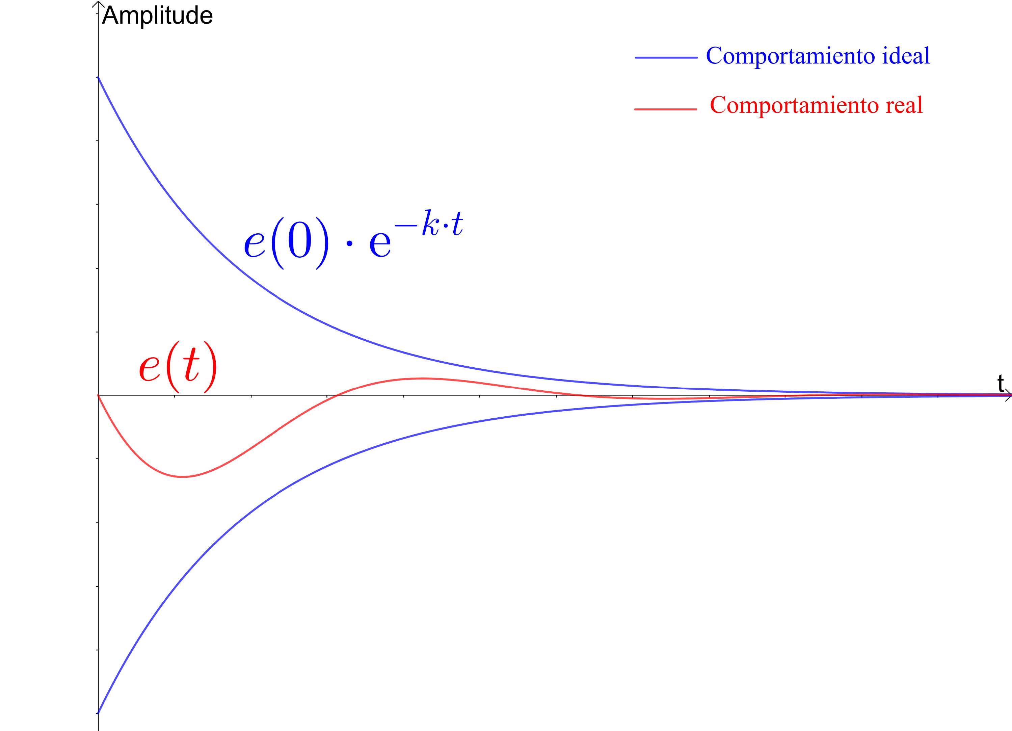
_sin_uso/2.Texto/Imag/evolucion_e.jpg
