SVN11X/doc_tesis/_sin_uso/2.Texto/Imag/fig_bt_tree.png

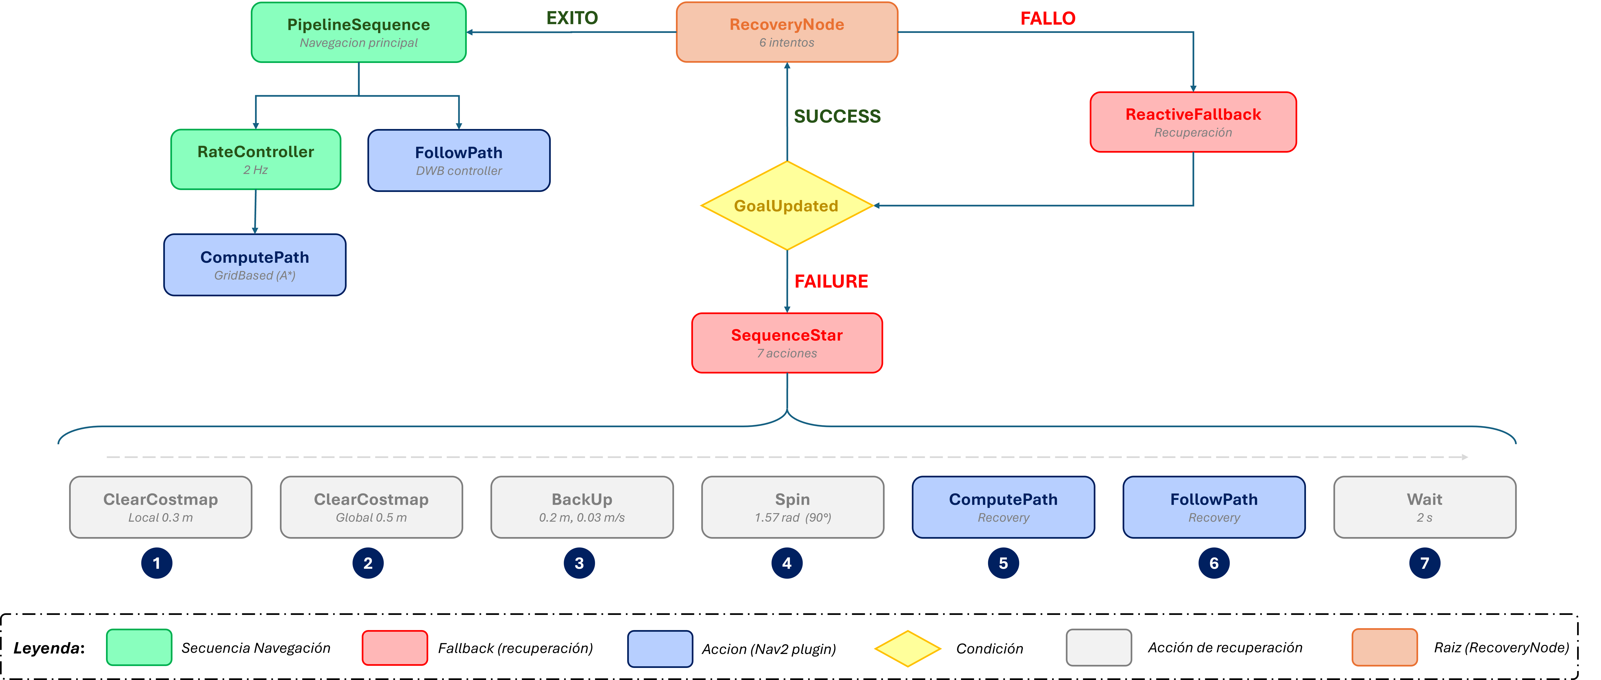
_sin_uso/2.Texto/Imag/fig_bt_tree.png
