SVN11X/doc_tesis/_sin_uso/2.Texto/Imag/fig_captura_terminal_salida_ros2_topic_hz_odom.png

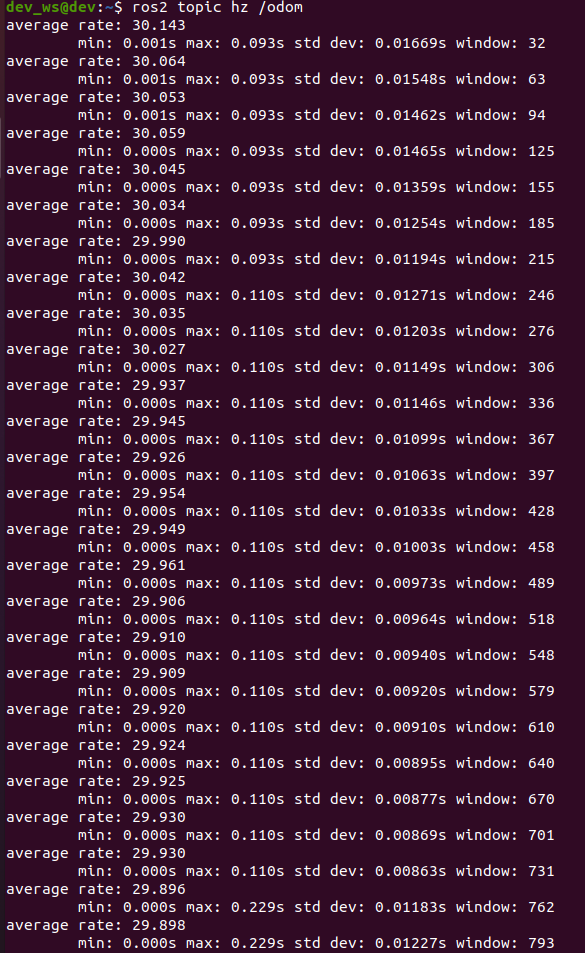
_sin_uso/2.Texto/Imag/fig_captura_terminal_salida_ros2_topic_hz_odom.png
