SVN11X/doc_tesis/_sin_uso/2.Texto/Imag/fig_conversion_unidades.png

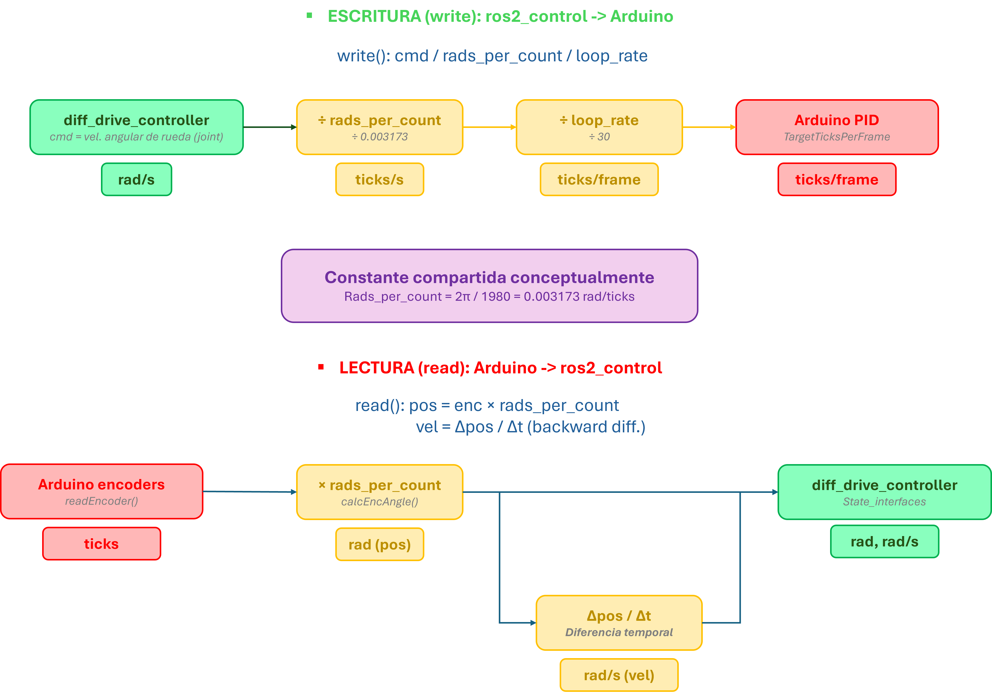
_sin_uso/2.Texto/Imag/fig_conversion_unidades.png
