SVN11X/doc_tesis/_sin_uso/2.Texto/Imag/fig_flowchart_validacion.png

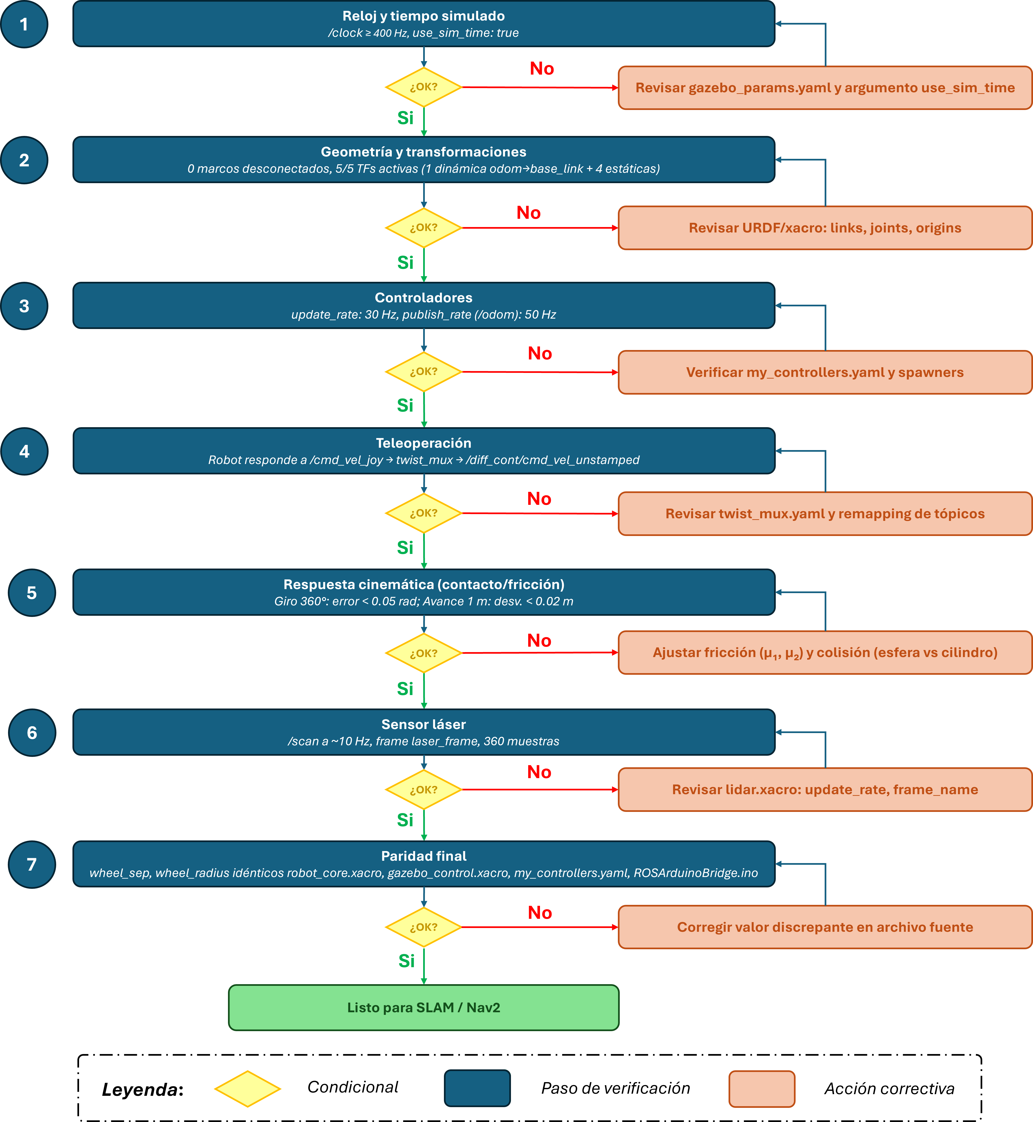
_sin_uso/2.Texto/Imag/fig_flowchart_validacion.png
