SVN11X/doc_tesis/_sin_uso/2.Texto/Imag/fig_flujo_control_diferencial.png

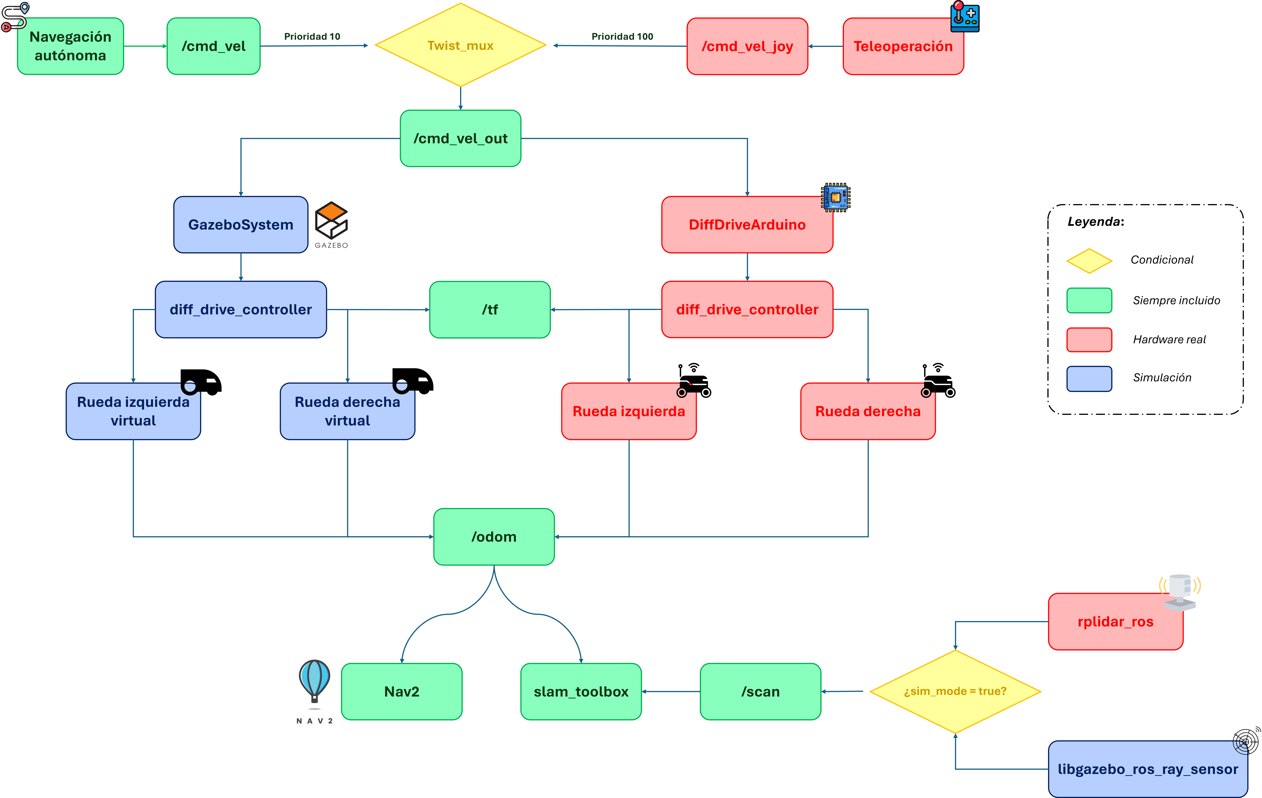
_sin_uso/2.Texto/Imag/fig_flujo_control_diferencial.png
