SVN11X/doc_tesis/_sin_uso/2.Texto/Imag/fig_giro 360_part1.png

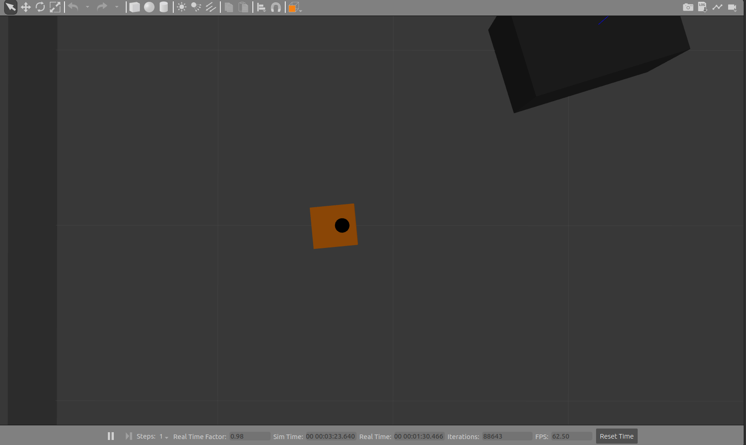
_sin_uso/2.Texto/Imag/fig_giro 360_part1.png
