SVN11X/doc_tesis/_sin_uso/2.Texto/Imag/fig_power_budget.png

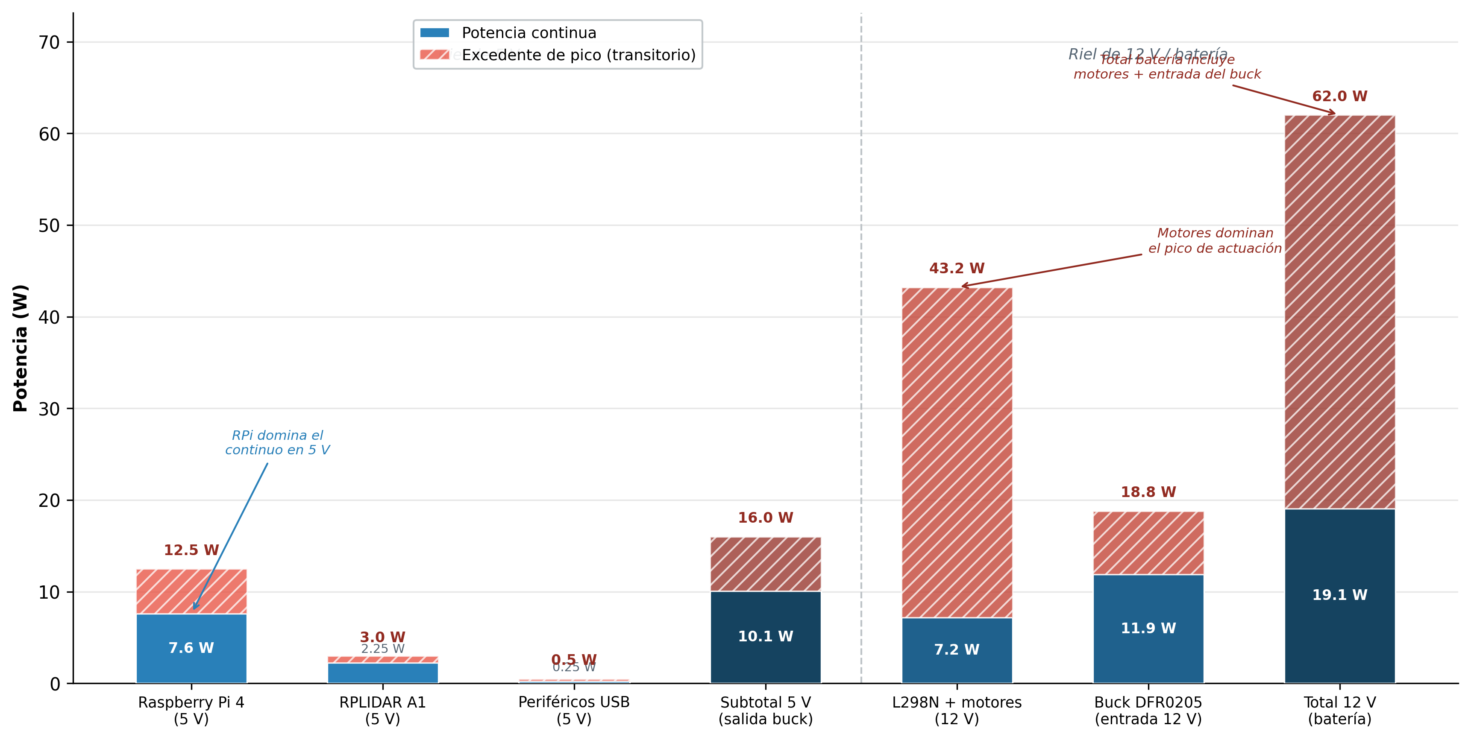
_sin_uso/2.Texto/Imag/fig_power_budget.png
