SVN11X/doc_tesis/_sin_uso/2.Texto/Imag/fig_prototipo_frontal.jpg

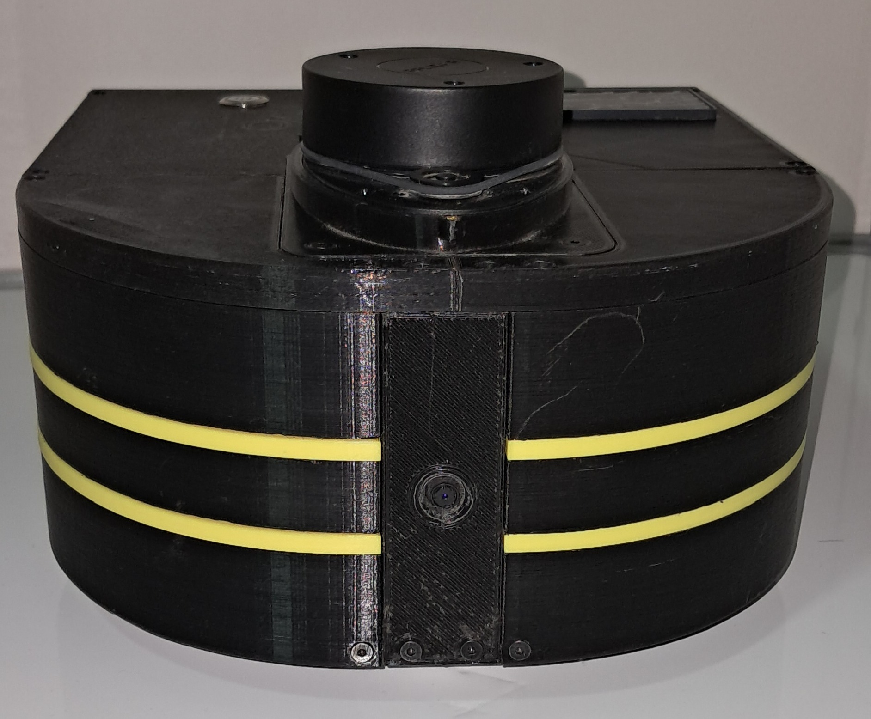
_sin_uso/2.Texto/Imag/fig_prototipo_frontal.jpg
