SVN11X/doc_tesis/_sin_uso/2.Texto/Imag/fig_prototipo_lateral_derecha.jpg

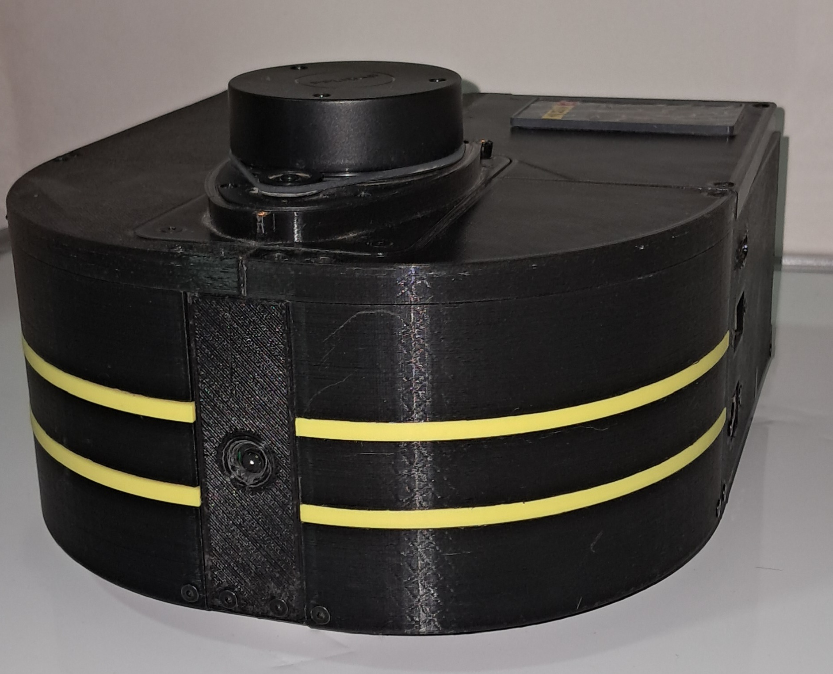
_sin_uso/2.Texto/Imag/fig_prototipo_lateral_derecha.jpg
