SVN11X/doc_tesis/_sin_uso/2.Texto/Imag/fig_robot_real.PNG

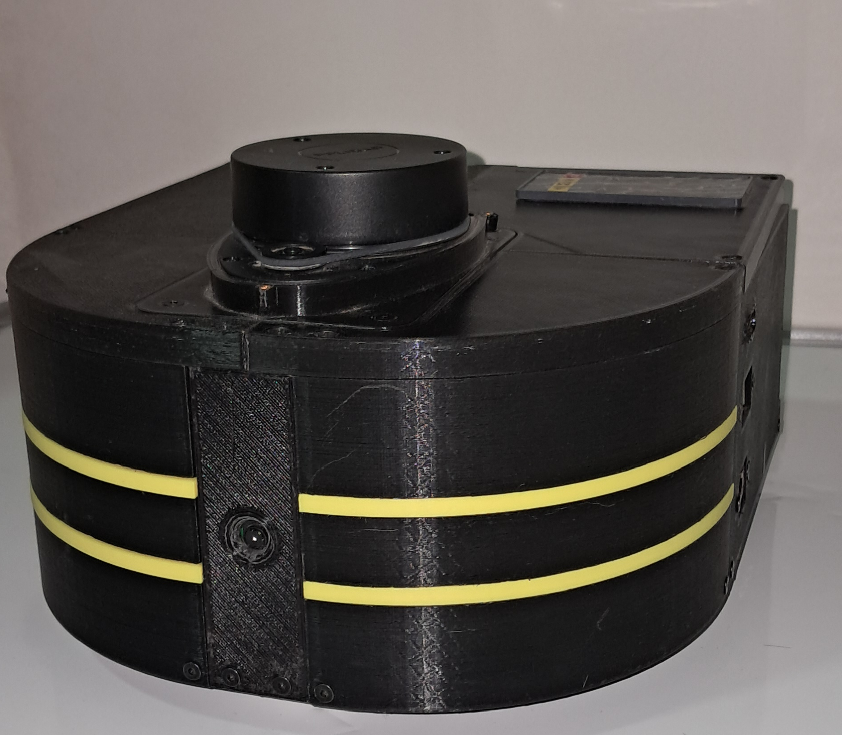
_sin_uso/2.Texto/Imag/fig_robot_real.PNG
