SVN11X/doc_tesis/_sin_uso/2.Texto/Imag/fig_secuencia_arranque.png

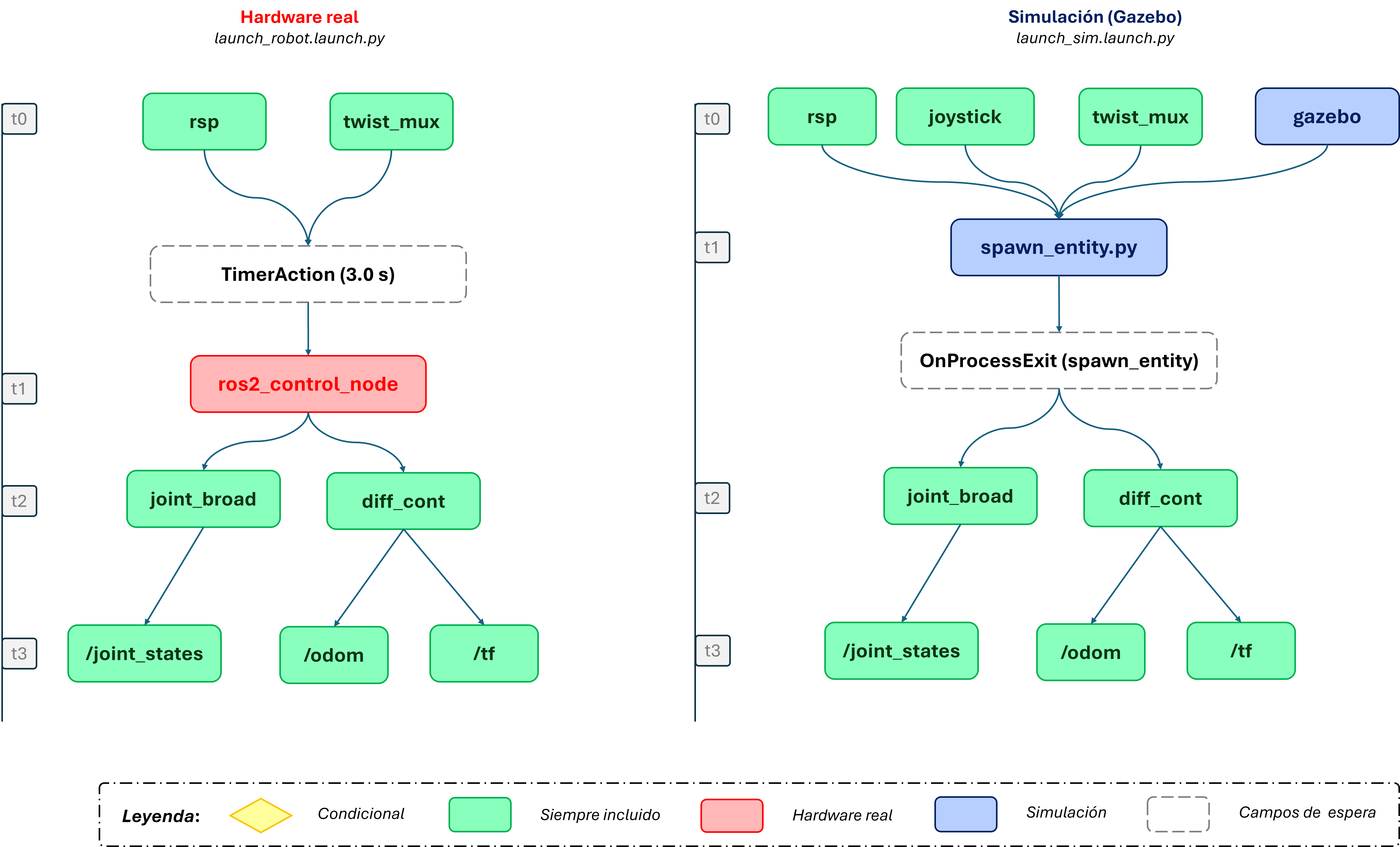
_sin_uso/2.Texto/Imag/fig_secuencia_arranque.png
