SVN11X/doc_tesis/_sin_uso/2.Texto/Imag/fig_trayectoria_L_part1.png

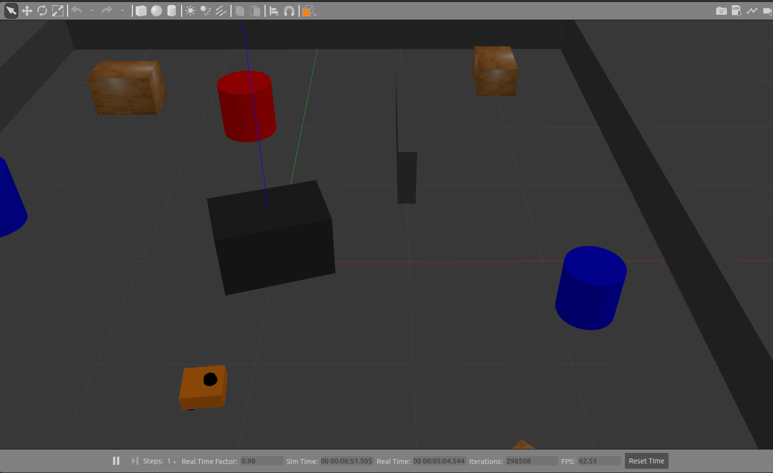
_sin_uso/2.Texto/Imag/fig_trayectoria_L_part1.png
