SVN11X/doc_tesis/_sin_uso/2.Texto/Imag/fig_xacro_decision_tree.png

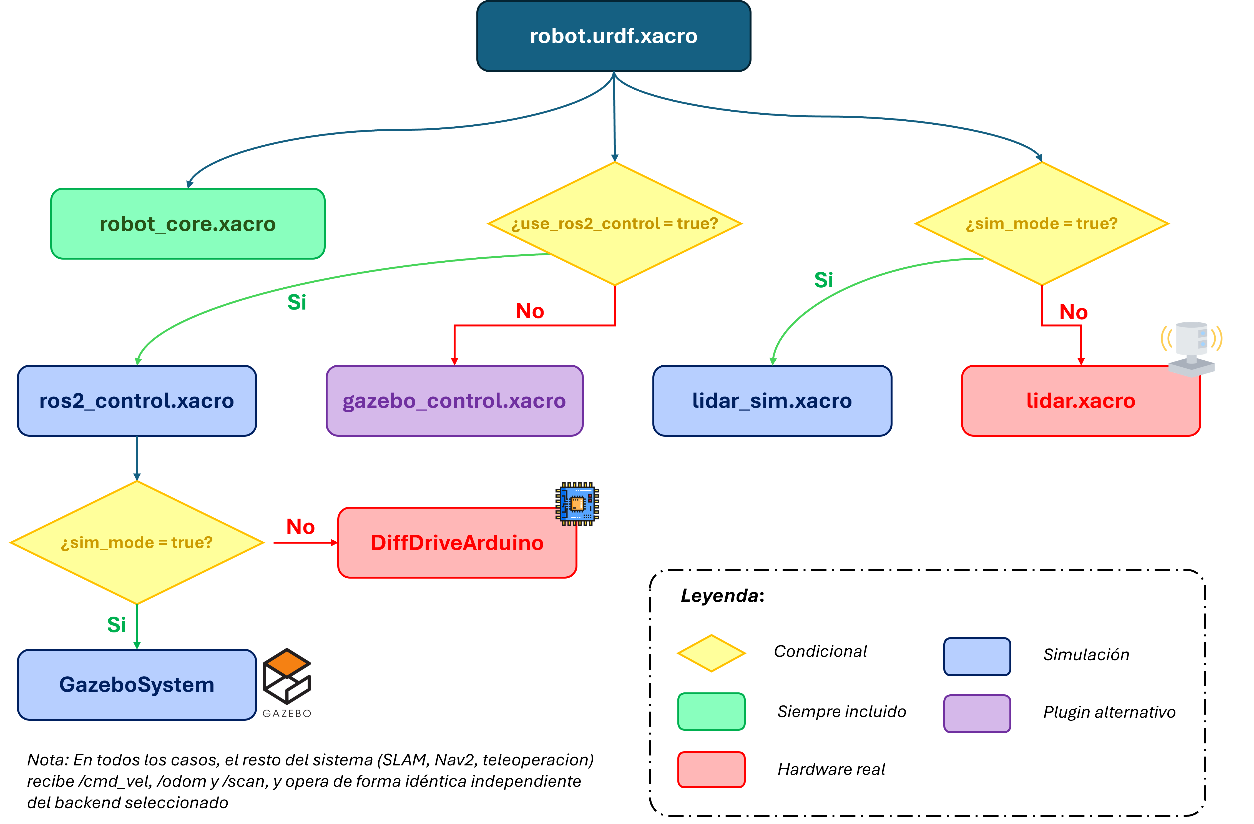
_sin_uso/2.Texto/Imag/fig_xacro_decision_tree.png
