SVN11X/doc_tesis/_sin_uso/2.Texto/Imag/flow_urdf_files.png

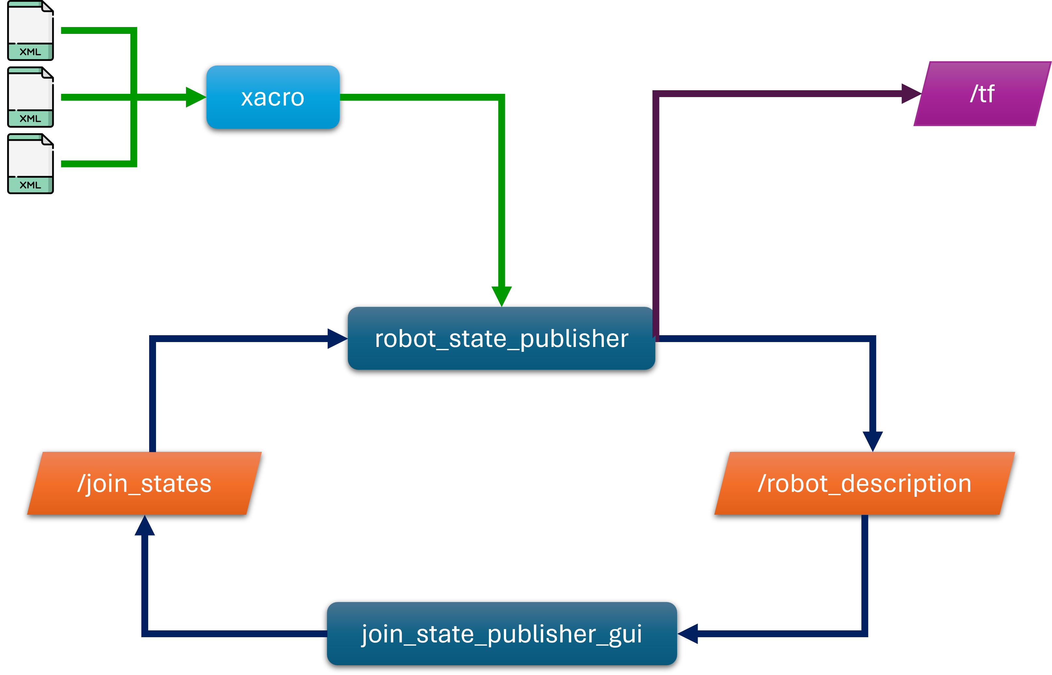
_sin_uso/2.Texto/Imag/flow_urdf_files.png
