SVN11X/doc_tesis/_sin_uso/2.Texto/Imag/flow_xacro.png

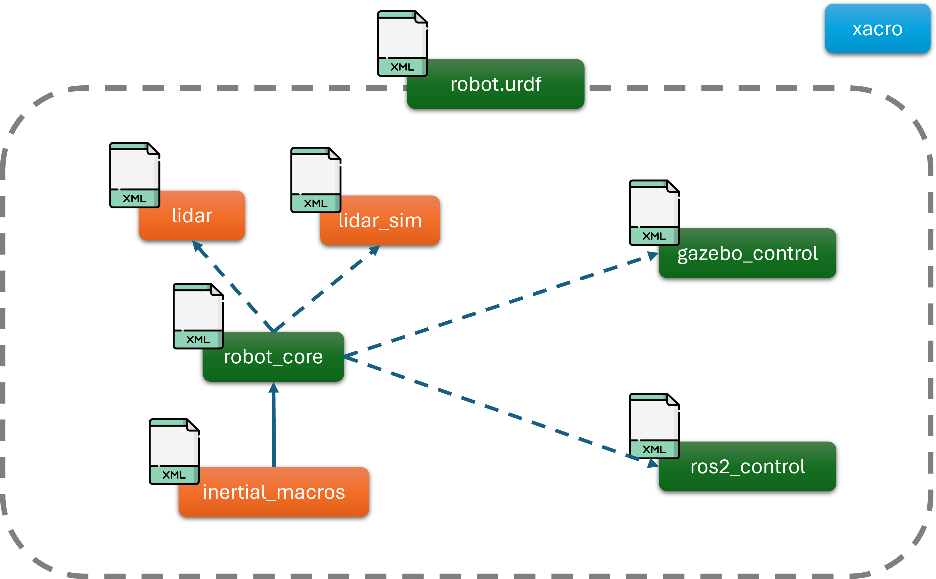
_sin_uso/2.Texto/Imag/flow_xacro.png
