SVN11X/doc_tesis/_sin_uso/2.Texto/Imag/funcion_candidata.png

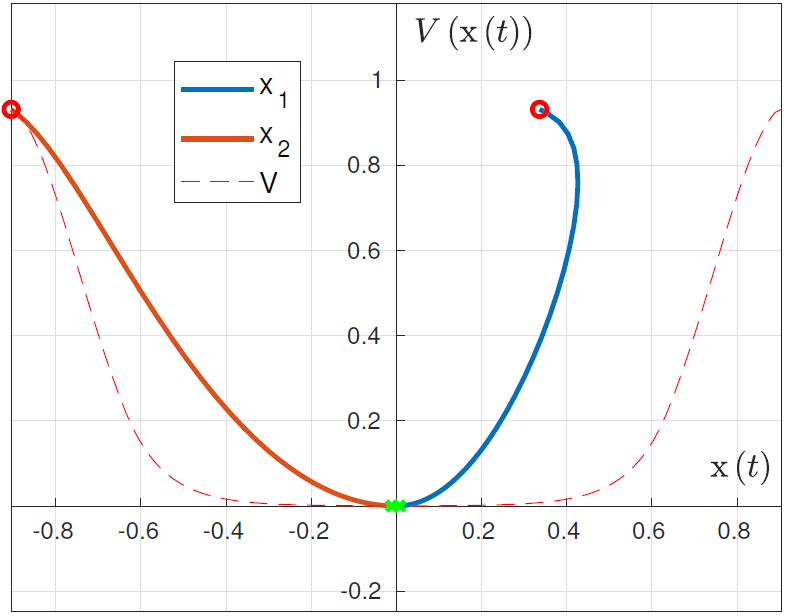
_sin_uso/2.Texto/Imag/funcion_candidata.png
