SVN11X/doc_tesis/_sin_uso/2.Texto/Imag/gazebo_plugin.png

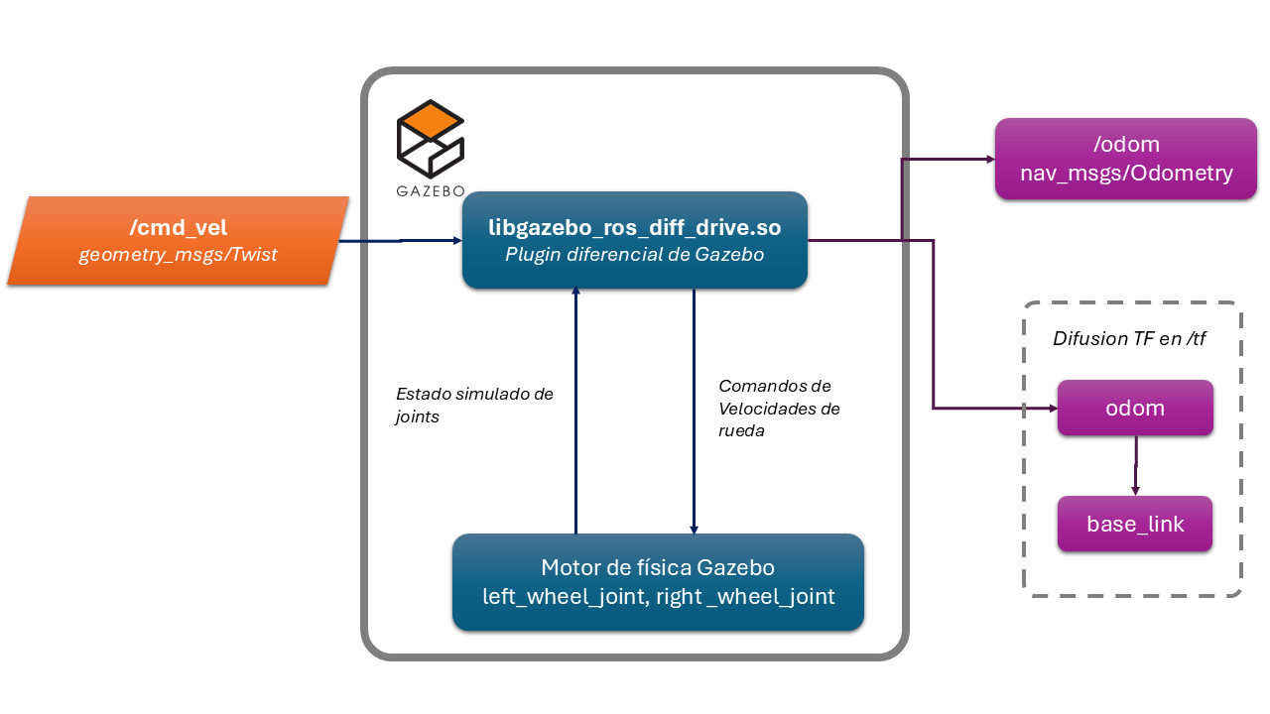
_sin_uso/2.Texto/Imag/gazebo_plugin.png
