SVN11X/doc_tesis/_sin_uso/2.Texto/Imag/gazebo_world_overview.jpg

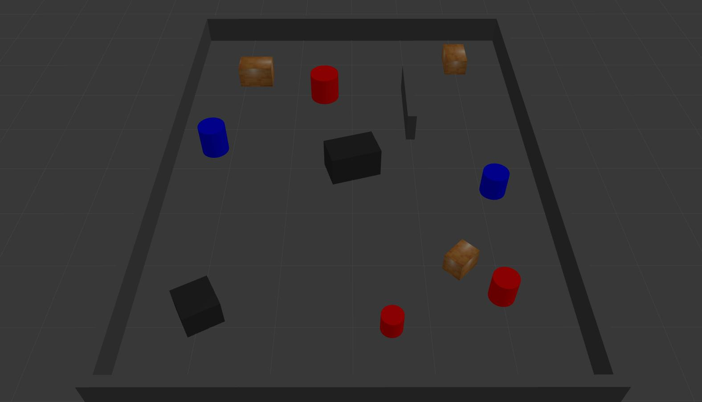
_sin_uso/2.Texto/Imag/gazebo_world_overview.jpg
