SVN11X/doc_tesis/_sin_uso/2.Texto/Imag/identificacion_y_sintonizacion_pso.png

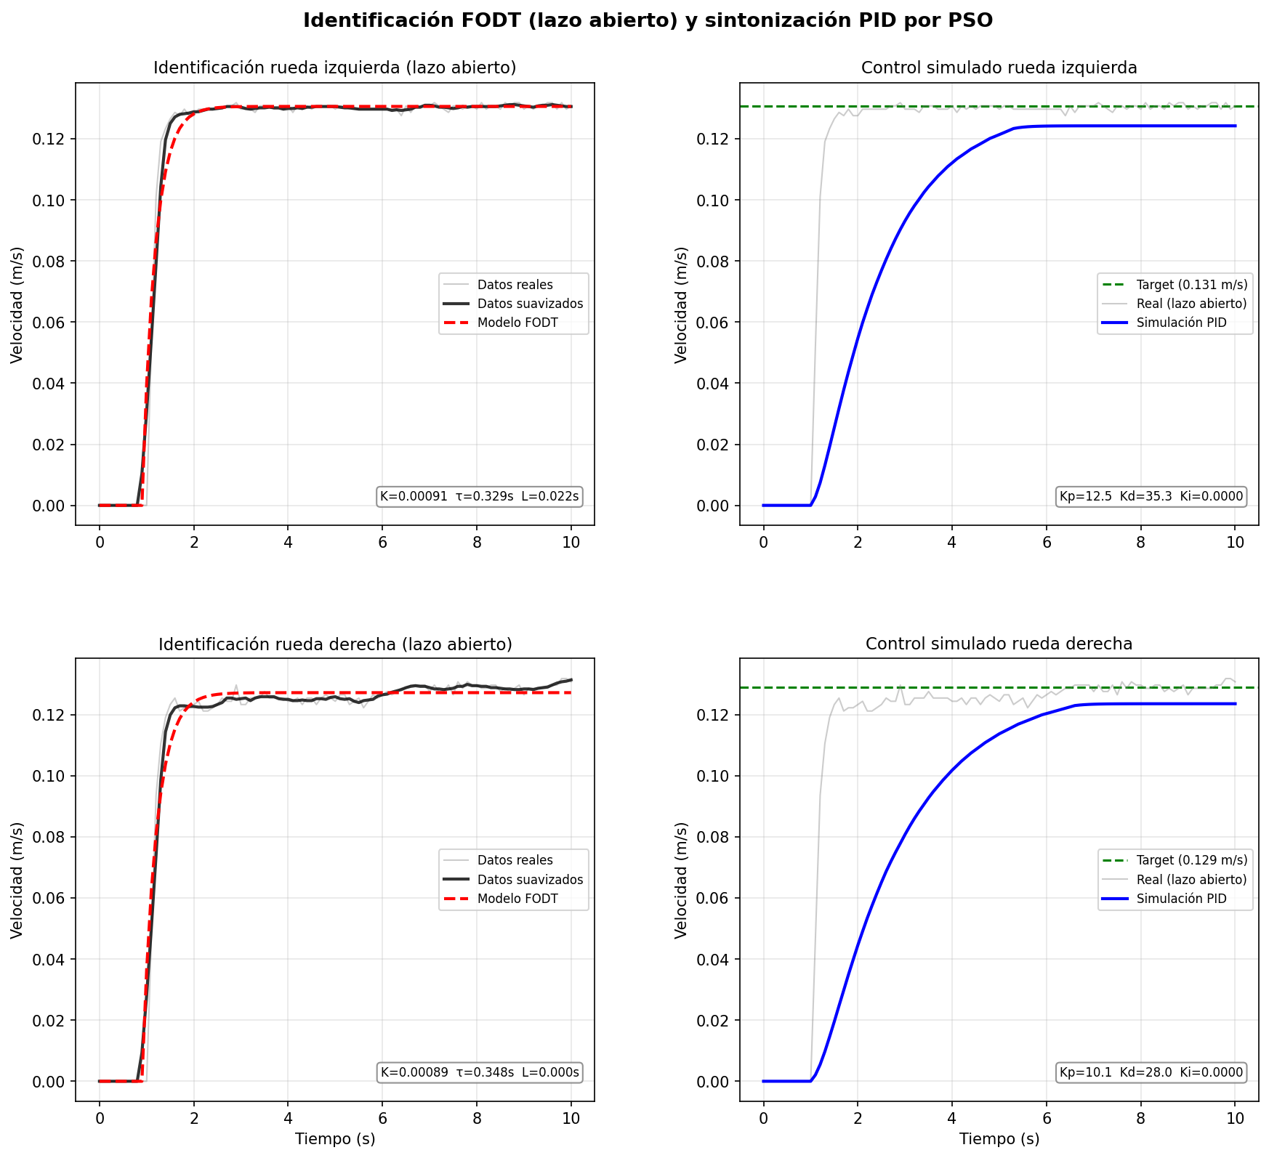
_sin_uso/2.Texto/Imag/identificacion_y_sintonizacion_pso.png
