SVN11X/doc_tesis/_sin_uso/2.Texto/Imag/l298n.png

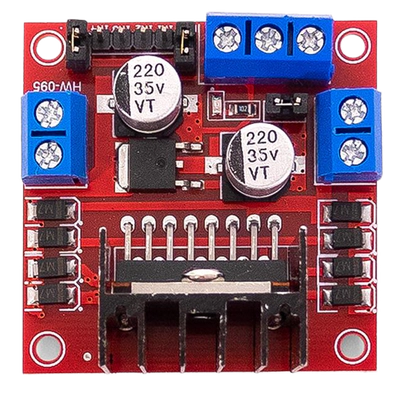
_sin_uso/2.Texto/Imag/l298n.png
