SVN11X/doc_tesis/_sin_uso/2.Texto/Imag/lazo abierto correcion.png

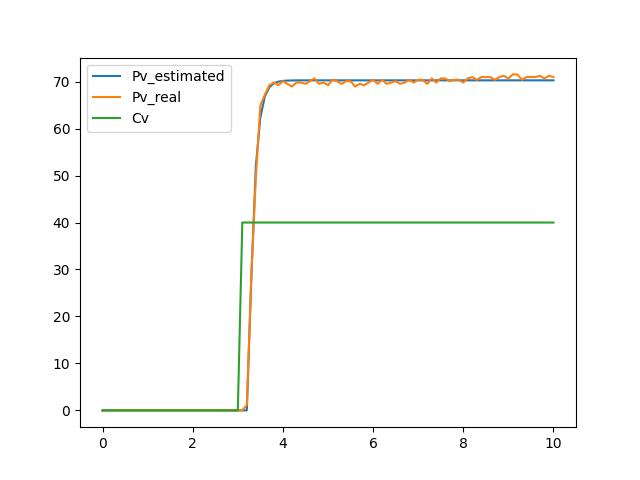
_sin_uso/2.Texto/Imag/lazo abierto correcion.png
