SVN11X/doc_tesis/_sin_uso/2.Texto/Imag/lazo abierto.png

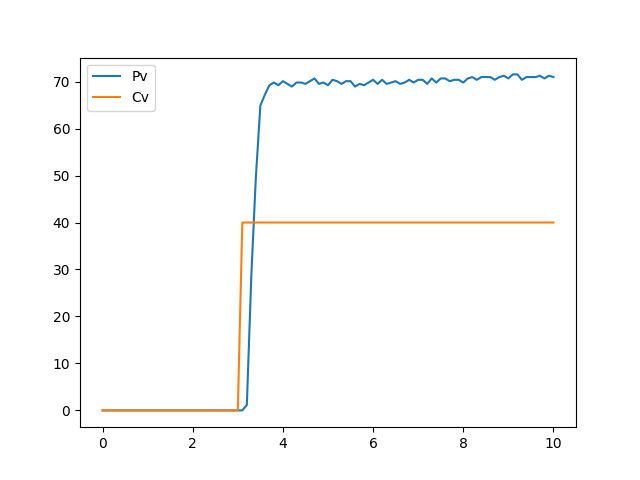
_sin_uso/2.Texto/Imag/lazo abierto.png
