SVN11X/doc_tesis/_sin_uso/2.Texto/Imag/lazo_abierto_perfecto.png

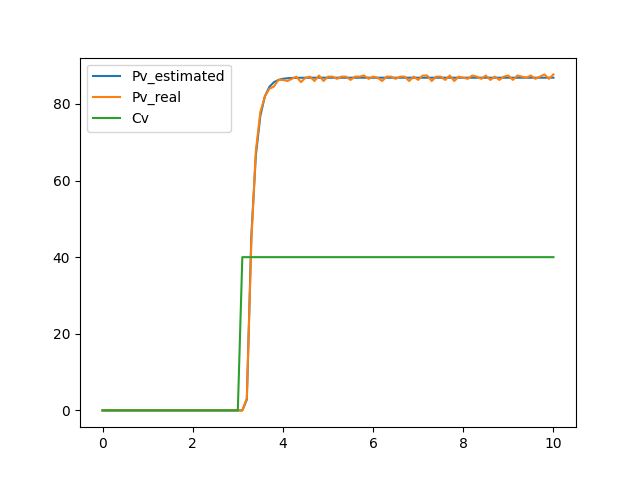
_sin_uso/2.Texto/Imag/lazo_abierto_perfecto.png
