SVN11X/doc_tesis/_sin_uso/2.Texto/Imag/lidar_rviz_obstaculos.png

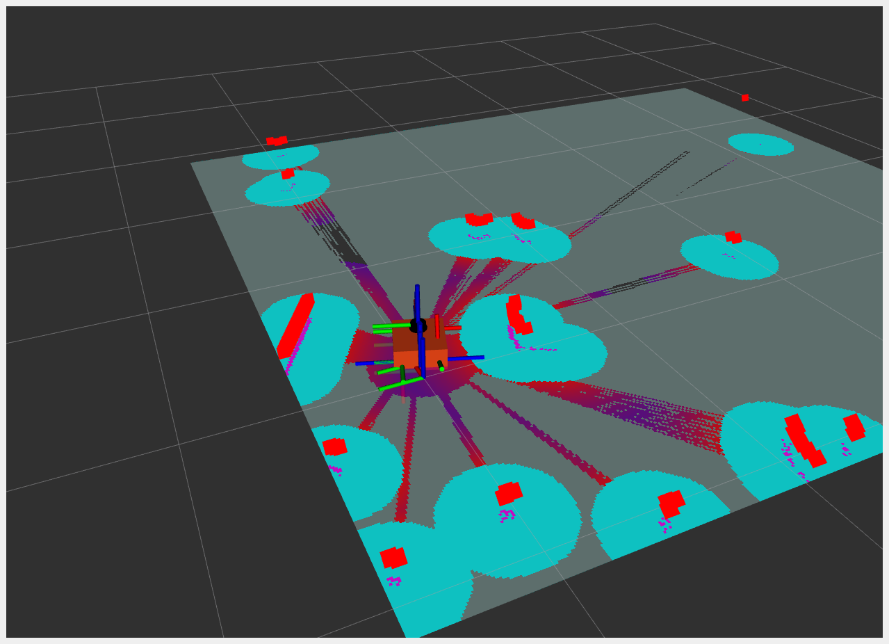
_sin_uso/2.Texto/Imag/lidar_rviz_obstaculos.png
