SVN11X/doc_tesis/_sin_uso/2.Texto/Imag/locobot_lite.jpg

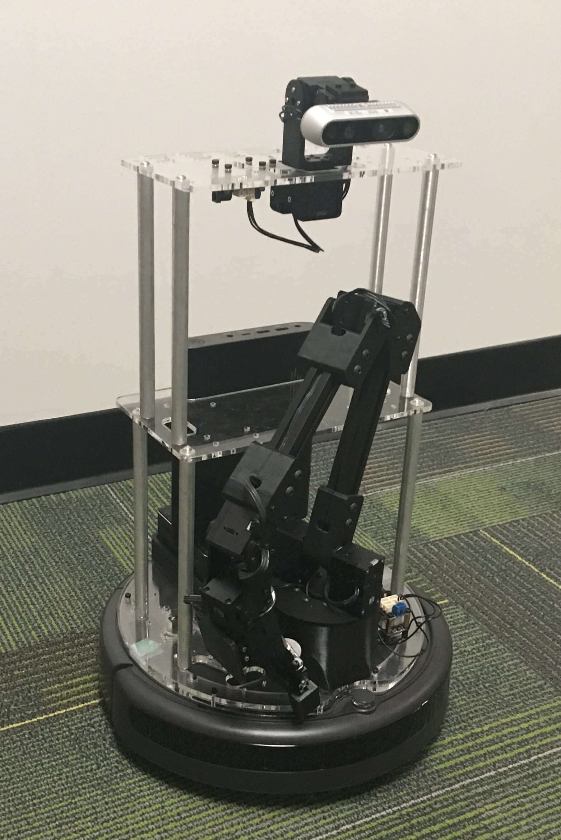
_sin_uso/2.Texto/Imag/locobot_lite.jpg
