SVN11X/doc_tesis/_sin_uso/2.Texto/Imag/modulo_dc.jpg

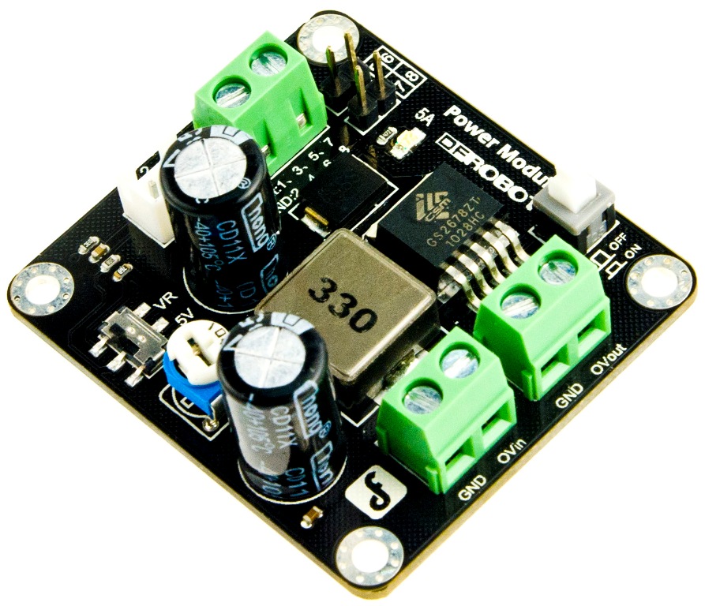
_sin_uso/2.Texto/Imag/modulo_dc.jpg
