SVN11X/doc_tesis/_sin_uso/2.Texto/Imag/ObstacleMap2.png

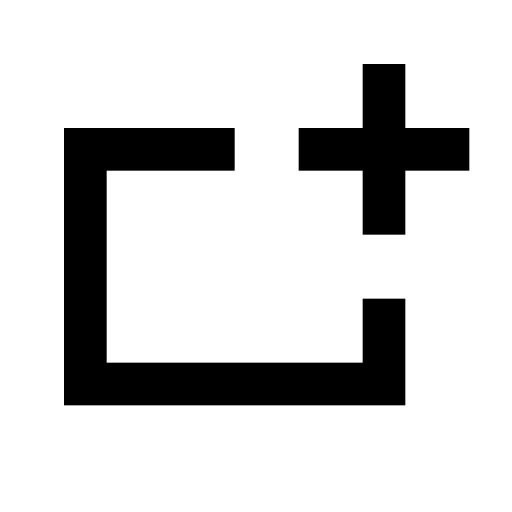
_sin_uso/2.Texto/Imag/ObstacleMap2.png
