SVN11X/doc_tesis/_sin_uso/2.Texto/Imag/obstacles_world_layout.png

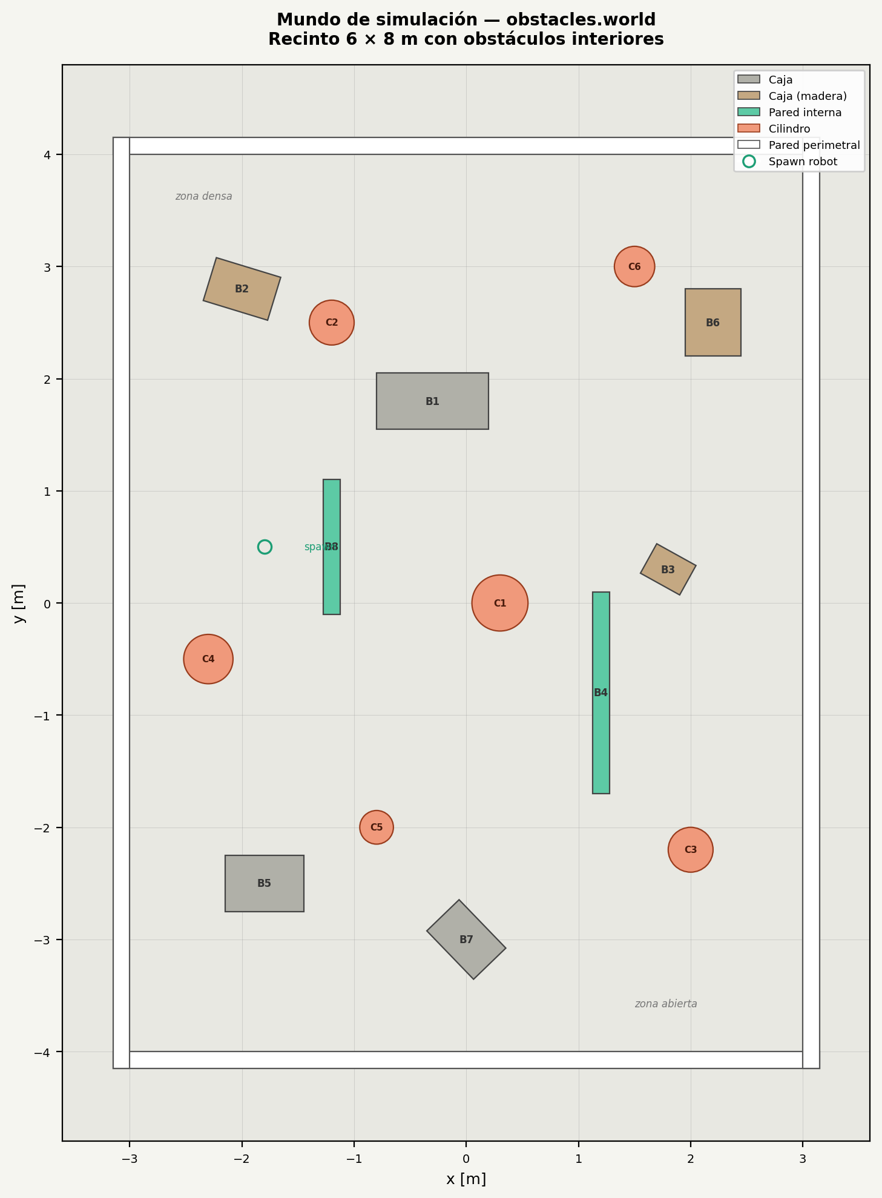
_sin_uso/2.Texto/Imag/obstacles_world_layout.png
