SVN11X/doc_tesis/_sin_uso/2.Texto/Imag/odroid-n2plus4gbnp-1.jpg

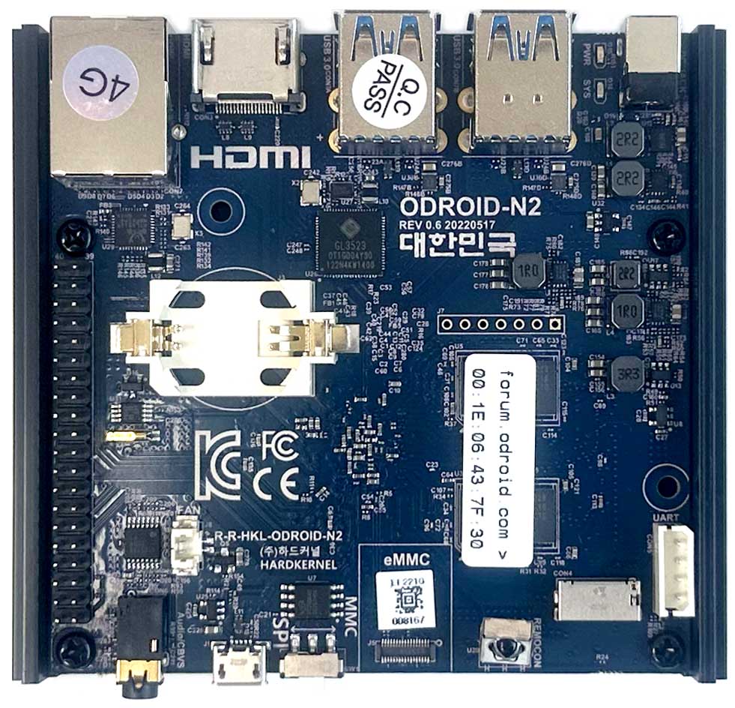
_sin_uso/2.Texto/Imag/odroid-n2plus4gbnp-1.jpg
