SVN11X/doc_tesis/_sin_uso/2.Texto/Imag/pioneer.jpg

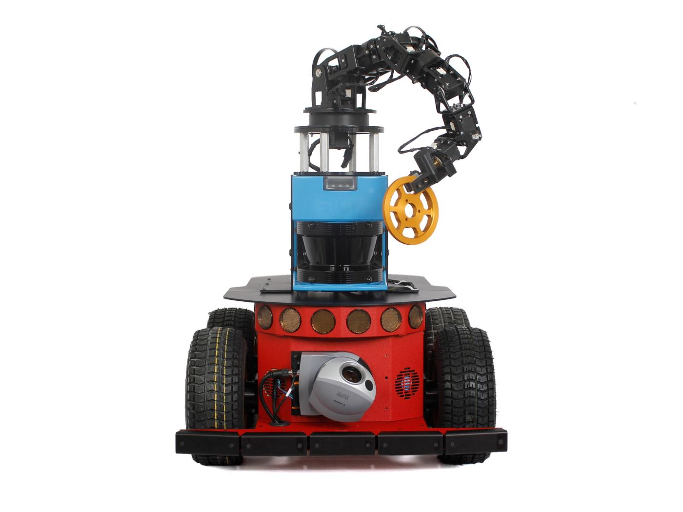
_sin_uso/2.Texto/Imag/pioneer.jpg
