SVN11X/doc_tesis/_sin_uso/2.Texto/Imag/pla_plus.png

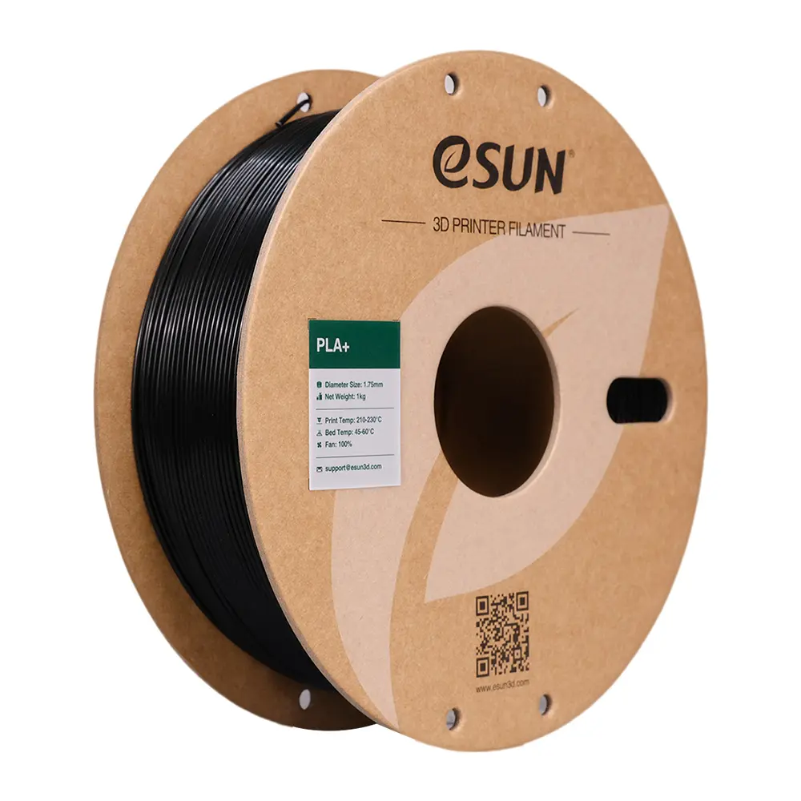
_sin_uso/2.Texto/Imag/pla_plus.png
