SVN11X/doc_tesis/_sin_uso/2.Texto/Imag/retrato_V.png

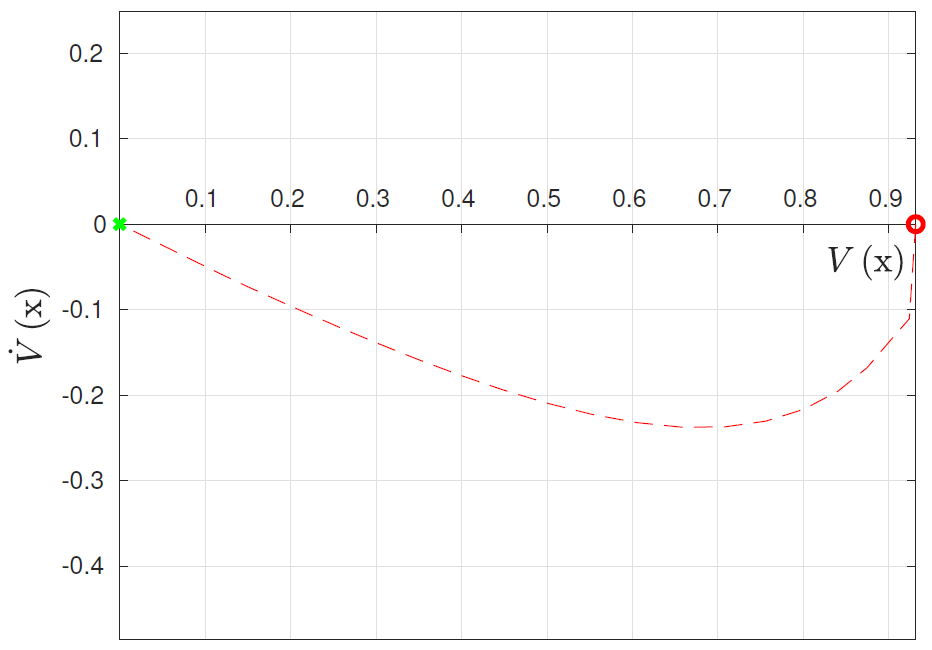
_sin_uso/2.Texto/Imag/retrato_V.png
