SVN11X/doc_tesis/_sin_uso/2.Texto/Imag/retrato_x.png

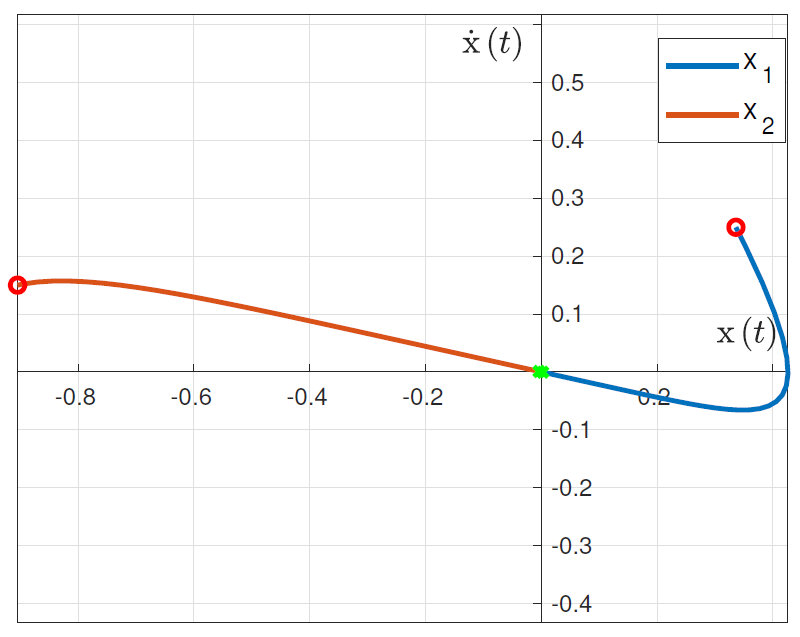
_sin_uso/2.Texto/Imag/retrato_x.png
