SVN11X/doc_tesis/_sin_uso/2.Texto/Imag/robot_vista_isometrica_inf_der.png

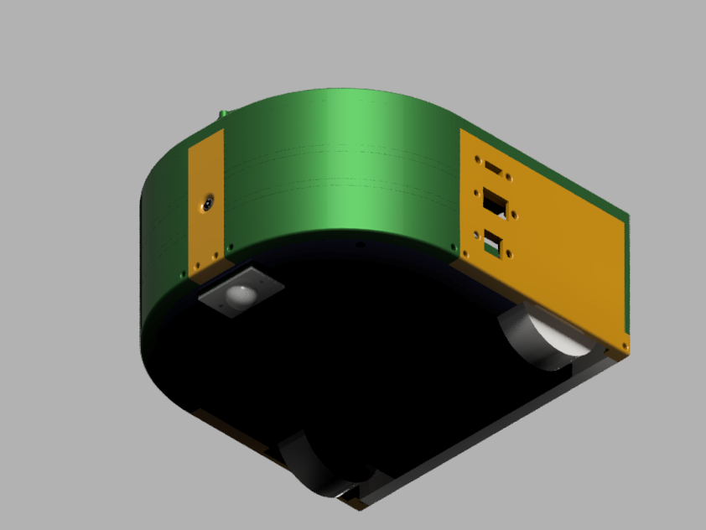
_sin_uso/2.Texto/Imag/robot_vista_isometrica_inf_der.png
