SVN11X/doc_tesis/_sin_uso/2.Texto/Imag/robot_vista_isometrica_sup_der.png

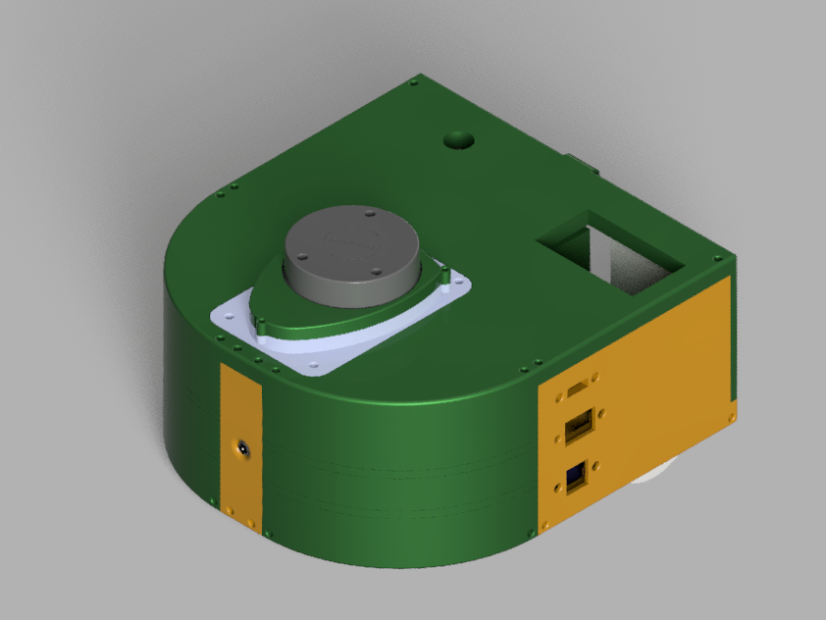
_sin_uso/2.Texto/Imag/robot_vista_isometrica_sup_der.png
