SVN11X/doc_tesis/_sin_uso/2.Texto/Imag/robot_vista_isometrica_sup_izq_posterior.png

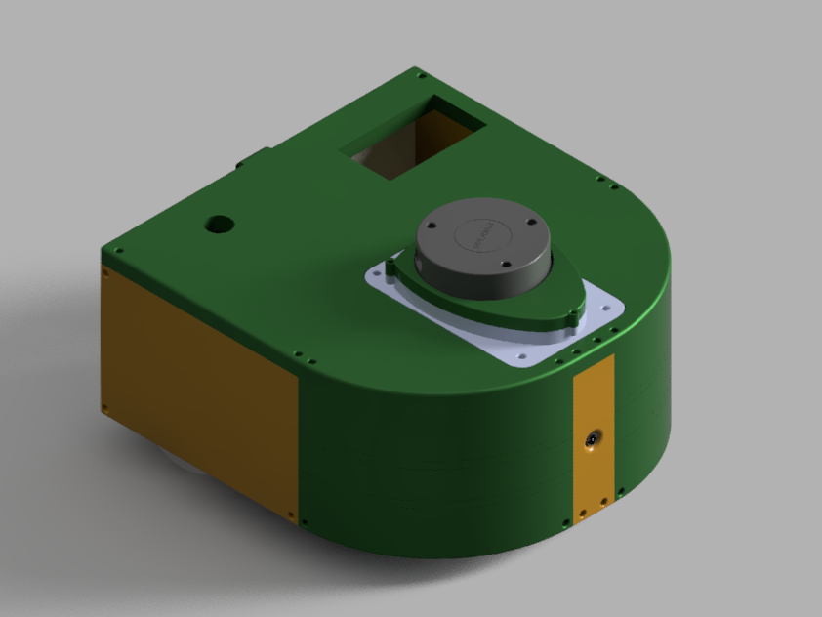
_sin_uso/2.Texto/Imag/robot_vista_isometrica_sup_izq_posterior.png
