SVN11X/doc_tesis/_sin_uso/2.Texto/Imag/rviz_laser_robot.png

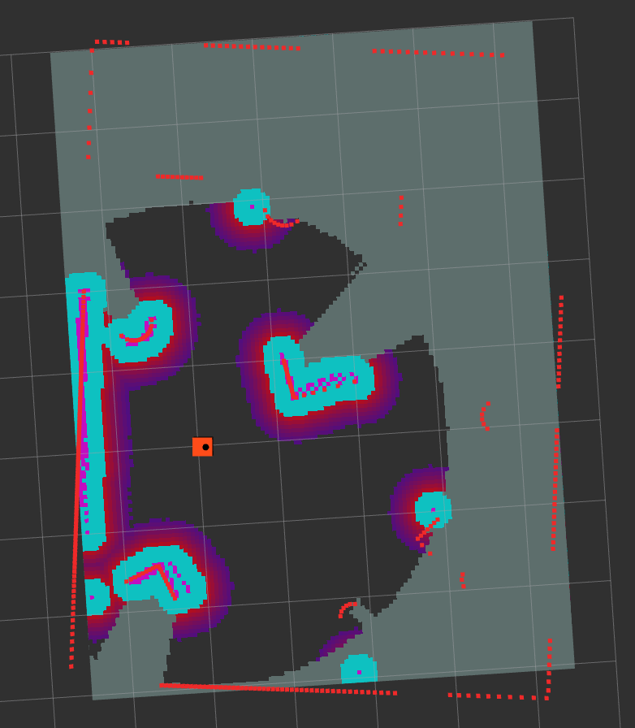
_sin_uso/2.Texto/Imag/rviz_laser_robot.png
