SVN11X/doc_tesis/_sin_uso/2.Texto/Imag/rviz_screenshot_2025_11_01-11_26_00.png

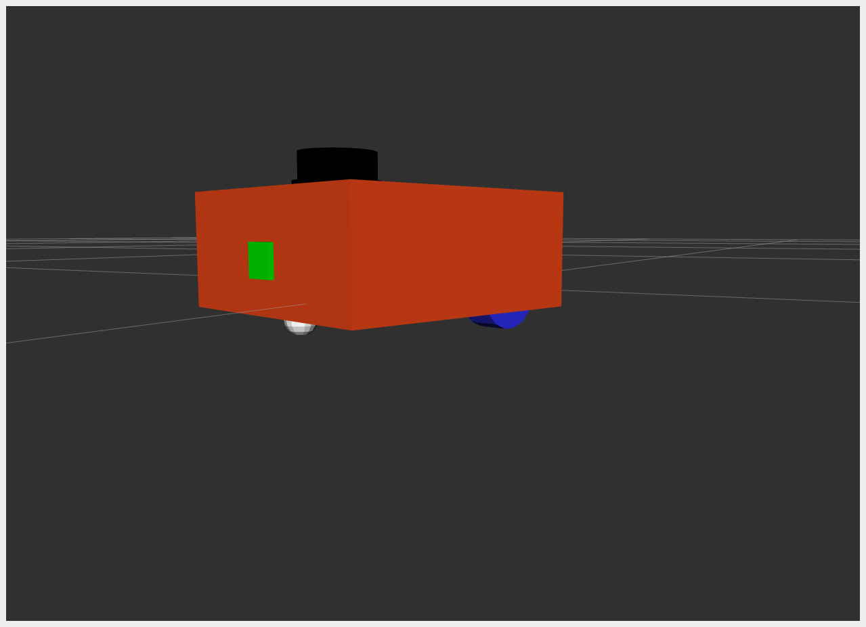
_sin_uso/2.Texto/Imag/rviz_screenshot_2025_11_01-11_26_00.png
