SVN11X/doc_tesis/_sin_uso/2.Texto/Imag/sample_nav_sim_part3.png

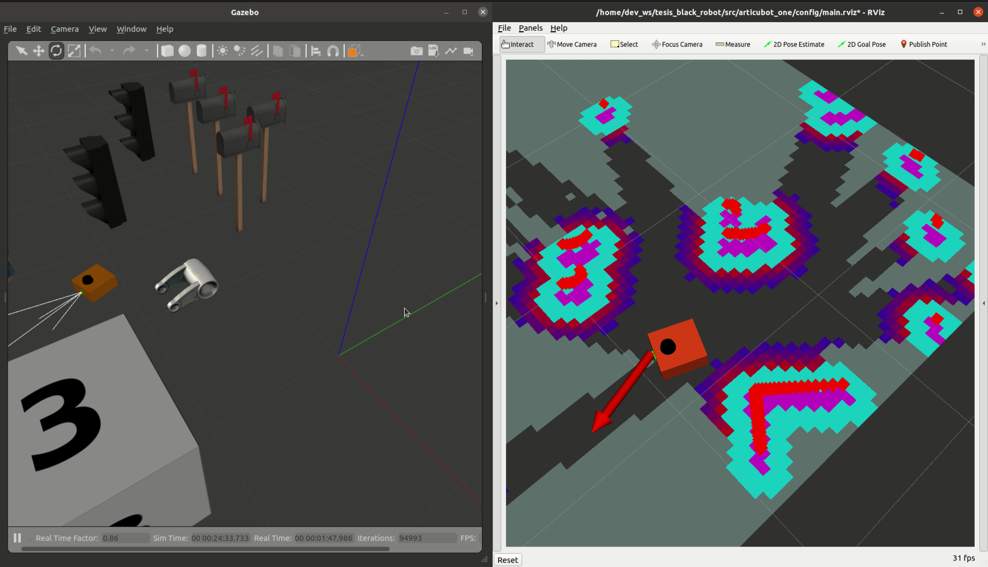
_sin_uso/2.Texto/Imag/sample_nav_sim_part3.png
