SVN11X/doc_tesis/_sin_uso/2.Texto/Imag/sim_entorno_general.jpg

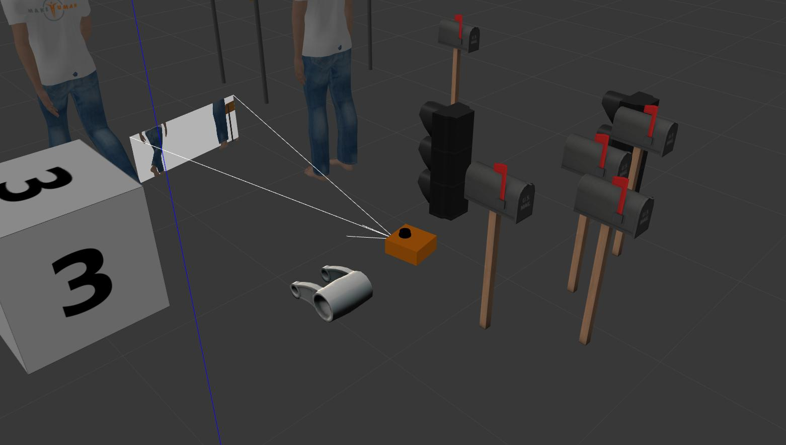
_sin_uso/2.Texto/Imag/sim_entorno_general.jpg
