SVN11X/doc_tesis/_sin_uso/2.Texto/Imag/stability2.png

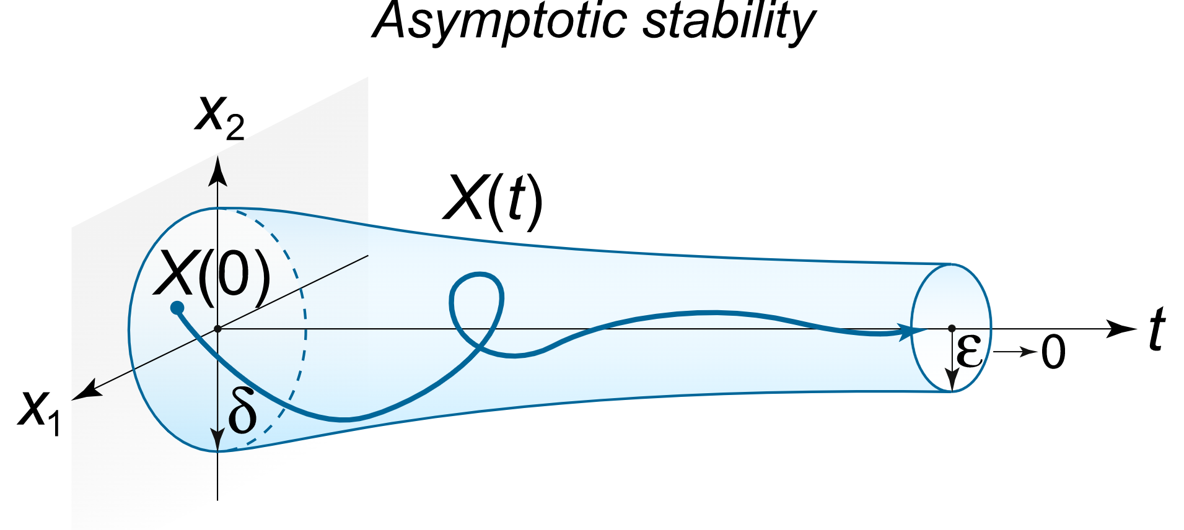
_sin_uso/2.Texto/Imag/stability2.png
