SVN11X/doc_tesis/_sin_uso/2.Texto/Imag/sub-amortiguado-PI.jpg

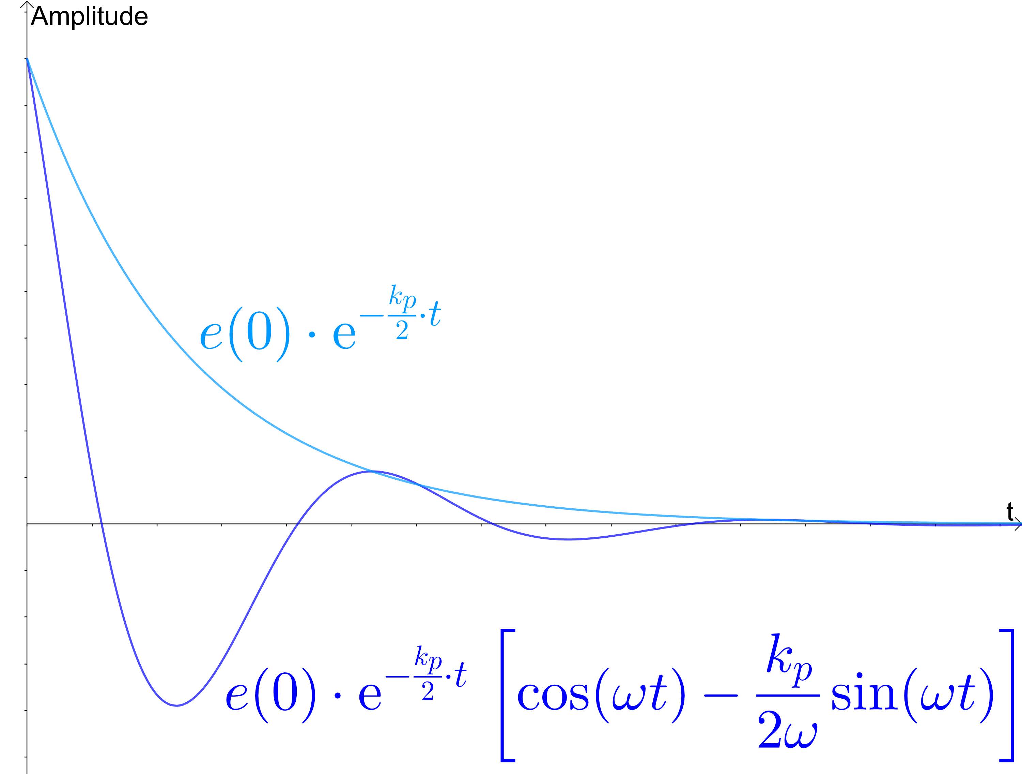
_sin_uso/2.Texto/Imag/sub-amortiguado-PI.jpg
