SVN11X/doc_tesis/_sin_uso/2.Texto/Imag/switch.jpg

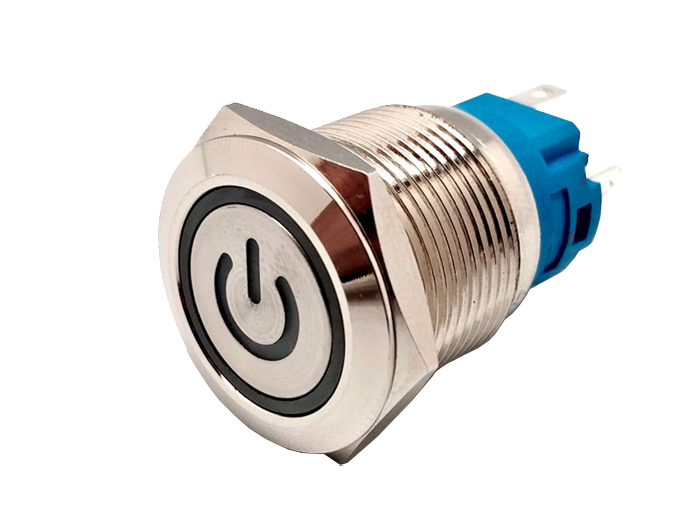
_sin_uso/2.Texto/Imag/switch.jpg
