SVN11X/doc_tesis/_sin_uso/2.Texto/Imag/template_folder.png

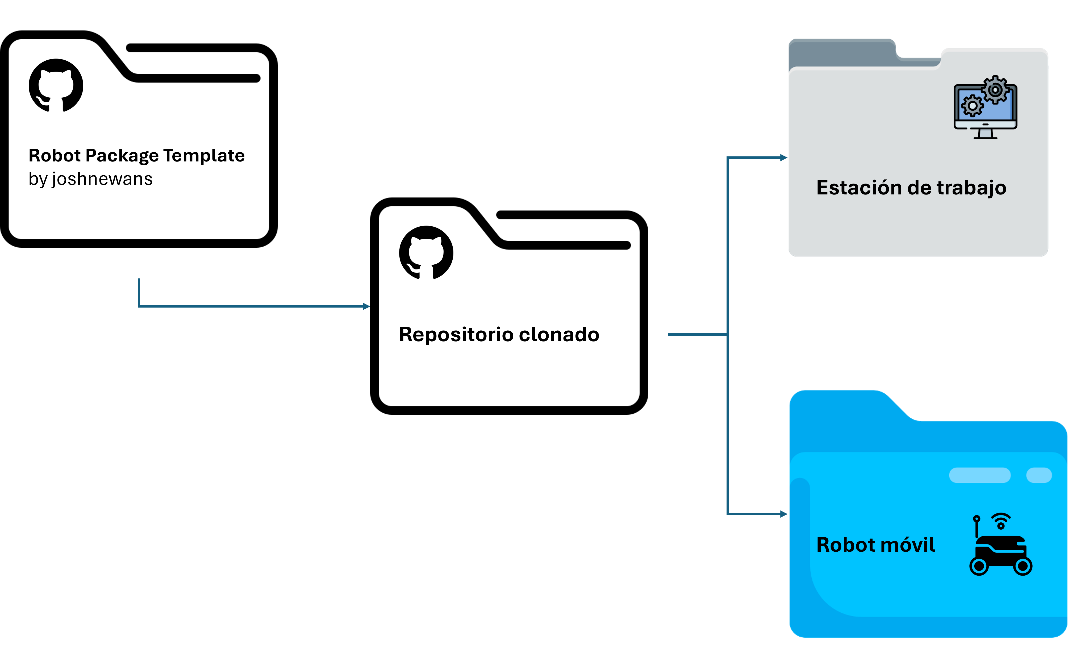
_sin_uso/2.Texto/Imag/template_folder.png
