SVN11X/doc_tesis/_sin_uso/2.Texto/Imag/travel_router.png

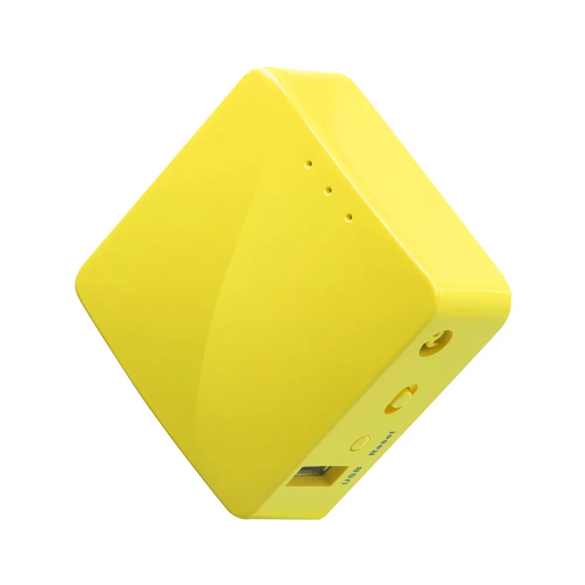
_sin_uso/2.Texto/Imag/travel_router.png
