SVN11X/doc_tesis/_sin_uso/2.Texto/Imag/turtleBot4.jpg

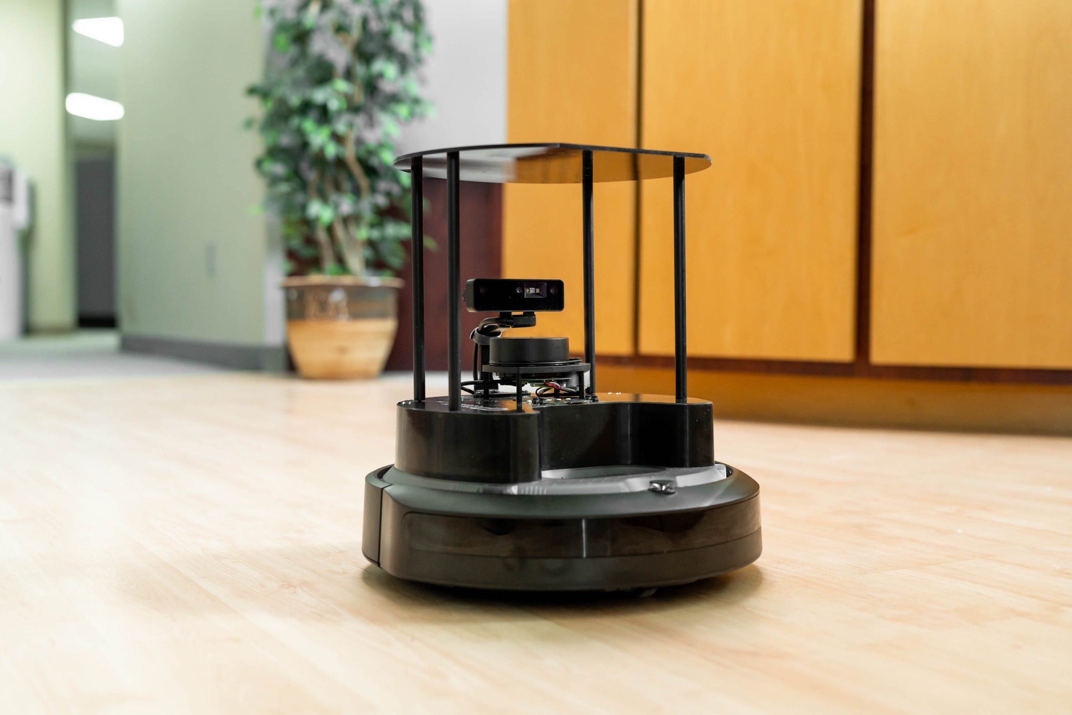
_sin_uso/2.Texto/Imag/turtleBot4.jpg
