SVN11X/doc_tesis/_sin_uso/2.Texto/Imag/wheel_set.png

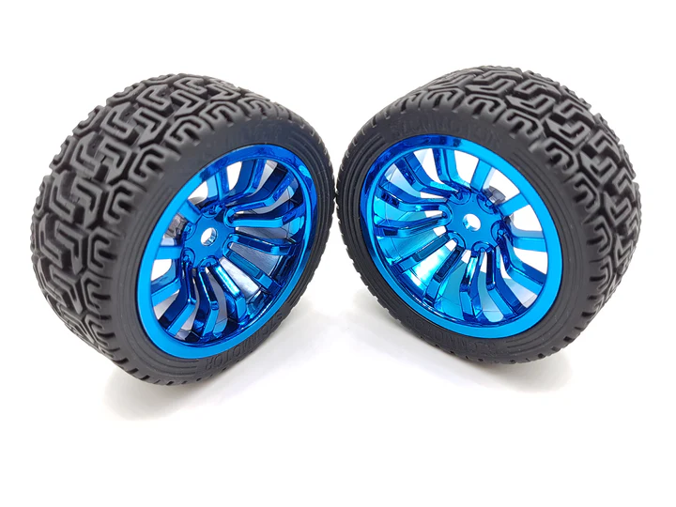
_sin_uso/2.Texto/Imag/wheel_set.png
