SVN11X/doc_tesis/2.Texto/Imag/prueba_real_navegacion_y_exploracion_parte4.png

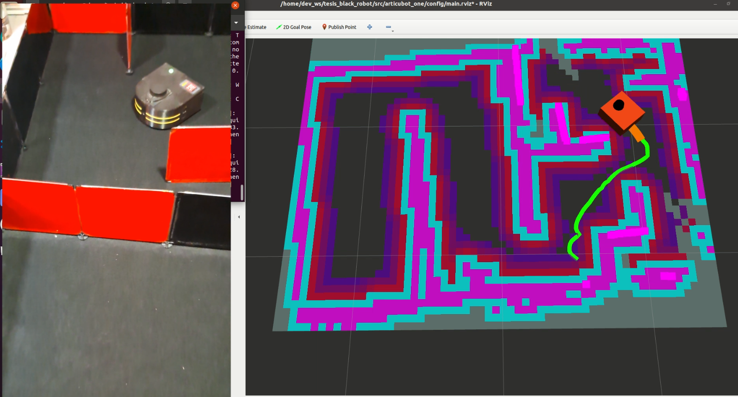
2.Texto/Imag/prueba_real_navegacion_y_exploracion_parte4.png
