SVN11X/doc_tesis/_sin_uso/2.Texto/Imag/prueba_giro.png

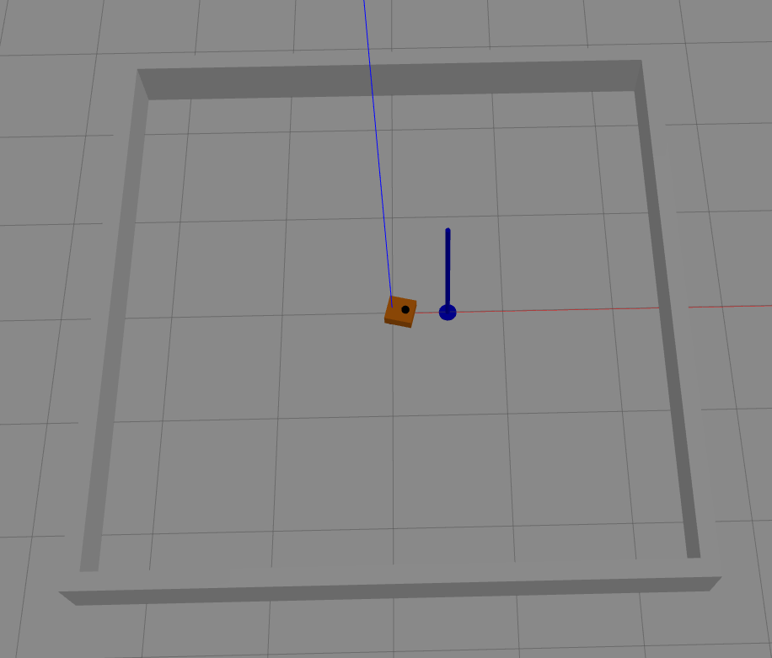
_sin_uso/2.Texto/Imag/prueba_giro.png
