SVN11X/doc_tesis/_sin_uso/2.Texto/Imag/medidas_robot_2d.pdf

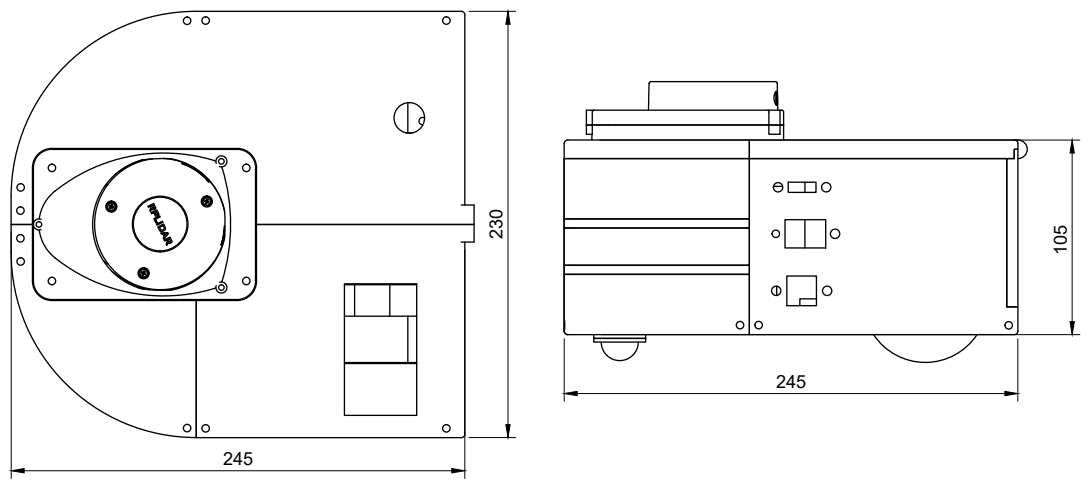
[picture p180: page 1]
