SVN11X/doc_tesis/(list of files, drawings)

Other design files:
2.Texto/Imag/circuit_diagram.fzz
