SVN11X/doc_tesis/(commit log)

2026-05-14 limpio sin videos
    [ObstaculoRobot.xlsx, PosicionRobot.xlsx, VelocityRobot.xlsx, parametros.xlsx, parametros_invalidos.xlsx]
2026-05-18 cambios en grafiico de potencia
2026-05-21 cambios en img flow
2026-05-21 cambios de usb a serial
2026-06-07 cambios entorno a la estructura
2026-06-12 cambios de reduccion
2026-06-12 cambios hasta setup arduino
2026-07-16 mejora imagen circuito
    [circuit_diagram.fzz]
2026-07-16 mejora imagen circuito v2
2026-07-17 mejoras circuito label
    [circuit_diagram.fzz]
2026-09-11 limpieza imag
    [ObstaculoRobot.xlsx, PosicionRobot.xlsx, VelocityRobot.xlsx, movimientos.csv, parametros.xlsx, parametros_invalidos.xlsx]
2026-09-12 ajuste de posicionamiento de tablas figuras y algoritmos
2026-09-13 correcciones de referencias
2026-10-20 correcciones de dos profesores revisores v1
2026-10-21 correcciones de dos profesores revisores v2
2026-10-22 aumento de referencia PI incremental
2026-10-22 Corrige la tabla SLAM y las observaciones de la revisión final
    La tabla SLAM mezcla parámetros con el nodo ejecutado y deja una descripción
    larga sin cortes. Se documentan catorce valores del YAML real, con función y
    unidades; el nodo y el archivo se explican aparte y la tabla se ajusta al
    ancho disponible mediante tabularx.
    Se precisan los escenarios de retardo y el alcance del análisis lineal, las
    conversiones enteras y la actualización condicional de ITerm, el protocolo
    pendiente de metas fijas y la asociación temporal de abortos. Se trata la
    ampliación de ensayos como planificación futura y se conserva el contraste
    binomial calculable con las seis ejecuciones existentes.
    Se in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
2026-10-23 Naming PI incremental y encuadre de los puntos 3 y 8 (v13)
    - PI incremental para la ley ejecutada en Resumen, Abstract, Justificación,
    Cap. 2 a 5, Conclusiones y anexos. PID queda para la familia, el OE2 y los
    nombres del firmware y de sus scripts (regla en la Sec. 4.4.3).
    - Sec. 4.4.3: la forma incremental equivale al PI absoluto sin saturación, por
    lo que su estabilidad es la de un PI clásico con iguales ganancias.
    - Sec. 5.6 y Anexo 8.6: con seis ejecuciones solo seis éxitos permitirían
    rechazar la hipótesis nula, por lo que el número de ensayos se considera
    bajo. Mínimo admisible de 6 a 10 repeticiones (Eurachem, Sec. 5.3.2).
    - Resumen y Abstract: los 53 abortos se asoc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
2026-10-23 archivos de evaluacion
2026-10-23 Revalidación v14 de los comentarios del profesor guía en tesis y cuadro
    Tesis. Los cambios no mueven ninguna página respecto del PDF de Overleaf
    de 169 páginas (cortes de línea y de página comprobados con una
    compilación local).
    Sec. 4.4.3. La primera razón dice ahora que el PI incremental utilizado es
    uno de los controladores más usados en robótica móvil, seguida de sus
    referencias (puntos 1 y 2).
    Sec. 3.7 y Fig. 3.3. El nombre PID queda para la familia de controladores.
    Nomenclatura. Ko y Tsim se refieren al controlador y no al PID.
    Sec. 5.6 y Anexo 8.6. El número de ensayos se considera muy bajo, como
    pide el profesor guía para el punto 8.
    Cuadro de observaciones, sin mar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
2026-10-23 Revalidación v15 de los comentarios del profesor guía en tesis y cuadro
    Base: main 230c039 y PDF de Overleaf de 169 páginas compilado el 23/10 a
    las 08:51. Ningún cambio mueve páginas. Una compilación local con Liberation
    Sans, que reproduce los cortes de línea de Overleaf, conserva el número de
    líneas de cada párrafo editado y todos los cortes de página. Las páginas que
    indica el cuadro coinciden con ese PDF.
    Puntos 1 y 2. Sin cambios de fondo. La frase pedida y sus referencias siguen
    en la Sec. 4.4.3, p. 49.
    Punto 3. Sec. 4.4.3, p. 51: el PI incremental no es una ley nueva, y su
    equivalencia con el PI clásico se respalda también con Åström y Hägglund,
    Sec. 13.4, la misma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
2026-10-23 mejoras cuadro de observacxiones
2026-10-23 Revalidación v17 del cuadro con la versión corta del alumno
    Base: main 0962c48 y la versión del cuadro que el alumno entregó el 23/10,
    sin la lista de referencias al final. Reemplaza al parche v16. Se respeta
    el criterio del alumno: no alargar el cuadro y no agradecer en el
    documento. El cuadro crece en 35 palabras en total.
    Introducción. Decía «Al final se listan las referencias citadas en las
    respuestas», pero esa lista ya no está. Ahora dice que las referencias
    citadas están en la bibliografía de la tesis. Las 14 obras que cita el
    cuadro aparecen en esa bibliografía.
    Punto 3, fila 3. La fila empezaba con «Su estabilidad», sin decir de qué
    ley. Se agrega una oración con l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
2026-10-23 Marcadores PDF de portada, autorización y nota; numeración i, ii, iii; líneas punteadas del formulario
    Claude-Session: https://claude.ai/code/session_01QCMchFPAbZaG3L2agRPZHM
